crasni/rotary-inverted-pendulum/docs/results/hardware/pid/20261107_161650/note.md

First PID hardware pass. Preset pid_my_rig_lqr_match.json (delay predictor, gains from the LQR solution, Ki = 10).
