crasni/rotary-inverted-pendulum/docs/results/hardware/ppo/20261109_013006/note.md

ppo_ecF (+ random delay and arm lag): no runaway spin, but recovery too slow (caught at 10.7 s).
