crasni/rotary-inverted-pendulum/docs/results/hardware/sac/20261107_163412/note.md

Stopped by hand. Pendulum reading frozen at 179.9° while the arm swung ±4 rad/s: encoder stall or pendulum held. Not a policy result.
