crasni/rotary-inverted-pendulum/docs/results/hardware/sac/20261109_004522/note.md

Encoder fault (bits=2) latched before the start; no policy ticks. Not a policy result.
