crasni/rotary-inverted-pendulum/docs/run-history/runs_index.csv

run | family | when | meta_files | has_policy | policy_sha256 | n_files | mb_total | mb_pruned | checkpoint | stage | deterministic | episodes_requested | episodes_completed | stop_reason | started | episodes | successes | mean_balanced_frac | best_longest_balance_s | stop_reasons | command | algorithm | params | config | duration | source | seed | learning_rate | method | parent | steps | n_batches | learn | real_fraction
accel_chirp_real_003 | accel_chirp_real | 2026-11-06 21:21 (mtime) | metadata.json | 0 |  | 4 | 0.21 | 0.0
accel_chirp_sim_003 | accel_chirp_sim | 2026-11-06 21:18 (mtime) | metadata.json | 0 |  | 3 | 0.16 | 0.0
accel_reversal_1 | accel_reversal_1 | 2026-11-07 20:17 (mtime) | metadata.json | 0 |  | 2 | 0.02 | 0.0
accel_reversal_2 | accel_reversal_2 | 2026-11-07 20:17 (mtime) | metadata.json | 0 |  | 4 | 0.18 | 0.0
accel_reversal_sim | accel_reversal_sim | 2026-11-07 20:15 (mtime) | metadata.json | 0 |  | 3 | 0.12 | 0.0
accel_step_full_1 | accel_step_full_1 | 2026-11-07 20:12 (mtime) | metadata.json | 0 |  | 2 | 0.01 | 0.0
accel_step_real_008 | accel_step_real | 2026-11-06 21:18 (mtime) | metadata.json | 0 |  | 4 | 0.16 | 0.0
accel_step_sim_008 | accel_step_sim | 2026-11-06 21:17 (mtime) | metadata.json | 0 |  | 3 | 0.11 | 0.0
archive/curriculum/e03_v2_lqrbalance_det | archive | 2026-11-07 23:32 (mtime) | batch.json | 0 |  | 1 | 0.0 | 0.0 | runs/curriculum/versions/v2/policy.zip | lqr_balance | True | 4 | 0 | NonFiniteFeedback: Non-finite feedback | 2026-11-07T23:32:10
archive/curriculum/e03b_v2_lqrbalance_det | archive | 2026-11-07 23:34 (mtime) | batch.json | 0 |  | 1 | 0.0 | 0.0 | runs/curriculum/versions/v2/policy.zip | lqr_balance | True | 4 | 0 | NonFiniteFeedback: Non-finite feedback (firmware fault bits=2: encoder) | 2026-11-07T23:34:47
archive/curriculum/e03c_v2_lqrbalance_det | archive | 2026-11-07 23:57 (mtime) | batch.json | 0 |  | 1 | 0.0 | 0.0 | runs/curriculum/versions/v2/policy.zip | lqr_balance | True | 4 | 0 | NonFiniteFeedback: Non-finite feedback (firmware fault bits=2: encoder) | 2026-11-07T23:57:11
archive/custom_lqrdither_20261107_204719 | archive | 2026-11-07 20:47 | run.json summary.json | 0 |  | 3 | 0.0 | 0.0 | docs/results/sac_focused_policy.zip |  |  |  |  |  |  | 1 | 0 |  |  | RuntimeError: Firmware safety fault latched (bits=2); inspect before resetting | hardware | custom | configs/my_rig.json | configs/custom_lqr_dither_10.json | 15.0
archive/custom_lqrdither_20261107_205245 | archive | 2026-11-07 20:52 | run.json summary.json | 0 |  | 3 | 0.0 | 0.0 | docs/results/sac_focused_policy.zip |  |  |  |  |  |  | 1 | 0 |  |  | SerialException: [Errno 2] could not open port /dev/ttyUSB0: [Errno 2] No such file or directory: '/dev/ttyUSB0' | hardware | custom | configs/my_rig.json | configs/custom_lqr_dither_10.json | 15.0
archive/lqr_coupling_delay_20261108_000207 | archive | 2026-11-08 00:02 | run.json summary.json | 0 |  | 3 | 0.01 | 0.0 | docs/results/sac_focused_policy.zip |  |  |  |  |  |  | 1 | 0 | 0.34 | 1.08 | RuntimeError: Non-finite feedback (firmware fault bits=2, encoder) | hardware | lqr | configs/my_rig.json | configs/lqr_my_rig_coupling_delay.json | 15.0
archive/lqr_coupling_delay_20261108_000854 | archive | 2026-11-08 00:08 | run.json summary.json | 0 |  | 3 | 0.0 | 0.0 | docs/results/sac_focused_policy.zip |  |  |  |  |  |  | 1 | 0 |  |  | SerialException: [Errno 2] could not open port /dev/ttyUSB0: [Errno 2] No such file or directory: '/dev/ttyUSB0' | hardware | lqr | configs/my_rig.json | configs/lqr_my_rig_coupling_delay.json | 15.0
archive/lqr_coupling_delay_20261108_000913 | archive | 2026-11-08 00:09 | run.json summary.json | 0 |  | 3 | 0.01 | 0.0 | docs/results/sac_focused_policy.zip |  |  |  |  |  |  | 1 | 0 | 0.262 | 0.74 | RuntimeError: Non-finite feedback (firmware fault bits=2, encoder) | hardware | lqr | configs/my_rig.json | configs/lqr_my_rig_coupling_delay.json | 15.0
archive/lqr_coupling_delay_20261108_000928 | archive | 2026-11-08 00:09 | run.json summary.json | 0 |  | 3 | 0.01 | 0.0 | docs/results/sac_focused_policy.zip |  |  |  |  |  |  | 1 | 0 | 0.173 | 0.44 | RuntimeError: Non-finite feedback (firmware fault bits=2, encoder) | hardware | lqr | configs/my_rig.json | configs/lqr_my_rig_coupling_delay.json | 15.0
archive/lqr_coupling_delay_20261108_000953 | archive | 2026-11-08 00:09 | run.json summary.json | 0 |  | 3 | 0.01 | 0.0 | docs/results/sac_focused_policy.zip |  |  |  |  |  |  | 1 | 0 | 0.006 | 0.02 | RuntimeError: Non-finite feedback (firmware fault bits=2, encoder) | hardware | lqr | configs/my_rig.json | configs/lqr_my_rig_coupling_delay.json | 15.0
archive/lqr_coupling_delay_20261108_001013 | archive | 2026-11-08 00:10 | run.json summary.json | 0 |  | 3 | 0.01 | 0.0 | docs/results/sac_focused_policy.zip |  |  |  |  |  |  | 1 | 0 | 0.072 | 0.14 | RuntimeError: Non-finite feedback (firmware fault bits=2, encoder) | hardware | lqr | configs/my_rig.json | configs/lqr_my_rig_coupling_delay.json | 15.0
archive/lqr_coupling_delay_20261108_001032 | archive | 2026-11-08 00:10 | run.json summary.json | 0 |  | 3 | 0.01 | 0.0 | docs/results/sac_focused_policy.zip |  |  |  |  |  |  | 1 | 0 | 0.025 | 0.06 | RuntimeError: Non-finite feedback (firmware fault bits=2, encoder) | hardware | lqr | configs/my_rig.json | configs/lqr_my_rig_coupling_delay.json | 15.0
archive/lqr_coupling_delay_20261108_001527 | archive | 2026-11-08 00:15 | run.json summary.json | 0 |  | 3 | 0.01 | 0.0 | docs/results/sac_focused_policy.zip |  |  |  |  |  |  | 1 | 0 | 0.0 | 0.0 | RuntimeError: Non-finite feedback (firmware fault bits=2, encoder) | hardware | lqr | configs/my_rig.json | configs/lqr_my_rig_coupling_delay.json | 15.0
archive/lqr_coupling_delay_20261108_001543. | archive | 2026-11-08 00:15 | run.json summary.json | 0 |  | 3 | 0.01 | 0.0 | docs/results/sac_focused_policy.zip |  |  |  |  |  |  | 1 | 0 | 0.025 | 0.06 | RuntimeError: Non-finite feedback (firmware fault bits=2, encoder) | hardware | lqr | configs/my_rig.json | configs/lqr_my_rig_coupling_delay.json | 15.0
archive/lqr_coupling_delay_20261108_001600 | archive | 2026-11-08 00:16 | run.json summary.json | 0 |  | 3 | 0.0 | 0.0 | docs/results/sac_focused_policy.zip |  |  |  |  |  |  | 1 | 0 |  |  | RuntimeError: Powered run cancelled | hardware | lqr | configs/my_rig.json | configs/lqr_my_rig_coupling_delay.json | 15.0
archive/lqr_coupling_delay_20261108_001608 | archive | 2026-11-08 00:16 | run.json summary.json | 0 |  | 3 | 0.01 | 0.0 | docs/results/sac_focused_policy.zip |  |  |  |  |  |  | 1 | 0 | 0.0 | 0.0 | RuntimeError: Non-finite feedback (firmware fault bits=2, encoder) | hardware | lqr | configs/my_rig.json | configs/lqr_my_rig_coupling_delay.json | 15.0
archive/lqr_coupling_delay_20261108_025531 | archive | 2026-11-08 02:55 | run.json summary.json | 0 |  | 3 | 0.0 | 0.0 | docs/results/sac_focused_policy.zip |  |  |  |  |  |  | 1 | 0 |  |  | RuntimeError: Firmware safety fault latched (bits=2); inspect before resetting | hardware | lqr | configs/my_rig.json | configs/lqr_my_rig_coupling_delay.json | 15.0
archive/lqr_coupling_delay_20261108_025545 | archive | 2026-11-08 02:55 | run.json summary.json | 0 |  | 3 | 0.0 | 0.0 | docs/results/sac_focused_policy.zip |  |  |  |  |  |  | 1 | 0 |  |  | RuntimeError: Firmware safety fault latched (bits=2); inspect before resetting | hardware | lqr | configs/my_rig.json | configs/lqr_my_rig_coupling_delay.json | 15.0
archive/lqr_coupling_delay_20261108_025813 | archive | 2026-11-08 02:58 | run.json summary.json | 0 |  | 3 | 0.02 | 0.0 | docs/results/sac_focused_policy.zip |  |  |  |  |  |  | 1 | 0 | 0.019 | 0.08 | RuntimeError: Non-finite feedback (firmware fault bits=2, encoder) | hardware | lqr | configs/my_rig.json | configs/lqr_my_rig_coupling_delay.json | 15.0
archive/lqr_coupling_delay_20261108_025945 | archive | 2026-11-08 02:59 | run.json summary.json | 0 |  | 3 | 0.0 | 0.0 | docs/results/sac_focused_policy.zip |  |  |  |  |  |  | 1 | 0 |  |  | RuntimeError: Firmware READY handshake failed | hardware | lqr | configs/my_rig.json | configs/lqr_my_rig_coupling_delay.json | 15.0
archive/lqr_hw_17 | archive | 2026-11-07 02:04 (mtime) | run.json summary.json | 0 |  | 3 | 0.02 | 0.0 | docs/results/sac_focused_policy.zip |  |  |  |  |  |  | 1 | 0 | 0.143 | 0.32 | RuntimeError: Non-finite feedback | hardware | lqr | configs/my_rig.json | configs/lqr_my_rig_observed.json | 15.0
archive/lqr_swing_20261107_025003 | archive | 2026-11-07 02:50 | run.json summary.json | 0 |  | 3 | 0.09 | 0.0 | docs/results/sac_focused_policy.zip |  |  |  |  |  |  | 1 | 0 | 0.11 | 1.0 | KeyboardInterrupt: | hardware | lqr | configs/my_rig.json | configs/lqr_my_rig_swing.json | 30.0
archive/sac_W2_20261107_205411 | archive | 2026-11-07 20:54 | run.json summary.json | 0 |  | 3 | 0.0 | 0.0 | runs/sac_finetune/W_rig/W2_100k.zip |  |  |  |  |  |  | 1 | 0 |  |  | RuntimeError: Start requires a physically centered arm and still hanging pendulum | hardware | sac | configs/my_rig.json | configs/sac_my_rig.json | 15.0
archive/sac_v2m2_20261108_031006 | archive | 2026-11-08 03:10 | run.json | 0 |  | 1 | 0.0 | 0.0 | runs/curriculum/versions/v2m2/policy.zip |  |  |  |  |  |  |  |  |  |  |  | hardware | sac | configs/my_rig.json | configs/sac_my_rig.json | 15.0
archive/sac_v2m2_20261108_031340 | archive | 2026-11-08 03:13 | run.json summary.json | 0 |  | 3 | 0.0 | 0.0 | runs/curriculum/versions/v2m2_runner/policy.zip |  |  |  |  |  |  | 1 | 0 |  |  | RuntimeError: Firmware safety fault latched (bits=2); inspect before resetting | hardware | sac | configs/my_rig.json | configs/sac_my_rig.json | 15.0
archive/sac_v2m2_20261108_031741 | archive | 2026-11-08 03:17 | run.json | 0 |  | 1 | 0.0 | 0.0 | runs/curriculum/versions/v2m2/policy.zip |  |  |  |  |  |  |  |  |  |  |  | hardware | sac | configs/my_rig.json | configs/sac_my_rig.json | 15.0
archive/sac_v2m2_20261108_031758 | archive | 2026-11-08 03:17 | run.json summary.json | 0 |  | 3 | 0.0 | 0.0 | runs/curriculum/versions/v2m2_runner/policy.zip |  |  |  |  |  |  | 1 | 0 |  |  | KeyboardInterrupt: | hardware | sac | configs/my_rig.json | configs/sac_my_rig.json | 15.0
archive/sac_v2m2_20261108_031911 | archive | 2026-11-08 03:19 | run.json summary.json | 0 |  | 3 | 0.03 | 0.0 | runs/curriculum/versions/v2m2_runner/policy.zip |  |  |  |  |  |  | 1 | 0 | 0.0 | 0.0 | KeyboardInterrupt: | hardware | sac | configs/my_rig.json | configs/sac_my_rig.json | 15.0
archive/sac_v2m2_20261108_031931 | archive | 2026-11-08 03:19 | run.json summary.json | 0 |  | 3 | 0.0 | 0.0 | runs/curriculum/versions/v2m2_runner/policy.zip |  |  |  |  |  |  | 1 | 0 |  |  | RuntimeError: Powered run cancelled | hardware | sac | configs/my_rig.json | configs/sac_my_rig.json | 15.0
archive/sac_v2m2_20261108_032213 | archive | 2026-11-08 03:22 | run.json | 0 |  | 1 | 0.0 | 0.0 | runs/curriculum/versions/v2m2/policy.zip |  |  |  |  |  |  |  |  |  |  |  | hardware | sac | configs/my_rig.json | configs/sac_my_rig.json | 15.0
archive/sac_v6b_20261108_041929 | archive | 2026-11-08 04:19 | run.json | 0 |  | 1 | 0.0 | 0.0 | runs/curriculum/versions/v6b_runner/policy.zip |  |  |  |  |  |  |  |  |  |  |  | hardware | sac | configs/my_rig.json | configs/sac_my_rig.json | 15.0
archive/sac_v6b_20261108_041936 | archive | 2026-11-08 04:19 | run.json | 0 |  | 1 | 0.0 | 0.0 | runs/curriculum/versions/v6b_runner/policy.zip |  |  |  |  |  |  |  |  |  |  |  | hardware | sac | configs/my_rig.json | configs/sac_my_rig.json | 15.0
before_changes_20261106_211040/accel_chirp_real_002 | before_changes | 2026-11-06 21:10 | metadata.json | 0 |  | 4 | 0.21 | 0.0
before_changes_20261106_211040/accel_chirp_sim_002 | before_changes | 2026-11-06 21:10 | metadata.json | 0 |  | 3 | 0.17 | 0.0
before_changes_20261106_211040/accel_step_real | before_changes | 2026-11-06 21:10 | metadata.json | 0 |  | 2 | 0.01 | 0.0
before_changes_20261106_211040/accel_step_real_008 | before_changes | 2026-11-06 21:10 | metadata.json | 0 |  | 4 | 0.16 | 0.0
before_changes_20261106_211040/accel_step_sim | before_changes | 2026-11-06 21:10 | metadata.json | 0 |  | 3 | 0.11 | 0.0
before_changes_20261106_211040/accel_step_sim_008 | before_changes | 2026-11-06 21:10 | metadata.json | 0 |  | 3 | 0.11 | 0.0
before_changes_20261106_211040/sysid_holdout_01 | before_changes | 2026-11-06 21:10 | metadata.json | 0 |  | 5 | 0.14 | 0.0
before_changes_20261106_211040/sysid_train_01 | before_changes | 2026-11-06 21:10 | metadata.json | 0 |  | 8 | 0.37 | 0.0
curriculum/b00_v1_balance_det | curriculum/batches | 2026-11-07 22:33 (mtime) | batch.json summary.json | 0 |  | 5 | 0.1 | 0.0 | runs/sac_finetune/V1/policy.zip | balance | True | 4 | 3 | SessionStop: lift failed 3 times in a row | 2026-11-07T22:32:31 | 3 | 0 |  | 0.0 | lift_timeout
curriculum/b02_v1_lqrbalance_det | curriculum/batches | 2026-11-07 22:47 (mtime) | batch.json summary.json | 0 |  | 9 | 0.3 | 0.0 | runs/sac_finetune/V1/policy.zip | lqr_balance | True | 4 | 4 | completed | 2026-11-07T22:45:05 | 4 | 0 | 0.186 | 1.42 | duration;lift_timeout
curriculum/b03_v1_lqrbalance_train | curriculum/batches | 2026-11-07 22:52 (mtime) | batch.json summary.json | 0 |  | 9 | 0.33 | 0.0 | runs/sac_finetune/V1/policy.zip | lqr_balance | False | 10 | 5 | SessionStop: lift failed 3 times in a row | 2026-11-07T22:49:50 | 5 | 0 | 0.39 | 2.86 | duration;lift_timeout
curriculum/b04_v1_lqrbalance_train | curriculum/batches | 2026-11-07 22:58 (mtime) | batch.json summary.json | 0 |  | 21 | 0.85 | 0.0 | runs/sac_finetune/V1/policy.zip | lqr_balance | False | 10 | 10 | KeyboardInterrupt: | 2026-11-07T22:53:30 | 10 | 0 | 0.274 | 2.76 | duration;lift_timeout
curriculum/b05_v1_lqrbalance_train | curriculum/batches | 2026-11-07 23:16 (mtime) | batch.json summary.json | 0 |  | 28 | 0.62 | 0.0 | runs/sac_finetune/V1/policy.zip | lqr_balance | False | 20 | 16 | SessionStop: lift failed 3 times in a row | 2026-11-07T23:09:51 | 16 | 0 | 0.342 | 0.64 | fell;lift_timeout
curriculum/b06_v2m2_hanging_train | curriculum/batches | 2026-11-08 03:31 (mtime) | batch.json summary.json | 0 |  | 22 | 1.16 | 0.0 | runs/curriculum/versions/v2m2/policy.zip | hanging | False | 10 | 10 | completed | 2026-11-08T03:27:55 | 10 | 0 | 0.236 | 2.66 | duration
curriculum/b07_v3b_hanging_train | curriculum/batches | 2026-11-08 03:51 (mtime) | batch.json summary.json | 0 |  | 22 | 1.14 | 0.0 | runs/curriculum/versions/v3b/policy.zip | hanging | False | 10 | 10 | completed | 2026-11-08T03:48:44 | 10 | 0 | 0.377 | 10.28 | duration
curriculum/b08_v3b_hanging_train | curriculum/batches | 2026-11-08 04:06 (mtime) | batch.json summary.json | 0 |  | 22 | 1.15 | 0.0 | runs/curriculum/versions/v3b/policy.zip | hanging | False | 10 | 10 | completed | 2026-11-08T04:03:18 | 10 | 0 | 0.251 | 5.9 | duration
curriculum/b09_v9_hanging_train | curriculum/batches | 2026-11-08 21:07 (mtime) | batch.json summary.json | 0 |  | 22 | 1.17 | 0.0 | runs/curriculum/versions/v9/policy.zip | hanging | False | 10 | 10 | completed | 2026-11-08T21:04:17 | 10 | 0 | 0.12 | 3.1 | duration
curriculum/e01_v1_lqrbalance_det | curriculum/batches | 2026-11-07 23:02 (mtime) | batch.json summary.json | 0 |  | 10 | 0.31 | 0.0 | runs/curriculum/versions/v1/policy.zip | lqr_balance | True | 4 | 4 | completed | 2026-11-07T23:01:00 | 4 | 0 | 0.094 | 1.04 | duration
curriculum/e02_v1_hanging_det | curriculum/batches | 2026-11-07 23:04 (mtime) | batch.json summary.json | 0 |  | 10 | 0.62 | 0.0 | runs/curriculum/versions/v1/policy.zip | hanging | True | 4 | 4 | completed | 2026-11-07T23:02:52 | 4 | 0 | 0.009 | 0.3 | duration
curriculum/e04_v2_lqrbalance_det | curriculum/batches | 2026-11-08 03:02 (mtime) | batch.json summary.json | 0 |  | 10 | 0.08 | 0.0 | runs/curriculum/versions/v2/policy.zip | lqr_balance | True | 4 | 4 | completed | 2026-11-08T03:01:59 | 4 | 0 | 0.43 | 0.74 | fell
curriculum/e05_v2m2_lqrbalance_det | curriculum/batches | 2026-11-08 03:06 (mtime) | batch.json summary.json | 0 |  | 10 | 0.23 | 0.0 | runs/curriculum/versions/v2m2/policy.zip | lqr_balance | True | 4 | 4 | completed | 2026-11-08T03:04:54 | 4 | 0 | 1.0 | 6.0 | duration
curriculum/e06_v2m2_hanging_det | curriculum/batches | 2026-11-08 03:09 (mtime) | batch.json summary.json | 0 |  | 10 | 0.59 | 0.0 | runs/curriculum/versions/v2m2/policy.zip | hanging | True | 4 | 4 | completed | 2026-11-08T03:08:08 | 4 | 0 | 0.53 | 13.32 | duration
curriculum/e06_v2m2_hanging_det_2 | curriculum/batches | 2026-11-08 03:27 (mtime) | batch.json summary.json | 0 |  | 10 | 0.61 | 0.0 | runs/curriculum/versions/v2m2/policy.zip | hanging | True | 4 | 4 | completed | 2026-11-08T03:25:19 | 4 | 0 | 0.212 | 3.72 | duration
curriculum/e07_v3_hanging_det | curriculum/batches | 2026-11-08 03:35 (mtime) | batch.json summary.json | 0 |  | 10 | 0.46 | 0.0 | runs/curriculum/versions/v3/policy.zip | hanging | True | 4 | 4 | completed | 2026-11-08T03:33:42 | 4 | 0 | 0.174 | 5.18 | duration
curriculum/e08_v3b_hanging_det | curriculum/batches | 2026-11-08 03:39 (mtime) | batch.json summary.json | 0 |  | 10 | 0.44 | 0.0 | runs/curriculum/versions/v3b/policy.zip | hanging | True | 4 | 4 | completed | 2026-11-08T03:38:23 | 4 | 0 | 0.458 | 8.96 | duration
curriculum/e08_v3b_hanging_det_2 | curriculum/batches | 2026-11-08 03:44 (mtime) | batch.json summary.json | 0 |  | 10 | 0.47 | 0.0 | runs/curriculum/versions/v3b/policy.zip | hanging | True | 4 | 4 | completed | 2026-11-08T03:43:18 | 4 | 0 | 0.16 | 2.46 | duration
curriculum/e09_v5_hanging_det | curriculum/batches | 2026-11-08 04:08 (mtime) | batch.json summary.json | 0 |  | 10 | 0.47 | 0.0 | runs/curriculum/versions/v5/policy.zip | hanging | True | 4 | 4 | completed | 2026-11-08T04:06:57 | 4 | 0 | 0.0 | 0.0 | duration
curriculum/e10_v6b_hanging_det | curriculum/batches | 2026-11-08 04:18 (mtime) | batch.json summary.json | 0 |  | 10 | 0.45 | 0.0 | runs/curriculum/versions/v6b/policy.zip | hanging | True | 4 | 4 | completed | 2026-11-08T04:16:53 | 4 | 1 | 0.357 | 12.0 | duration
curriculum/e11_v7_hanging_det | curriculum/batches | 2026-11-08 04:27 (mtime) | batch.json summary.json | 0 |  | 10 | 0.45 | 0.0 | runs/curriculum/versions/v7/policy.zip | hanging | True | 4 | 4 | completed | 2026-11-08T04:25:44 | 4 | 0 | 0.254 | 9.22 | duration
curriculum/e12_v7_hanging_det_r1 | curriculum/batches | 2026-11-08 20:38 (mtime) | batch.json | 0 |  | 1 | 0.0 | 0.0 | runs/curriculum/versions/v7/policy.zip | hanging | True | 4 |  |  | 2026-11-08T20:38:21
curriculum/e12_v7_hanging_det_r1b | curriculum/batches | 2026-11-08 20:49 (mtime) | batch.json summary.json | 0 |  | 10 | 0.46 | 0.0 | runs/curriculum/versions/v7/policy.zip | hanging | True | 4 | 4 | completed | 2026-11-08T20:47:58 | 4 | 0 | 0.326 | 5.24 | duration
curriculum/e12_v8_hanging_det_r1 | curriculum/batches | 2026-11-08 20:46 (mtime) | batch.json summary.json | 0 |  | 10 | 0.47 | 0.0 | runs/curriculum/versions/v8/policy.zip | hanging | True | 4 | 4 | completed | 2026-11-08T20:45:05 | 4 | 0 | 0.221 | 1.54 | duration
curriculum/e13_v7_hanging_det_r1 | curriculum/batches | 2026-11-08 20:58 (mtime) | batch.json summary.json | 0 |  | 10 | 0.47 | 0.0 | runs/curriculum/versions/v7/policy.zip | hanging | True | 4 | 4 | completed | 2026-11-08T20:57:17 | 4 | 0 | 0.216 | 4.48 | duration
curriculum/e13_v7_hanging_det_r2 | curriculum/batches | 2026-11-08 21:01 (mtime) | batch.json summary.json | 0 |  | 10 | 0.46 | 0.0 | runs/curriculum/versions/v7/policy.zip | hanging | True | 4 | 4 | completed | 2026-11-08T21:00:02 | 4 | 0 | 0.251 | 4.78 | duration
curriculum/e13_v7_hanging_det_r3 | curriculum/batches | 2026-11-08 21:04 (mtime) | batch.json summary.json | 0 |  | 10 | 0.47 | 0.0 | runs/curriculum/versions/v7/policy.zip | hanging | True | 4 | 4 | completed | 2026-11-08T21:02:49 | 4 | 0 | 0.137 | 1.58 | duration
curriculum/e13_v9_hanging_det_r1 | curriculum/batches | 2026-11-08 20:57 (mtime) | batch.json summary.json | 0 |  | 10 | 0.47 | 0.0 | runs/curriculum/versions/v9/policy.zip | hanging | True | 4 | 4 | completed | 2026-11-08T20:55:55 | 4 | 0 | 0.215 | 2.48 | duration
curriculum/e13_v9_hanging_det_r2 | curriculum/batches | 2026-11-08 21:00 (mtime) | batch.json summary.json | 0 |  | 10 | 0.47 | 0.0 | runs/curriculum/versions/v9/policy.zip | hanging | True | 4 | 4 | completed | 2026-11-08T20:58:40 | 4 | 0 | 0.269 | 4.16 | duration
curriculum/e13_v9_hanging_det_r3 | curriculum/batches | 2026-11-08 21:02 (mtime) | batch.json summary.json | 0 |  | 10 | 0.47 | 0.0 | runs/curriculum/versions/v9/policy.zip | hanging | True | 4 | 4 | completed | 2026-11-08T21:01:27 | 4 | 0 | 0.194 | 3.52 | duration
curriculum/e14_s01e15_hanging_det | curriculum/batches | 2026-11-08 22:53 (mtime) | batch.json summary.json | 0 |  | 10 | 0.45 | 0.0 | runs/curriculum/versions/s01e15/policy.zip | hanging | True | 4 | 4 | completed | 2026-11-08T22:51:46 | 4 | 0 | 0.399 | 7.72 | duration
curriculum/e14_s01e17_hanging_det | curriculum/batches | 2026-11-08 22:54 (mtime) | batch.json summary.json | 0 |  | 10 | 0.47 | 0.0 | runs/curriculum/versions/s01e17/policy.zip | hanging | True | 4 | 4 | completed | 2026-11-08T22:53:07 | 4 | 0 | 0.19 | 4.02 | duration
curriculum/e15_s01e49_hanging_det_r1 | curriculum/batches | 2026-11-08 22:57 (mtime) | batch.json summary.json | 0 |  | 10 | 0.46 | 0.0 | runs/curriculum/versions/s01e49/policy.zip | hanging | True | 4 | 4 | completed | 2026-11-08T22:56:40 | 4 | 0 | 0.326 | 8.88 | duration
curriculum/e15_s01e49_hanging_det_r2 | curriculum/batches | 2026-11-08 23:00 (mtime) | batch.json summary.json | 0 |  | 10 | 0.46 | 0.0 | runs/curriculum/versions/s01e49/policy.zip | hanging | True | 4 | 4 | completed | 2026-11-08T22:59:31 | 4 | 0 | 0.337 | 7.8 | duration
curriculum/e15_s01e49_hanging_det_r3 | curriculum/batches | 2026-11-08 23:04 (mtime) | batch.json summary.json | 0 |  | 10 | 0.46 | 0.0 | runs/curriculum/versions/s01e49/policy.zip | hanging | True | 4 | 4 | completed | 2026-11-08T23:03:30 | 4 | 0 | 0.264 | 7.2 | duration
curriculum/e15_v3b_runner_hanging_det_r1 | curriculum/batches | 2026-11-08 22:59 (mtime) | batch.json summary.json | 0 |  | 10 | 0.46 | 0.0 | runs/curriculum/versions/v3b_runner/policy.zip | hanging | True | 4 | 4 | completed | 2026-11-08T22:58:12 | 4 | 0 | 0.219 | 5.76 | duration
curriculum/e15_v3b_runner_hanging_det_r2 | curriculum/batches | 2026-11-08 23:03 (mtime) | batch.json summary.json | 0 |  | 10 | 0.46 | 0.0 | runs/curriculum/versions/v3b_runner/policy.zip | hanging | True | 4 | 4 | completed | 2026-11-08T23:02:11 | 4 | 0 | 0.214 | 3.32 | duration
curriculum/e15_v3b_runner_hanging_det_r3 | curriculum/batches | 2026-11-08 23:08 (mtime) | batch.json summary.json | 0 |  | 10 | 0.47 | 0.0 | runs/curriculum/versions/v3b_runner/policy.zip | hanging | True | 4 | 4 | completed | 2026-11-08T23:06:08 | 4 | 0 | 0.233 | 4.2 | duration
curriculum/e15_v6b_runner_hanging_det_r1 | curriculum/batches | 2026-11-08 22:58 (mtime) | batch.json | 0 |  | 1 | 0.0 | 0.0 | runs/curriculum/versions/v6b_runner/policy.zip | hanging | True | 4 | 0 | RuntimeError: Powered session cancelled | 2026-11-08T22:58:00
curriculum/e15_v6b_runner_hanging_det_r2 | curriculum/batches | 2026-11-08 23:02 (mtime) | batch.json summary.json | 0 |  | 10 | 0.47 | 0.0 | runs/curriculum/versions/v6b_runner/policy.zip | hanging | True | 4 | 4 | completed | 2026-11-08T23:00:52 | 4 | 0 | 0.086 | 0.66 | duration
curriculum/e15_v6b_runner_hanging_det_r3 | curriculum/batches | 2026-11-08 23:06 (mtime) | batch.json summary.json | 0 |  | 10 | 0.47 | 0.0 | runs/curriculum/versions/v6b_runner/policy.zip | hanging | True | 4 | 4 | completed | 2026-11-08T23:04:49 | 4 | 0 | 0.073 | 0.84 | duration
curriculum/e16_sm2_hanging_det_r1 | curriculum/batches | 2026-11-08 23:36 (mtime) | batch.json summary.json | 0 |  | 10 | 0.45 | 0.0 | runs/curriculum/versions/sm2/policy.zip | hanging | True | 4 | 4 | completed | 2026-11-08T23:35:03 | 4 | 0 | 0.359 | 7.42 | duration
curriculum/e16_sm2_hanging_det_r2 | curriculum/batches | 2026-11-08 23:37 (mtime) | batch.json | 0 |  | 1 | 0.0 | 0.0 | runs/curriculum/versions/sm2/policy.zip | hanging | True | 4 | 0 | RuntimeError: Start requires a physically centered arm and still hanging pendulum | 2026-11-08T23:37:42
curriculum/e16_sm2_hanging_det_r3 | curriculum/batches | 2026-11-08 23:40 (mtime) | batch.json summary.json | 0 |  | 10 | 0.47 | 0.0 | runs/curriculum/versions/sm2/policy.zip | hanging | True | 4 | 4 | completed | 2026-11-08T23:39:06 | 4 | 0 | 0.107 | 1.02 | duration
curriculum/e16_sm5_hanging_det_r1 | curriculum/batches | 2026-11-08 23:35 (mtime) | batch.json summary.json | 0 |  | 10 | 0.47 | 0.0 | runs/curriculum/versions/sm5/policy.zip | hanging | True | 4 | 4 | completed | 2026-11-08T23:33:44 | 4 | 0 | 0.114 | 0.7 | duration
curriculum/e16_sm5_hanging_det_r2 | curriculum/batches | 2026-11-08 23:37 (mtime) | batch.json summary.json | 0 |  | 10 | 0.47 | 0.0 | runs/curriculum/versions/sm5/policy.zip | hanging | True | 4 | 4 | completed | 2026-11-08T23:36:24 | 4 | 0 | 0.172 | 1.44 | duration
curriculum/e16_sm5_hanging_det_r3 | curriculum/batches | 2026-11-08 23:39 (mtime) | batch.json summary.json | 0 |  | 10 | 0.47 | 0.0 | runs/curriculum/versions/sm5/policy.zip | hanging | True | 4 | 4 | completed | 2026-11-08T23:37:46 | 4 | 0 | 0.127 | 1.58 | duration
curriculum/e17_rnA_quick | curriculum/batches | 2026-11-09 00:07 (mtime) | batch.json summary.json | 0 |  | 10 | 0.46 | 0.0 | runs/curriculum/versions/rnA/policy.zip | hanging | True | 4 | 4 | completed | 2026-11-09T00:05:48 | 4 | 0 | 0.196 | 5.28 | duration
curriculum/e17_rnC_quick | curriculum/batches | 2026-11-09 00:07 (mtime) | batch.json summary.json | 0 |  | 4 | 0.12 | 0.0 | runs/curriculum/versions/rnC/policy.zip | hanging | True | 4 | 1 | KeyboardInterrupt: | 2026-11-09T00:07:19 | 1 | 0 | 0.181 | 0.5 | duration
curriculum/e18_rnA_fixed | curriculum/batches | 2026-11-09 00:44 (mtime) | batch.json summary.json | 0 |  | 6 | 0.22 | 0.0 | runs/curriculum/versions/rnA/policy.zip | hanging | True | 4 | 2 | KeyboardInterrupt: | 2026-11-09T00:43:20 | 2 | 0 | 0.755 | 13.02 | duration
curriculum/e19_ppo_rn | curriculum/batches | 2026-11-09 01:02 (mtime) | batch.json | 0 |  | 1 | 0.0 | 0.0 | runs/curriculum/versions/ppo_rn/policy.zip | hanging | True | 4 |  |  | 2026-11-09T01:02:05
curriculum/s01_v6b_online | curriculum/batches | 2026-11-08 22:38 (mtime) | batch.json summary.json | 1 | 3190fd8c280abcea830430675f7894daaa5f860ce4e70c2ac344081035546ade | 223 | 5956.06 | 5839.86 | runs/curriculum/versions/v6b_runner/policy.zip | online | False |  | 60 | completed | 2026-11-08T22:14:58 | 60 | 1 | 0.625 | 10.9 | duration;fell;lift_timeout
curriculum/versions/dqn_rn | curriculum/versions | 2026-11-09 00:55 (mtime) | training.json | 1 | 6cd41ee7937d5a7771f9882369054852406f4fd36831d4ef66ecf7b9ec5861a9 | 51 | 8.85 | 8.5 |  |  |  |  |  |  |  |  |  |  |  |  |  |  |  |  |  | docs/results/rig_rl_disturbance/dqn_long/policy.zip | 73 | 0.0001
curriculum/versions/dqn_rn05 | curriculum/versions | 2026-11-09 00:58 (mtime) | training.json | 1 | 37be389e831b834e92ddee59cb2fe7726fd4fdd527dd23a87e89d4bcb7c7939f | 35 | 6.02 | 5.67 |  |  |  |  |  |  |  |  |  |  |  |  |  |  |  |  |  | docs/results/rig_rl_disturbance/dqn_long/policy.zip | 73 | 0.0001
curriculum/versions/ppo_ecA | curriculum/versions | 2026-11-09 01:15 (mtime) | training.json | 1 | c6d452f1a94ff310c5151c8045c28bfa4a5b15d8ad3731a937e24ea593fc2bb7 | 18 | 8.69 | 8.18 |  |  |  |  |  |  |  |  |  |  |  |  |  |  |  |  |  | docs/results/rig_rl_disturbance/ppo_long/policy.zip | 73 | 0.0003
curriculum/versions/ppo_ecB | curriculum/versions | 2026-11-09 01:15 (mtime) | training.json | 1 | 1fea683b45a417d4bd7b17e101f4aa5d69944ddc7a639296c98deca23511ca40 | 18 | 8.69 | 8.18 |  |  |  |  |  |  |  |  |  |  |  |  |  |  |  |  |  | docs/results/rig_rl_disturbance/ppo_long/policy.zip | 73 | 0.0003
curriculum/versions/ppo_ecC | curriculum/versions | 2026-11-09 01:15 (mtime) | training.json | 1 | d449ac83500394bc1d2bfbacabc9dcc5a57f2197a27f8800881c47fbd6750311 | 18 | 8.69 | 8.18 |  |  |  |  |  |  |  |  |  |  |  |  |  |  |  |  |  | docs/results/rig_rl_disturbance/ppo_long/policy.zip | 73 | 0.0003
curriculum/versions/ppo_ecD | curriculum/versions | 2026-11-09 01:24 (mtime) | training.json | 1 | fb53f3d46263b240bfc5c6c9140cc20d419e53ac9b57600725676bd9b1f578c4 | 42 | 20.96 | 20.45 |  |  |  |  |  |  |  |  |  |  |  |  |  |  |  |  |  | docs/results/rig_rl_disturbance/ppo_long/policy.zip | 73 | 0.0003
curriculum/versions/ppo_ecE | curriculum/versions | 2026-11-09 01:26 (mtime) | training.json | 1 | 61f80916c01cb9046212e14f778c6dc786c6bff6499297da17bf19dfdd85c1a8 | 34 | 16.87 | 16.36 |  |  |  |  |  |  |  |  |  |  |  |  |  |  |  |  |  | runs/curriculum/versions/ppo_ecB/policy.zip | 73 | 0.0003
curriculum/versions/ppo_ecF | curriculum/versions | 2026-11-09 01:29 (mtime) | training.json | 1 | 158ab9b42aac386915855b4010a9354256f22653a6bdbbfb986f247fe8dfb3eb | 42 | 20.96 | 20.45 |  |  |  |  |  |  |  |  |  |  |  |  |  |  |  |  |  | runs/curriculum/versions/ppo_ecB/policy.zip | 73 | 0.0003
curriculum/versions/ppo_ecG | curriculum/versions | 2026-11-09 01:33 (mtime) | training.json | 1 | 087595c53b1756f294c4d78d8759a303c2910c68d82cb59113514a1ac79c3b2e | 42 | 20.96 | 20.45 |  |  |  |  |  |  |  |  |  |  |  |  |  |  |  |  |  | runs/curriculum/versions/ppo_ecE/policy.zip | 73 | 0.0003
curriculum/versions/ppo_ecH | curriculum/versions | 2026-11-09 01:35 (mtime) | training.json | 1 | 38f434fc91565ec8e56a8e5b0a417c21a3b2b3a647280bf026133ddf3fb8c6ce | 34 | 16.87 | 16.36 |  |  |  |  |  |  |  |  |  |  |  |  |  |  |  |  |  | runs/curriculum/versions/ppo_ecF/policy.zip | 73 | 0.0003
curriculum/versions/ppo_ecH2 | curriculum/versions | 2026-11-09 01:39 (mtime) | training.json | 1 | bc868f1ee2b2f83a6f359e957035b23b433248958129dbe156d8f3517b3944ba | 34 | 16.87 | 16.36 |  |  |  |  |  |  |  |  |  |  |  |  |  |  |  |  |  | runs/curriculum/versions/ppo_ecF/policy.zip | 73 | 0.0003
curriculum/versions/ppo_rn | curriculum/versions | 2026-11-09 00:54 (mtime) | training.json | 1 | 305ac2b64bd354eae7ac014676a62bf7f6138a7bd8c740ba85928064a7b2df36 | 26 | 12.78 | 12.27 |  |  |  |  |  |  |  |  |  |  |  |  |  |  |  |  |  | docs/results/rig_rl_disturbance/ppo_long/policy.zip | 73 | 0.0003
curriculum/versions/ppo_rn05 | curriculum/versions | 2026-11-09 01:08 (mtime) | training.json | 1 | 42cf1c0a47f82a79a83af57e91a60fa77a17a9fb8c1ace34da31c95be35c213a | 18 | 8.69 | 8.18 |  |  |  |  |  |  |  |  |  |  |  |  |  |  |  |  |  | docs/results/rig_rl_disturbance/ppo_long/policy.zip | 73 | 0.0003
curriculum/versions/rnA | curriculum/versions | 2026-11-08 23:53 (mtime) | version.json | 1 | 02b6eb568131dc1bd37a0f708c86103a3fe8b12d5719cfcb1b75b45f4290a4c5 | 3 | 0.94 | 0.0 |  |  |  |  |  |  |  |  |  |  |  |  |  |  |  |  |  |  | 0 | 0.0001 | SAC fine-tuned in V1's training simulator, reward only; optional near-upright penalty on the command change per tick, rig-like reading noise, observation-smoothness loss, discount; swing-up anchored to the parent; no rig data, no imitation | runs/curriculum/versions/v6b_runner/policy.zip | 200000
curriculum/versions/rnB | curriculum/versions | 2026-11-08 23:54 (mtime) | version.json | 1 | 1c9456772603018dfda9f3dbbc61ba5269239e336b1421ea9f94e5efe14597d3 | 3 | 0.94 | 0.0 |  |  |  |  |  |  |  |  |  |  |  |  |  |  |  |  |  |  | 0 | 0.0001 | SAC fine-tuned in V1's training simulator, reward only; optional near-upright penalty on the command change per tick, rig-like reading noise, observation-smoothness loss, discount; swing-up anchored to the parent; no rig data, no imitation | runs/curriculum/versions/v6b_runner/policy.zip | 200000
curriculum/versions/rnC | curriculum/versions | 2026-11-08 23:54 (mtime) | version.json | 1 | 0bf961b1090da4693fa859d2db234bbe36dcdb10ae11e8e692f0f03fd880e1a4 | 3 | 0.94 | 0.0 |  |  |  |  |  |  |  |  |  |  |  |  |  |  |  |  |  |  | 0 | 0.0001 | SAC fine-tuned in V1's training simulator, reward only; optional near-upright penalty on the command change per tick, rig-like reading noise, observation-smoothness loss, discount; swing-up anchored to the parent; no rig data, no imitation | runs/curriculum/versions/v6b_runner/policy.zip | 200000
curriculum/versions/s01e15 | curriculum/versions | 2026-11-08 22:49 (mtime) | version.json | 1 | 1738f3477f3fd596b5fca8ced3f5dad2efd19305fe6e79816161050a305307b7 | 3 | 2.12 | 0.0 |  |  |  |  |  |  |  |  |  |  |  |  |  |  |  |  |  |  |  |  | on-rig SAC session s01_v6b_online (scripts/rig_sac_online.py); no imitation, no other controllers' data | runs/curriculum/versions/v6b_runner/policy.zip
curriculum/versions/s01e17 | curriculum/versions | 2026-11-08 22:49 (mtime) | version.json | 1 | 340ec8100e4065573a1de83654940dd277d1e71dec20360d8545e7ebc4769888 | 3 | 2.12 | 0.0 |  |  |  |  |  |  |  |  |  |  |  |  |  |  |  |  |  |  |  |  | on-rig SAC session s01_v6b_online (scripts/rig_sac_online.py); no imitation, no other controllers' data | runs/curriculum/versions/v6b_runner/policy.zip
curriculum/versions/s01e49 | curriculum/versions | 2026-11-08 22:39 (mtime) | version.json | 1 | bdce96d817d2d7c721a7136aa81ed0fd87e79af5fcc0fef908b62f879a761ecc | 3 | 2.12 | 0.0 |  |  |  |  |  |  |  |  |  |  |  |  |  |  |  |  |  |  |  |  | on-rig SAC session s01_v6b_online (scripts/rig_sac_online.py): checkpoint after episode 49, 105,308 updates; the actor that passed eval episode 49 was published at 105,208 updates (about 12 actor steps earlier); no imitation, no other controllers' data | runs/curriculum/versions/v6b_runner/policy.zip
curriculum/versions/sm15 | curriculum/versions | 2026-11-08 23:25 (mtime) | version.json | 1 | 86180eeb9c37d726d347a706f3b7744f61739349a17e5fb2b89c61050aad82b0 | 3 | 0.94 | 0.0 |  |  |  |  |  |  |  |  |  |  |  |  |  |  |  |  |  |  | 0 | 0.0001 | SAC fine-tuned in V1's training simulator, reward only, with a near-upright penalty on the command change per tick; swing-up anchored to the parent; no rig data, no imitation | runs/curriculum/versions/v6b_runner/policy.zip | 150000
curriculum/versions/sm2 | curriculum/versions | 2026-11-08 23:25 (mtime) | version.json | 1 | a64e54db90a060467cdc105eedb1206eb41947224fa679c6cd82a23153dac205 | 3 | 0.94 | 0.0 |  |  |  |  |  |  |  |  |  |  |  |  |  |  |  |  |  |  | 0 | 0.0001 | SAC fine-tuned in V1's training simulator, reward only, with a near-upright penalty on the command change per tick; swing-up anchored to the parent; no rig data, no imitation | runs/curriculum/versions/v6b_runner/policy.zip | 150000
curriculum/versions/sm5 | curriculum/versions | 2026-11-08 23:25 (mtime) | version.json | 1 | ff705d3e209762482e8adc55ecf3b8f8a3d20d1a8ffd5969d4c01c8ca32c03ce | 3 | 0.94 | 0.0 |  |  |  |  |  |  |  |  |  |  |  |  |  |  |  |  |  |  | 0 | 0.0001 | SAC fine-tuned in V1's training simulator, reward only, with a near-upright penalty on the command change per tick; swing-up anchored to the parent; no rig data, no imitation | runs/curriculum/versions/v6b_runner/policy.zip | 150000
curriculum/versions/v1 | curriculum/versions | 2026-11-07 22:59 (mtime) | version.json | 1 | a744984676604e20b5cc3b30b68e98d11f13a8f343596191892967196c1857c8 | 3 | 3.4 | 0.0 |  |  |  |  |  |  |  |  |  |  |  |  |  |  |  |  |  |  | 1 | 3e-05 | offline SAC updates (ordinary SAC losses) on on-rig policy ticks only; no imitation, no other controllers' data | runs/sac_finetune/V1/policy.zip |  | 2
curriculum/versions/v2 | curriculum/versions | 2026-11-07 23:17 (mtime) | version.json | 1 | 0e25387a208e7cb15310051983e3339c503f30c57879e13284d0c149f53dce2a | 3 | 3.52 | 0.0 |  |  |  |  |  |  |  |  |  |  |  |  |  |  |  |  |  |  | 2 | 3e-05 | offline SAC updates (ordinary SAC losses) on on-rig policy ticks only; no imitation, no other controllers' data | runs/sac_finetune/V1/policy.zip |  | 3
curriculum/versions/v2_u1000 | curriculum/versions | 2026-11-07 23:28 (mtime) | version.json | 1 | 4dae3de45dd80c61b70a453cf785e088947f8c01637a1c716f40875b2c8a4541 | 3 | 3.52 | 0.0 |  |  |  |  |  |  |  |  |  |  |  |  |  |  |  |  |  |  | 2 | 3e-05 | offline SAC updates (ordinary SAC losses) on on-rig policy ticks only; no imitation, no other controllers' data | runs/sac_finetune/V1/policy.zip |  | 3
curriculum/versions/v2_u250 | curriculum/versions | 2026-11-07 23:29 (mtime) | version.json | 1 | 6ac8294b0e63aed481475c5293a9f25bb2015d1f659f3f085914fb50495600d3 | 3 | 3.52 | 0.0 |  |  |  |  |  |  |  |  |  |  |  |  |  |  |  |  |  |  | 2 | 3e-05 | offline SAC updates (ordinary SAC losses) on on-rig policy ticks only; no imitation, no other controllers' data | runs/sac_finetune/V1/policy.zip |  | 3
curriculum/versions/v2_u2500 | curriculum/versions | 2026-11-07 23:28 (mtime) | version.json | 1 | 9e3a5558774a8775ea0fc39f9e2abba48bd81ad846f72444e36a58d18e335ee8 | 3 | 3.52 | 0.0 |  |  |  |  |  |  |  |  |  |  |  |  |  |  |  |  |  |  | 2 | 3e-05 | offline SAC updates (ordinary SAC losses) on on-rig policy ticks only; no imitation, no other controllers' data | runs/sac_finetune/V1/policy.zip |  | 3
curriculum/versions/v2_u5000 | curriculum/versions | 2026-11-07 23:28 (mtime) | version.json | 1 | 737570097ce3ad18e2088f8812271aa4245cd6a4e69f880103dc390d4a56b8ee | 3 | 3.52 | 0.0 |  |  |  |  |  |  |  |  |  |  |  |  |  |  |  |  |  |  | 2 | 3e-05 | offline SAC updates (ordinary SAC losses) on on-rig policy ticks only; no imitation, no other controllers' data | runs/sac_finetune/V1/policy.zip |  | 3
curriculum/versions/v2m1 | curriculum/versions | 2026-11-07 23:19 (mtime) | version.json | 1 | b72ee63313c80b57c02f5b3ebdb59a005a5b9ad912bb299099907f4f5a310ea1 | 3 | 0.93 | 0.0 |  |  |  |  |  |  |  |  |  |  |  |  |  |  |  |  |  |  | 3 | 0.0001 | SAC on simulator experience (V1's training simulator) with each batch 50% on-rig policy ticks; no imitation, no other controllers' data | runs/sac_finetune/V1/policy.zip |  | 3
curriculum/versions/v2m2 | curriculum/versions | 2026-11-07 23:20 (mtime) | version.json | 1 | bc40824aed2462dc60c2e58d04b281b951f110d04c13fb720210ac4026b82737 | 3 | 0.93 | 0.0 |  |  |  |  |  |  |  |  |  |  |  |  |  |  |  |  |  |  | 3 | 0.0001 | SAC on simulator experience (V1's training simulator) with each batch 50% on-rig policy ticks; no imitation, no other controllers' data | runs/sac_finetune/V1/policy.zip |  | 3
curriculum/versions/v2m2_runner | curriculum/versions | 2026-11-08 03:10 (mtime) | version.json | 1 | 712a07046b4387d85aaf060d137a9ef250fb6fa998406664261cbe8a35238377 | 2 | 0.93 | 0.0 |  |  |  |  |  |  |  |  |  |  |  |  |  |  |  |  |  |  |  |  |  | v2m2
curriculum/versions/v3 | curriculum/versions | 2026-11-08 03:32 (mtime) | version.json | 1 | f04d0be1ab5abf87bf6901184bf77a2cefc373c547acde843d9c9d2cec5df29f | 3 | 0.93 | 0.0 |  |  |  |  |  |  |  |  |  |  |  |  |  |  |  |  |  |  | 3 | 0.0001 | SAC on simulator experience (V1's training simulator) with each batch 50% on-rig policy ticks; no imitation, no other controllers' data | runs/curriculum/versions/v2m2/policy.zip |  | 6
curriculum/versions/v3_runner | curriculum/versions | 2026-11-08 03:33 (mtime) | version.json | 1 | a9c20948385969bea318052dc5c70eb880edfb655e7bc6892e97687e06781e2b | 2 | 0.93 | 0.0 |  |  |  |  |  |  |  |  |  |  |  |  |  |  |  |  |  |  |  |  |  | v3
curriculum/versions/v3b | curriculum/versions | 2026-11-08 03:37 (mtime) | version.json | 1 | e60e73269cf09154a5334f2dcfae7d649078c8ad07dc9fdaca25a68eb75ce50c | 3 | 0.93 | 0.0 |  |  |  |  |  |  |  |  |  |  |  |  |  |  |  |  |  |  | 3 | 0.0001 | SAC on simulator experience (V1's training simulator) with each batch 50% on-rig policy ticks; no imitation, no other controllers' data | runs/curriculum/versions/v2m2/policy.zip |  | 7
curriculum/versions/v3b_runner | curriculum/versions | 2026-11-08 03:37 (mtime) | version.json | 1 | e27659d67b4cfb1f97a402f3ec1c25e52b400b5ccb86580d1b32d45db63241f4 | 2 | 0.93 | 0.0 |  |  |  |  |  |  |  |  |  |  |  |  |  |  |  |  |  |  |  |  |  | v3b
curriculum/versions/v3c | curriculum/versions | 2026-11-08 03:38 (mtime) | version.json | 1 | 991ed716f8f35ea616c68115195bb5110df26d5036c58b6dd4197944da019d29 | 3 | 0.93 | 0.0 |  |  |  |  |  |  |  |  |  |  |  |  |  |  |  |  |  |  | 3 | 3e-05 | SAC on simulator experience (V1's training simulator) with each batch 50% on-rig policy ticks; no imitation, no other controllers' data | runs/curriculum/versions/v2m2/policy.zip |  | 7
curriculum/versions/v3c_runner | curriculum/versions | 2026-11-08 03:54 (mtime) | version.json | 1 | 676b8e9c8f8629d5a442da93ef564efdca051c5b070aa36c1b4053ce148e07a2 | 2 | 0.93 | 0.0 |  |  |  |  |  |  |  |  |  |  |  |  |  |  |  |  |  |  |  |  |  | v3c
curriculum/versions/v4 | curriculum/versions | 2026-11-08 03:47 (mtime) | version.json | 1 | 2987d6a85436c5c00a97f131093acb49ab792f63e6215cf58d574513847ced9f | 3 | 0.94 | 0.0 |  |  |  |  |  |  |  |  |  |  |  |  |  |  |  |  |  |  | 3 | 0.0001 | SAC on simulator experience (V1's training simulator) with each batch 50% on-rig policy ticks; no imitation, no other controllers' data | runs/curriculum/versions/v3b/policy.zip |  | 11
curriculum/versions/v4b | curriculum/versions | 2026-11-08 03:52 (mtime) | version.json | 1 | 4377546a4d57bfa528f620ebd4377ed05a4aac49c66f6d88e0d3e4b01de7c531 | 3 | 0.93 | 0.0 |  |  |  |  |  |  |  |  |  |  |  |  |  |  |  |  |  |  | 3 | 3e-05 | SAC on simulator experience (V1's training simulator) with each batch 50% on-rig policy ticks; no imitation, no other controllers' data | runs/curriculum/versions/v3b/policy.zip |  | 12
curriculum/versions/v5 | curriculum/versions | 2026-11-08 04:03 (mtime) | version.json | 1 | 159778e4c547ec4a865cf122f2f3b30da2826f0daec592b77d846701250fa259 | 3 | 0.93 | 0.0 |  |  |  |  |  |  |  |  |  |  |  |  |  |  |  |  |  |  | 3 | 0.0001 | SAC on simulator experience (V1's training simulator) with each batch 50% on-rig policy ticks; no imitation, no other controllers' data | runs/curriculum/versions/v3b/policy.zip |  | 13
curriculum/versions/v5_runner | curriculum/versions | 2026-11-08 04:03 (mtime) | version.json | 1 | ed8cc1ffecc7ea2137d34f59deb6424f62b8852e1eaeba737a94124d2453bce0 | 2 | 0.93 | 0.0 |  |  |  |  |  |  |  |  |  |  |  |  |  |  |  |  |  |  |  |  |  | v5
curriculum/versions/v6 | curriculum/versions | 2026-11-08 04:14 (mtime) | version.json | 1 | bf9f3348f1578ca1b84e064597632248fd6b6fa573ce2b3b7ea67b671ef1f237 | 3 | 71.44 | 0.0 |  |  |  |  |  |  |  |  |  |  |  |  |  |  |  |  |  |  | 3 | 0.0001 | SAC on simulator experience (V1's training simulator) with each batch 50% on-rig policy ticks; no imitation, no other controllers' data | runs/curriculum/versions/v3b/policy.zip |  | 16
curriculum/versions/v6b | curriculum/versions | 2026-11-08 04:15 (mtime) | version.json | 1 | 0888e24dc345034d0267a15534f07d6d99aeb238e0577bbdbc729a763870361d | 3 | 71.9 | 0.0 |  |  |  |  |  |  |  |  |  |  |  |  |  |  |  |  |  |  | 3 | 0.0001 | SAC on simulator experience (V1's training simulator) with each batch 50% on-rig policy ticks; no imitation, no other controllers' data | runs/curriculum/versions/v3b/policy.zip |  | 16
curriculum/versions/v6b_runner | curriculum/versions | 2026-11-08 04:20 (mtime) | version.json | 1 | 7b652fd44c70cbb753b1acc1e680761bd0fb7511e8ba2476e6490becfdbc80a4 | 2 | 0.93 | 0.0 |  |  |  |  |  |  |  |  |  |  |  |  |  |  |  |  |  |  |  |  |  | v6b
curriculum/versions/v7 | curriculum/versions | 2026-11-08 04:24 (mtime) | version.json | 1 | b4ab0f4355cb4cfbcc63e365ad3f28069d0c72b4ccd39c21d528be129f8f74c0 | 3 | 0.94 | 0.0 |  |  |  |  |  |  |  |  |  |  |  |  |  |  |  |  |  |  | 3 | 0.0001 | SAC on simulator experience (V1's training simulator) with each batch 50% on-rig policy ticks; no imitation, no other controllers' data | runs/curriculum/versions/v3b/policy.zip |  | 18
curriculum/versions/v7b | curriculum/versions | 2026-11-08 04:26 (mtime) | version.json | 1 | b0f9e64b69e002bbcd95fa9bca48b4881fd12d0187b53eaf95b06b60c5d9fca3 | 3 | 0.94 | 0.0 |  |  |  |  |  |  |  |  |  |  |  |  |  |  |  |  |  |  | 3 | 0.0001 | SAC on simulator experience (V1's training simulator) with each batch 50% on-rig policy ticks; no imitation, no other controllers' data | runs/curriculum/versions/v3b/policy.zip |  | 18
curriculum/versions/v8 | curriculum/versions | 2026-11-08 17:06 (mtime) | version.json | 1 | a3d084d20ac45320457db0766769b032f2ffe64508f82b81d1eb299854781b55 | 3 | 0.94 | 0.0 |  |  |  |  |  |  |  |  |  |  |  |  |  |  |  |  |  |  | 3 | 0.0001 | SAC on simulator experience (V1's training simulator) with each batch 50% on-rig policy ticks; no imitation, no other controllers' data | runs/curriculum/versions/v3b/policy.zip |  | 20
curriculum/versions/v9 | curriculum/versions | 2026-11-08 20:53 (mtime) | version.json | 1 | 4d99d91857bacfc397b339be82920a88738bcd6513a4deb82a0462f481bdbf29 | 3 | 0.94 | 0.0 |  |  |  |  |  |  |  |  |  |  |  |  |  |  |  |  |  |  | 3 | 0.0001 | SAC on simulator experience (V1's training simulator) with each batch 50% on-rig policy ticks; no imitation, no other controllers' data | runs/curriculum/versions/v7/policy.zip |  | 22
curriculum_sim/b0_balance_det | curriculum_sim | 2026-11-07 22:26 (mtime) | batch.json summary.json | 0 |  | 10 | 0.19 | 0.0 | runs/sac_finetune/V1/policy.zip | balance | True | 4 | 4 | completed | 2026-11-07T22:26:28 | 4 | 0 | 0.363 | 1.06 | duration
curriculum_sim/fall_check | curriculum_sim | 2026-11-07 23:05 (mtime) | batch.json summary.json | 0 |  | 8 | 0.06 | 0.0 | runs/sac_finetune/V1/policy.zip | lqr_balance | False | 3 | 3 | completed | 2026-11-07T23:05:55 | 3 | 0 | 0.667 | 1.16 | fell
curriculum_sim/gate_V1_hang | curriculum_sim | 2026-11-07 22:59 (mtime) | batch.json summary.json | 0 |  | 10 | 0.47 | 0.0 | runs/sac_finetune/V1/policy.zip | hanging | True | 4 | 4 | completed | 2026-11-07T22:59:31 | 4 | 0 | 0.359 | 1.94 | duration
curriculum_sim/gate_V1_lqr | curriculum_sim | 2026-11-07 22:59 (mtime) | batch.json summary.json | 0 |  | 9 | 0.22 | 0.0 | runs/sac_finetune/V1/policy.zip | lqr_balance | True | 4 | 4 | completed | 2026-11-07T22:59:35 | 4 | 0 | 0.451 | 1.34 | duration;lift_timeout
curriculum_sim/gate_v1_hang | curriculum_sim | 2026-11-07 22:59 (mtime) | batch.json summary.json | 0 |  | 10 | 0.41 | 0.0 | runs/curriculum/versions/v1/policy.zip | hanging | True | 4 | 4 | completed | 2026-11-07T22:59:39 | 4 | 2 | 0.462 | 17.56 | duration
curriculum_sim/gate_v1_lqr | curriculum_sim | 2026-11-07 22:59 (mtime) | batch.json summary.json | 0 |  | 8 | 0.18 | 0.0 | runs/curriculum/versions/v1/policy.zip | lqr_balance | True | 4 | 4 | completed | 2026-11-07T22:59:43 | 4 | 0 | 1.0 | 8.0 | duration;lift_timeout
curriculum_sim/lift_capture | curriculum_sim | 2026-11-07 22:30 (mtime) | batch.json summary.json | 0 |  | 18 | 0.37 | 0.0 | runs/sac_finetune/V1/policy.zip | capture | True | 8 | 8 | completed | 2026-11-07T22:30:26 | 8 | 0 | 0.415 | 2.24 | duration
curriculum_sim/lift_mixed | curriculum_sim | 2026-11-07 22:30 (mtime) | batch.json summary.json | 0 |  | 18 | 0.35 | 0.0 | runs/sac_finetune/V1/policy.zip | mixed | True | 8 | 8 | completed | 2026-11-07T22:30:33 | 8 | 0 | 0.353 | 1.38 | duration
curriculum_sim/lift_recover | curriculum_sim | 2026-11-07 22:30 (mtime) | batch.json summary.json | 0 |  | 18 | 0.37 | 0.0 | runs/sac_finetune/V1/policy.zip | recover | True | 8 | 8 | completed | 2026-11-07T22:30:29 | 8 | 0 | 0.368 | 1.8 | duration
curriculum_sim/lqr_balance_det | curriculum_sim | 2026-11-07 22:41 (mtime) | batch.json summary.json | 0 |  | 13 | 0.26 | 0.0 | runs/sac_finetune/V1/policy.zip | lqr_balance | True | 6 | 6 | completed | 2026-11-07T22:41:13 | 6 | 0 | 0.477 | 1.68 | duration;lift_timeout
curriculum_sim/lqr_balance_det2 | curriculum_sim | 2026-11-07 22:43 (mtime) | batch.json summary.json | 0 |  | 8 | 0.17 | 0.0 | runs/sac_finetune/V1/policy.zip | lqr_balance | True | 3 | 3 | completed | 2026-11-07T22:43:56 | 3 | 0 | 0.423 | 0.96 | duration
curriculum_sim/lqr_capture_det | curriculum_sim | 2026-11-07 22:41 (mtime) | batch.json summary.json | 0 |  | 11 | 0.23 | 0.0 | runs/sac_finetune/V1/policy.zip | lqr_capture | True | 6 | 6 | completed | 2026-11-07T22:41:17 | 6 | 0 | 0.451 | 1.24 | duration;lift_timeout
curriculum_sim/lqr_mixed_det | curriculum_sim | 2026-11-07 22:41 (mtime) | batch.json summary.json | 0 |  | 13 | 0.25 | 0.0 | runs/sac_finetune/V1/policy.zip | lqr_mixed | True | 6 | 6 | completed | 2026-11-07T22:41:22 | 6 | 0 | 0.486 | 3.12 | duration;lift_timeout
curriculum_sim/pilot_a/eval20_v0_hang | curriculum_sim | 2026-11-07 22:29 (mtime) | batch.json summary.json | 0 |  | 10 | 0.47 | 0.0 | runs/sac_finetune/V1/policy.zip | hanging | True | 4 | 4 | completed | 2026-11-07T22:29:24 | 4 | 0 | 0.359 | 1.94 | duration
curriculum_sim/pilot_a/eval20_v2_hang | curriculum_sim | 2026-11-07 22:29 (mtime) | batch.json summary.json | 0 |  | 10 | 0.36 | 0.0 | runs/curriculum_sim/pilot_a/v2/policy.zip | hanging | True | 4 | 4 | completed | 2026-11-07T22:29:17 | 4 | 4 | 0.925 | 18.52 | duration
curriculum_sim/pilot_a/eval20_v4_hang | curriculum_sim | 2026-11-07 22:29 (mtime) | batch.json summary.json | 0 |  | 10 | 0.36 | 0.0 | runs/curriculum_sim/pilot_a/v4/policy.zip | hanging | True | 4 | 4 | completed | 2026-11-07T22:29:21 | 4 | 4 | 0.903 | 18.06 | duration
curriculum_sim/pilot_a/eval_v0 | curriculum_sim | 2026-11-07 22:26 (mtime) | batch.json summary.json | 0 |  | 18 | 0.38 | 0.0 | runs/sac_finetune/V1/policy.zip | balance | True | 8 | 8 | completed | 2026-11-07T22:26:48 | 8 | 0 | 0.394 | 1.08 | duration
curriculum_sim/pilot_a/eval_v0_hang | curriculum_sim | 2026-11-07 22:26 (mtime) | batch.json summary.json | 0 |  | 10 | 0.16 | 0.0 | runs/sac_finetune/V1/policy.zip | hanging | True | 4 | 4 | completed | 2026-11-07T22:26:51 | 4 | 0 | 0.267 | 0.88 | duration
curriculum_sim/pilot_a/eval_v1 | curriculum_sim | 2026-11-07 22:27 (mtime) | batch.json summary.json | 0 |  | 18 | 0.33 | 0.0 | runs/curriculum_sim/pilot_a/v1/policy.zip | balance | True | 8 | 8 | completed | 2026-11-07T22:27:24 | 8 | 0 | 0.922 | 4.94 | duration
curriculum_sim/pilot_a/eval_v1_hang | curriculum_sim | 2026-11-07 22:27 (mtime) | batch.json summary.json | 0 |  | 10 | 0.14 | 0.0 | runs/curriculum_sim/pilot_a/v1/policy.zip | hanging | True | 4 | 4 | completed | 2026-11-07T22:27:27 | 4 | 0 | 0.695 | 4.4 | duration
curriculum_sim/pilot_a/eval_v2 | curriculum_sim | 2026-11-07 22:27 (mtime) | batch.json summary.json | 0 |  | 18 | 0.3 | 0.0 | runs/curriculum_sim/pilot_a/v2/policy.zip | balance | True | 8 | 8 | completed | 2026-11-07T22:27:50 | 8 | 0 | 1.0 | 6.0 | duration
curriculum_sim/pilot_a/eval_v2_hang | curriculum_sim | 2026-11-07 22:27 (mtime) | batch.json summary.json | 0 |  | 10 | 0.14 | 0.0 | runs/curriculum_sim/pilot_a/v2/policy.zip | hanging | True | 4 | 4 | completed | 2026-11-07T22:27:54 | 4 | 0 | 0.752 | 4.52 | duration
curriculum_sim/pilot_a/eval_v3 | curriculum_sim | 2026-11-07 22:28 (mtime) | batch.json summary.json | 0 |  | 18 | 0.31 | 0.0 | runs/curriculum_sim/pilot_a/v3/policy.zip | balance | True | 8 | 8 | completed | 2026-11-07T22:28:16 | 8 | 0 | 0.99 | 6.0 | duration
curriculum_sim/pilot_a/eval_v3_hang | curriculum_sim | 2026-11-07 22:28 (mtime) | batch.json summary.json | 0 |  | 10 | 0.14 | 0.0 | runs/curriculum_sim/pilot_a/v3/policy.zip | hanging | True | 4 | 4 | completed | 2026-11-07T22:28:20 | 4 | 0 | 0.677 | 4.06 | duration
curriculum_sim/pilot_a/eval_v4 | curriculum_sim | 2026-11-07 22:28 (mtime) | batch.json summary.json | 0 |  | 18 | 0.3 | 0.0 | runs/curriculum_sim/pilot_a/v4/policy.zip | balance | True | 8 | 8 | completed | 2026-11-07T22:28:47 | 8 | 0 | 1.0 | 6.0 | duration
curriculum_sim/pilot_a/eval_v4_hang | curriculum_sim | 2026-11-07 22:28 (mtime) | batch.json summary.json | 0 |  | 10 | 0.14 | 0.0 | runs/curriculum_sim/pilot_a/v4/policy.zip | hanging | True | 4 | 4 | completed | 2026-11-07T22:28:50 | 4 | 0 | 0.675 | 4.06 | duration
curriculum_sim/pilot_a/train_1 | curriculum_sim | 2026-11-07 22:26 (mtime) | batch.json summary.json | 0 |  | 22 | 0.47 | 0.0 | runs/sac_finetune/V1/policy.zip | balance | False | 10 | 10 | completed | 2026-11-07T22:26:54 | 10 | 0 | 0.445 | 2.28 | duration
curriculum_sim/pilot_a/train_2 | curriculum_sim | 2026-11-07 22:27 (mtime) | batch.json summary.json | 0 |  | 22 | 0.41 | 0.0 | runs/curriculum_sim/pilot_a/v1/policy.zip | balance | False | 10 | 10 | completed | 2026-11-07T22:27:30 | 10 | 0 | 0.905 | 6.0 | duration
curriculum_sim/pilot_a/train_3 | curriculum_sim | 2026-11-07 22:27 (mtime) | batch.json summary.json | 0 |  | 22 | 0.39 | 0.0 | runs/curriculum_sim/pilot_a/v2/policy.zip | balance | False | 10 | 10 | completed | 2026-11-07T22:27:57 | 10 | 0 | 0.978 | 6.0 | duration
curriculum_sim/pilot_a/train_4 | curriculum_sim | 2026-11-07 22:28 (mtime) | batch.json summary.json | 0 |  | 22 | 0.39 | 0.0 | runs/curriculum_sim/pilot_a/v3/policy.zip | balance | False | 10 | 10 | completed | 2026-11-07T22:28:23 | 10 | 0 | 0.992 | 6.0 | duration
curriculum_sim/pilot_a/v1 | curriculum_sim | 2026-11-07 22:27 (mtime) | version.json | 1 | 45d37731b717027ddd88e57ac82e75a81d4375432b8b4bac59a1e365ff75a90d | 3 | 3.01 | 0.0 |  |  |  |  |  |  |  |  |  |  |  |  |  |  |  |  |  |  | 1 | 3e-05 | offline SAC updates (ordinary SAC losses) on on-rig policy ticks only; no imitation, no other controllers' data | runs/sac_finetune/V1/policy.zip |  | 1
curriculum_sim/pilot_a/v2 | curriculum_sim | 2026-11-07 22:27 (mtime) | version.json | 1 | b15ecc83735ceaf7c5f1e5671361930a6e50a65891041be32522683bc4cd6529 | 3 | 3.01 | 0.0 |  |  |  |  |  |  |  |  |  |  |  |  |  |  |  |  |  |  | 2 | 3e-05 | offline SAC updates (ordinary SAC losses) on on-rig policy ticks only; no imitation, no other controllers' data | runs/curriculum_sim/pilot_a/v1/policy.zip |  | 2
curriculum_sim/pilot_a/v3 | curriculum_sim | 2026-11-07 22:28 (mtime) | version.json | 1 | 45b1b209a423e8abd00ab0efdc8672ed93d403e9bbd9a954e868ac61eba702dd | 3 | 3.01 | 0.0 |  |  |  |  |  |  |  |  |  |  |  |  |  |  |  |  |  |  | 3 | 3e-05 | offline SAC updates (ordinary SAC losses) on on-rig policy ticks only; no imitation, no other controllers' data | runs/curriculum_sim/pilot_a/v2/policy.zip |  | 3
curriculum_sim/pilot_a/v4 | curriculum_sim | 2026-11-07 22:28 (mtime) | version.json | 1 | d62d6706ef8de3afcf0e0134edcea60458e39358471b766bae9c9e6332873097 | 3 | 3.01 | 0.0 |  |  |  |  |  |  |  |  |  |  |  |  |  |  |  |  |  |  | 4 | 3e-05 | offline SAC updates (ordinary SAC losses) on on-rig policy ticks only; no imitation, no other controllers' data | runs/curriculum_sim/pilot_a/v3/policy.zip |  | 4
curriculum_sim/pilot_b/eval_v0 | curriculum_sim | 2026-11-07 22:38 (mtime) | batch.json summary.json | 0 |  | 18 | 0.37 | 0.0 | runs/sac_finetune/V1/policy.zip | balance | True | 8 | 8 | completed | 2026-11-07T22:38:54 | 8 | 0 | 0.456 | 1.28 | duration
curriculum_sim/pilot_b/eval_v0_hang | curriculum_sim | 2026-11-07 22:39 (mtime) | batch.json summary.json | 0 |  | 10 | 0.16 | 0.0 | runs/sac_finetune/V1/policy.zip | hanging | True | 4 | 4 | completed | 2026-11-07T22:38:58 | 4 | 0 | 0.267 | 0.88 | duration
curriculum_sim/pilot_b/eval_v1 | curriculum_sim | 2026-11-07 22:39 (mtime) | batch.json summary.json | 0 |  | 18 | 0.3 | 0.0 | runs/curriculum_sim/pilot_b/v1/policy.zip | balance | True | 8 | 8 | completed | 2026-11-07T22:39:25 | 8 | 0 | 0.991 | 6.0 | duration
curriculum_sim/pilot_b/eval_v1_hang | curriculum_sim | 2026-11-07 22:39 (mtime) | batch.json summary.json | 0 |  | 10 | 0.15 | 0.0 | runs/curriculum_sim/pilot_b/v1/policy.zip | hanging | True | 4 | 4 | completed | 2026-11-07T22:39:29 | 4 | 0 | 0.589 | 4.5 | duration
curriculum_sim/pilot_b/eval_v2 | curriculum_sim | 2026-11-07 22:39 (mtime) | batch.json summary.json | 0 |  | 18 | 0.29 | 0.0 | runs/curriculum_sim/pilot_b/v2/policy.zip | balance | True | 8 | 8 | completed | 2026-11-07T22:39:38 | 8 | 0 | 0.991 | 6.0 | duration
curriculum_sim/pilot_b/eval_v2_hang | curriculum_sim | 2026-11-07 22:39 (mtime) | batch.json summary.json | 0 |  | 10 | 0.14 | 0.0 | runs/curriculum_sim/pilot_b/v2/policy.zip | hanging | True | 4 | 4 | completed | 2026-11-07T22:39:41 | 4 | 0 | 0.627 | 4.52 | duration
curriculum_sim/pilot_b/train_1 | curriculum_sim | 2026-11-07 22:39 (mtime) | batch.json summary.json | 0 |  | 22 | 0.46 | 0.0 | runs/sac_finetune/V1/policy.zip | balance | False | 10 | 10 | completed | 2026-11-07T22:39:01 | 10 | 0 | 0.4 | 2.06 | duration
curriculum_sim/pilot_b/train_2 | curriculum_sim | 2026-11-07 22:39 (mtime) | batch.json summary.json | 0 |  | 4 | 0.04 | 0.0 | runs/curriculum_sim/pilot_b/v1/policy.zip | balance | False | 10 | 1 | SessionStop: Arm did not settle on zero after the position move | 2026-11-07T22:39:32 | 1 | 0 | 0.927 | 5.42 | duration
curriculum_sim/pilot_b/v1 | curriculum_sim | 2026-11-07 22:39 (mtime) | version.json | 1 | ce85157bcc8b164799cb9a9ab096651d020528d56b9f6d47fecea59dad5685da | 3 | 3.01 | 0.0 |  |  |  |  |  |  |  |  |  |  |  |  |  |  |  |  |  |  | 1 | 3e-05 | offline SAC updates (ordinary SAC losses) on on-rig policy ticks only; no imitation, no other controllers' data | runs/sac_finetune/V1/policy.zip |  | 1
curriculum_sim/pilot_b/v2 | curriculum_sim | 2026-11-07 22:39 (mtime) | version.json | 1 | 556ca0cc665833d0076e7870598419a6b839bdcc5c3eb59fef9ddb87658ed1d0 | 3 | 3.01 | 0.0 |  |  |  |  |  |  |  |  |  |  |  |  |  |  |  |  |  |  | 2 | 3e-05 | offline SAC updates (ordinary SAC losses) on on-rig policy ticks only; no imitation, no other controllers' data | runs/curriculum_sim/pilot_b/v1/policy.zip |  | 2
custom_lqrdither_20261107_204044 | custom_lqrdither | 2026-11-07 20:40 | run.json summary.json | 0 |  | 3 | 0.06 | 0.0 | docs/results/sac_focused_policy.zip |  |  |  |  |  |  | 1 | 1 | 0.692 | 10.28 | duration | hardware | custom | configs/my_rig.json | configs/custom_lqr_dither_10.json | 15.0
custom_lqrdither_20261107_204120 | custom_lqrdither | 2026-11-07 20:41 | run.json summary.json | 0 |  | 3 | 0.06 | 0.0 | docs/results/sac_focused_policy.zip |  |  |  |  |  |  | 1 | 0 | 0.299 | 1.58 | duration | hardware | custom | configs/my_rig.json | configs/custom_lqr_dither_10.json | 15.0
custom_lqrdither_20261107_204153 | custom_lqrdither | 2026-11-07 20:41 | run.json summary.json | 0 |  | 3 | 0.06 | 0.0 | docs/results/sac_focused_policy.zip |  |  |  |  |  |  | 1 | 0 | 0.719 | 9.5 | duration | hardware | custom | configs/my_rig.json | configs/custom_lqr_dither_10.json | 15.0
custom_lqrdither_20261107_204221 | custom_lqrdither | 2026-11-07 20:42 | run.json summary.json | 0 |  | 3 | 0.06 | 0.0 | docs/results/sac_focused_policy.zip |  |  |  |  |  |  | 1 | 0 | 0.289 | 1.56 | duration | hardware | custom | configs/my_rig.json | configs/custom_lqr_dither_10.json | 15.0
custom_lqrdither_20261107_204251 | custom_lqrdither | 2026-11-07 20:42 | run.json summary.json | 0 |  | 3 | 0.06 | 0.0 | docs/results/sac_focused_policy.zip |  |  |  |  |  |  | 1 | 0 | 0.185 | 1.36 | duration | hardware | custom | configs/my_rig.json | configs/custom_lqr_dither_10.json | 15.0
custom_lqrdither_20261107_204321 | custom_lqrdither | 2026-11-07 20:43 | run.json summary.json | 0 |  | 3 | 0.06 | 0.0 | docs/results/sac_focused_policy.zip |  |  |  |  |  |  | 1 | 0 | 0.595 | 6.98 | duration | hardware | custom | configs/my_rig.json | configs/custom_lqr_dither_10.json | 15.0
custom_robustness_01 | custom_robustness | 2026-11-07 00:42 (mtime) | summary.json | 0 |  | 2 | 0.01 | 0.0 |  |  |  |  |  |  |  | 1 | 0
custom_robustness_02 | custom_robustness | 2026-11-07 00:43 (mtime) | summary.json | 0 |  | 2 | 0.01 | 0.0 |  |  |  |  |  |  |  | 1 | 0
custom_sacraw_20261107_203208 | custom_sacraw | 2026-11-07 20:32 | run.json summary.json | 0 |  | 3 | 0.06 | 0.0 | docs/results/sac_focused_policy.zip |  |  |  |  |  |  | 1 | 0 | 0.156 | 1.04 | duration | hardware | custom | configs/my_rig.json | configs/custom_sacbal_sac_raw.json | 15.0
custom_sacraw_20261107_203236 | custom_sacraw | 2026-11-07 20:32 | run.json summary.json | 0 |  | 3 | 0.06 | 0.0 | docs/results/sac_focused_policy.zip |  |  |  |  |  |  | 1 | 0 | 0.113 | 0.52 | duration | hardware | custom | configs/my_rig.json | configs/custom_sacbal_sac_raw.json | 15.0
custom_sacraw_20261107_203305 | custom_sacraw | 2026-11-07 20:33 | run.json summary.json | 0 |  | 3 | 0.06 | 0.0 | docs/results/sac_focused_policy.zip |  |  |  |  |  |  | 1 | 0 | 0.152 | 0.56 | duration | hardware | custom | configs/my_rig.json | configs/custom_sacbal_sac_raw.json | 15.0
custom_sim_01 | custom_sim | 2026-11-07 00:40 (mtime) | run.json summary.json | 0 |  | 3 | 0.03 | 0.0 | docs/results/sac_focused_policy.zip |  |  |  |  |  |  | 1 | 0 | 0.007 | 0.04 | duration | sim | custom | configs/my_rig.json | configs/custom_my_rig.json | 15.0
custom_sim_02 | custom_sim | 2026-11-07 00:43 (mtime) | run.json summary.json | 0 |  | 3 | 0.03 | 0.0 | docs/results/sac_focused_policy.zip |  |  |  |  |  |  | 1 | 1 | 0.86 | 12.9 | duration | sim | custom | configs/my_rig.json | configs/custom_my_rig.json | 15.0
custom_v1matched_20261107_203024 | custom_v1matched | 2026-11-07 20:30 | run.json summary.json | 0 |  | 3 | 0.06 | 0.0 | docs/results/sac_focused_policy.zip |  |  |  |  |  |  | 1 | 0 | 0.124 | 0.72 | duration | hardware | custom | configs/my_rig.json | configs/custom_sacbal_v1_matched.json | 15.0
custom_v1matched_20261107_203100 | custom_v1matched | 2026-11-07 20:31 | run.json summary.json | 0 |  | 3 | 0.06 | 0.0 | docs/results/sac_focused_policy.zip |  |  |  |  |  |  | 1 | 0 | 0.091 | 0.38 | duration | hardware | custom | configs/my_rig.json | configs/custom_sacbal_v1_matched.json | 15.0
custom_v1matched_20261107_203132 | custom_v1matched | 2026-11-07 20:31 | run.json summary.json | 0 |  | 3 | 0.06 | 0.0 | docs/results/sac_focused_policy.zip |  |  |  |  |  |  | 1 | 0 | 0.092 | 0.56 | duration | hardware | custom | configs/my_rig.json | configs/custom_sacbal_v1_matched.json | 15.0
custom_v1raw_20261107_202826 | custom_v1raw | 2026-11-07 20:28 | run.json summary.json | 0 |  | 3 | 0.06 | 0.0 | docs/results/sac_focused_policy.zip |  |  |  |  |  |  | 1 | 0 | 0.172 | 1.1 | duration | hardware | custom | configs/my_rig.json | configs/custom_sacbal_v1_raw.json | 15.0
custom_v1raw_20261107_202856 | custom_v1raw | 2026-11-07 20:28 | run.json summary.json | 0 |  | 3 | 0.06 | 0.0 | docs/results/sac_focused_policy.zip |  |  |  |  |  |  | 1 | 0 | 0.096 | 0.44 | duration | hardware | custom | configs/my_rig.json | configs/custom_sacbal_v1_raw.json | 15.0
custom_v1raw_20261107_202927 | custom_v1raw | 2026-11-07 20:29 | run.json summary.json | 0 |  | 3 | 0.06 | 0.0 | docs/results/sac_focused_policy.zip |  |  |  |  |  |  | 1 | 0 | 0.192 | 1.02 | duration | hardware | custom | configs/my_rig.json | configs/custom_sacbal_v1_raw.json | 15.0
dqn_20261108_212009 | dqn | 2026-11-08 21:20 | run.json summary.json | 0 |  | 3 | 0.05 | 0.0 | docs/results/rig_rl_disturbance/dqn_long/policy.zip |  |  |  |  |  |  | 1 | 0 | 0.0 | 0.0 | duration | hardware | dqn | configs/my_rig.json | configs/sac_my_rig.json | 15.0
dqn_rig_20261107_175326 | dqn_rig | 2026-11-07 17:53 | run.json summary.json | 0 |  | 3 | 0.05 | 0.0 | docs/results/rig_rl_disturbance/dqn_long/policy.zip |  |  |  |  |  |  | 1 | 0 | 0.004 | 0.06 | duration | hardware | dqn | configs/my_rig.json | configs/sac_my_rig.json | 15.0
dqn_rn05_20261109_010258 | dqn_rn05 | 2026-11-09 01:02 | run.json summary.json | 0 |  | 3 | 0.04 | 0.0 | runs/curriculum/versions/dqn_rn05/policy.zip |  |  |  |  |  |  | 1 | 1 | 0.871 | 13.06 | duration | hardware | dqn | configs/my_rig.json | configs/sac_my_rig.json | 15.0
dqn_rn05_20261109_010341 | dqn_rn05 | 2026-11-09 01:03 | run.json summary.json | 0 |  | 3 | 0.04 | 0.0 | runs/curriculum/versions/dqn_rn05/policy.zip |  |  |  |  |  |  | 1 | 1 | 0.904 | 13.56 | duration | hardware | dqn | configs/my_rig.json | configs/sac_my_rig.json | 15.0
dqn_rn05_20261109_141209 | dqn_rn05 | 2026-11-09 14:12 | run.json summary.json | 0 |  | 3 | 0.05 | 0.0 | docs/results/rig_rl_disturbance/dqn_rn05/policy.zip |  |  |  |  |  |  | 1 | 0 | 0.751 | 5.18 | duration | hardware | dqn | configs/my_rig.json | configs/sac_my_rig.json | 15.0
envelope_01 | envelope | 2026-11-06 21:22 (mtime) | summary.json | 0 |  | 2 | 0.02 | 0.0 |  |  |  |  |  |  |  | 1 | 0
envelope_02 | envelope | 2026-11-07 01:28 (mtime) | summary.json | 0 |  | 2 | 0.02 | 0.0 |  |  |  |  |  |  |  | 1 | 0
envelope_lqr_01 | envelope_lqr | 2026-11-06 21:28 (mtime) | summary.json | 0 |  | 5 | 0.07 | 0.0 |  |  |  |  |  |  |  | 1 | 0
gpu_rl_20261016/dqn_train | gpu_rl | 2026-10-16 |  | 1 | b764b165f98b6e9df58721f16787b2864ef9e483ea5445901c4cd2517b38f433 | 2 | 0.35 | 0.0
gpu_rl_20261016/ppo_hybrid_train | gpu_rl | 2026-10-16 |  | 1 | 9a0859920f9648409f54d2095634c5581d554ecb2c681e55ebe5ef3eb9ac1ffb | 1 | 0.51 | 0.0
gpu_rl_20261016/sac_train | gpu_rl | 2026-10-16 |  | 1 | d41d2e01cf0138b1870820116ce56385fe6ac75f74f29583b945289bd80b32f1 | 1 | 0.93 | 0.0
ilqr_20261109_001333 | ilqr | 2026-11-09 00:13 | run.json summary.json | 0 |  | 3 | 0.06 | 0.0 | docs/results/sac_focused_policy.zip |  |  |  |  |  |  | 1 | 0 | 0.069 | 0.18 | duration | hardware | ilqr | configs/my_rig.json | configs/ilqr_my_rig_lqr_match.json | 15.0
ilqr_20261109_001358 | ilqr | 2026-11-09 00:13 | run.json summary.json | 0 |  | 3 | 0.06 | 0.0 | docs/results/sac_focused_policy.zip |  |  |  |  |  |  | 1 | 0 | 0.076 | 0.52 | duration | hardware | ilqr | configs/my_rig.json | configs/ilqr_my_rig_lqr_match.json | 15.0
ilqr_lqr_match_20261107_160807 | ilqr_lqr_match | 2026-11-07 16:08 | run.json summary.json | 0 |  | 3 | 0.06 | 0.0 | docs/results/sac_focused_policy.zip |  |  |  |  |  |  | 1 | 0 | 0.192 | 1.34 | duration | hardware | ilqr | configs/my_rig.json | configs/ilqr_my_rig_lqr_match.json | 15.0
ilqr_lqr_match_20261107_160844 | ilqr_lqr_match | 2026-11-07 16:08 | run.json summary.json | 0 |  | 3 | 0.06 | 0.0 | docs/results/sac_focused_policy.zip |  |  |  |  |  |  | 1 | 0 | 0.503 | 6.54 | duration | hardware | ilqr | configs/my_rig.json | configs/ilqr_my_rig_lqr_match.json | 15.0
ilqr_lqr_match_20261107_160921 | ilqr_lqr_match | 2026-11-07 16:09 | run.json summary.json | 0 |  | 3 | 0.06 | 0.0 | docs/results/sac_focused_policy.zip |  |  |  |  |  |  | 1 | 0 | 0.215 | 0.94 | duration | hardware | ilqr | configs/my_rig.json | configs/ilqr_my_rig_lqr_match.json | 15.0
ilqr_lqr_match_20261107_160955 | ilqr_lqr_match | 2026-11-07 16:09 | run.json summary.json | 0 |  | 3 | 0.06 | 0.0 | docs/results/sac_focused_policy.zip |  |  |  |  |  |  | 1 | 0 | 0.54 | 6.46 | duration | hardware | ilqr | configs/my_rig.json | configs/ilqr_my_rig_lqr_match.json | 15.0
ilqr_lqr_match_20261107_161026 | ilqr_lqr_match | 2026-11-07 16:10 | run.json summary.json | 0 |  | 3 | 0.06 | 0.0 | docs/results/sac_focused_policy.zip |  |  |  |  |  |  | 1 | 1 | 0.884 | 13.26 | duration | hardware | ilqr | configs/my_rig.json | configs/ilqr_my_rig_lqr_match.json | 15.0
ilqr_transfer_20261107_151300 | ilqr_transfer | 2026-11-07 15:13 | run.json summary.json | 0 |  | 3 | 0.06 | 0.0 | docs/results/sac_focused_policy.zip |  |  |  |  |  |  | 1 | 0 | 0.343 | 4.3 | duration | hardware | ilqr | configs/my_rig.json | configs/ilqr_my_rig_transfer.json | 15.0
ilqr_transfer_20261107_151344 | ilqr_transfer | 2026-11-07 15:13 | run.json summary.json | 0 |  | 3 | 0.06 | 0.0 | docs/results/sac_focused_policy.zip |  |  |  |  |  |  | 1 | 0 | 0.164 | 1.18 | RuntimeError: Non-finite feedback (firmware fault bits=2, encoder) | hardware | ilqr | configs/my_rig.json | configs/ilqr_my_rig_transfer.json | 15.0
ilqr_transfer_20261107_151433 | ilqr_transfer | 2026-11-07 15:14 | run.json summary.json | 0 |  | 3 | 0.06 | 0.0 | docs/results/sac_focused_policy.zip |  |  |  |  |  |  | 1 | 0 | 0.179 | 1.32 | duration | hardware | ilqr | configs/my_rig.json | configs/ilqr_my_rig_transfer.json | 15.0
ilqr_transfer_20261107_151547 | ilqr_transfer | 2026-11-07 15:15 | run.json summary.json | 0 |  | 3 | 0.06 | 0.0 | docs/results/sac_focused_policy.zip |  |  |  |  |  |  | 1 | 0 | 0.197 | 1.28 | duration | hardware | ilqr | configs/my_rig.json | configs/ilqr_my_rig_transfer.json | 15.0
ilqr_transfer_20261107_152428 | ilqr_transfer | 2026-11-07 15:24 | run.json summary.json | 0 |  | 3 | 0.06 | 0.0 | docs/results/sac_focused_policy.zip |  |  |  |  |  |  | 1 | 0 | 0.141 | 0.82 | duration | hardware | ilqr | configs/my_rig.json | configs/ilqr_my_rig_transfer.json | 15.0
lqr_braking_01 | lqr_braking | 2026-11-07 01:02 (mtime) | summary.json | 0 |  | 4 | 0.01 | 0.0 |  |  |  |  |  |  |  | 1 | 0
lqr_calibrated_20261107_024351 | lqr_calibrated | 2026-11-07 02:43 | run.json summary.json | 0 |  | 3 | 0.06 | 0.0 | docs/results/sac_focused_policy.zip |  |  |  |  |  |  | 1 | 0 | 0.439 | 6.26 | duration | hardware | lqr | configs/my_rig.json | configs/lqr_my_rig_calibrated.json | 15.0
lqr_calibrated_20261107_024427 | lqr_calibrated | 2026-11-07 02:44 | run.json summary.json | 0 |  | 3 | 0.06 | 0.0 | docs/results/sac_focused_policy.zip |  |  |  |  |  |  | 1 | 0 | 0.584 | 2.62 | duration | hardware | lqr | configs/my_rig.json | configs/lqr_my_rig_calibrated.json | 15.0
lqr_calibrated_20261107_024501 | lqr_calibrated | 2026-11-07 02:45 | run.json summary.json | 0 |  | 3 | 0.06 | 0.0 | docs/results/sac_focused_policy.zip |  |  |  |  |  |  | 1 | 0 | 0.397 | 2.92 | duration | hardware | lqr | configs/my_rig.json | configs/lqr_my_rig_calibrated.json | 15.0
lqr_calibrated_20261107_024740 | lqr_calibrated | 2026-11-07 02:47 | run.json summary.json | 0 |  | 3 | 0.06 | 0.0 | docs/results/sac_focused_policy.zip |  |  |  |  |  |  | 1 | 0 | 0.231 | 1.52 | duration | hardware | lqr | configs/my_rig.json | configs/lqr_my_rig_calibrated.json | 15.0
lqr_calibrated_20261107_025053 | lqr_calibrated | 2026-11-07 02:50 | run.json summary.json | 0 |  | 3 | 0.06 | 0.0 | docs/results/sac_focused_policy.zip |  |  |  |  |  |  | 1 | 0 | 0.244 | 1.5 | duration | hardware | lqr | configs/my_rig.json | configs/lqr_my_rig_calibrated.json | 15.0
lqr_calibration_01 | lqr_calibration | 2026-11-06 23:52 (mtime) | summary.json | 0 |  | 1 | 0.01 | 0.0 |  |  |  |  |  |  |  | 1 | 0
lqr_coupling_delay_20261107_022139 | lqr_coupling_delay | 2026-11-07 02:21 | run.json summary.json | 0 |  | 3 | 0.06 | 0.0 | docs/results/sac_focused_policy.zip |  |  |  |  |  |  | 1 | 0 | 0.077 | 0.54 | duration | hardware | lqr | configs/my_rig.json | configs/lqr_my_rig_coupling_delay.json | 15.0
lqr_coupling_delay_20261107_022206 | lqr_coupling_delay | 2026-11-07 02:22 | run.json summary.json | 0 |  | 3 | 0.04 | 0.0 | docs/results/sac_focused_policy.zip |  |  |  |  |  |  | 1 | 0 | 0.155 | 1.1 | RuntimeError: Non-finite feedback (firmware fault bits=2, encoder) | hardware | lqr | configs/my_rig.json | configs/lqr_my_rig_coupling_delay.json | 15.0
lqr_coupling_delay_20261107_022230 | lqr_coupling_delay | 2026-11-07 02:22 | run.json summary.json | 0 |  | 3 | 0.06 | 0.0 | docs/results/sac_focused_policy.zip |  |  |  |  |  |  | 1 | 0 | 0.781 | 6.94 | duration | hardware | lqr | configs/my_rig.json | configs/lqr_my_rig_coupling_delay.json | 15.0
lqr_coupling_delay_20261107_022340 | lqr_coupling_delay | 2026-11-07 02:23 | run.json summary.json | 0 |  | 3 | 0.06 | 0.0 | docs/results/sac_focused_policy.zip |  |  |  |  |  |  | 1 | 0 | 0.187 | 1.12 | duration | hardware | lqr | configs/my_rig.json | configs/lqr_my_rig_coupling_delay.json | 15.0
lqr_coupling_delay_20261107_022408 | lqr_coupling_delay | 2026-11-07 02:24 | run.json summary.json | 0 |  | 3 | 0.06 | 0.0 | docs/results/sac_focused_policy.zip |  |  |  |  |  |  | 1 | 0 | 0.627 | 4.78 | duration | hardware | lqr | configs/my_rig.json | configs/lqr_my_rig_coupling_delay.json | 15.0
lqr_coupling_delay_20261107_022520 | lqr_coupling_delay | 2026-11-07 02:25 | run.json summary.json | 0 |  | 3 | 0.06 | 0.0 | docs/results/sac_focused_policy.zip |  |  |  |  |  |  | 1 | 0 | 0.239 | 0.82 | duration | hardware | lqr | configs/my_rig.json | configs/lqr_my_rig_coupling_delay.json | 15.0
lqr_coupling_delay_20261107_022637 | lqr_coupling_delay | 2026-11-07 02:26 | run.json summary.json | 0 |  | 3 | 0.06 | 0.0 | docs/results/sac_focused_policy.zip |  |  |  |  |  |  | 1 | 0 | 0.408 | 3.36 | duration | hardware | lqr | configs/my_rig.json | configs/lqr_my_rig_coupling_delay.json | 15.0
lqr_coupling_delay_20261107_023430 | lqr_coupling_delay | 2026-11-07 02:34 | run.json summary.json | 0 |  | 3 | 0.05 | 0.0 | docs/results/sac_focused_policy.zip |  |  |  |  |  |  | 1 | 0 | 0.0 | 0.0 | duration | hardware | lqr | configs/my_rig.json | configs/lqr_my_rig_coupling_delay.json | 15.0
lqr_coupling_delay_20261107_025142 | lqr_coupling_delay | 2026-11-07 02:51 | run.json summary.json | 0 |  | 3 | 0.06 | 0.0 | docs/results/sac_focused_policy.zip |  |  |  |  |  |  | 1 | 0 | 0.273 | 1.46 | duration | hardware | lqr | configs/my_rig.json | configs/lqr_my_rig_coupling_delay.json | 15.0
lqr_coupling_delay_20261107_025340 | lqr_coupling_delay | 2026-11-07 02:53 | run.json summary.json | 0 |  | 3 | 0.06 | 0.0 | docs/results/sac_focused_policy.zip |  |  |  |  |  |  | 1 | 0 | 0.38 | 4.6 | duration | hardware | lqr | configs/my_rig.json | configs/lqr_my_rig_coupling_delay.json | 15.0
lqr_coupling_delay_20261107_025449 | lqr_coupling_delay | 2026-11-07 02:54 | run.json summary.json | 0 |  | 3 | 0.0 | 0.0 | docs/results/sac_focused_policy.zip |  |  |  |  |  |  | 1 | 0 |  |  | NonFiniteFeedback: Non-finite feedback | hardware | lqr | configs/my_rig.json | configs/lqr_my_rig_coupling_delay.json | 15.0
lqr_coupling_delay_20261107_025738 | lqr_coupling_delay | 2026-11-07 02:57 | run.json summary.json | 0 |  | 3 | 0.06 | 0.0 | docs/results/sac_focused_policy.zip |  |  |  |  |  |  | 1 | 1 | 0.805 | 11.92 | duration | hardware | lqr | configs/my_rig.json | configs/lqr_my_rig_coupling_delay.json | 15.0
lqr_coupling_delay_20261107_025826 | lqr_coupling_delay | 2026-11-07 02:58 | run.json summary.json | 0 |  | 3 | 0.06 | 0.0 | docs/results/sac_focused_policy.zip |  |  |  |  |  |  | 1 | 0 | 0.641 | 4.58 | duration | hardware | lqr | configs/my_rig.json | configs/lqr_my_rig_coupling_delay.json | 15.0
lqr_coupling_delay_20261107_025856 | lqr_coupling_delay | 2026-11-07 02:58 | run.json summary.json | 0 |  | 3 | 0.06 | 0.0 | docs/results/sac_focused_policy.zip |  |  |  |  |  |  | 1 | 1 | 0.748 | 11.1 | duration | hardware | lqr | configs/my_rig.json | configs/lqr_my_rig_coupling_delay.json | 15.0
lqr_coupling_delay_20261107_030130 | lqr_coupling_delay | 2026-11-07 03:01 | run.json summary.json | 0 |  | 3 | 0.06 | 0.0 | docs/results/sac_focused_policy.zip |  |  |  |  |  |  | 1 | 0 | 0.667 | 9.98 | duration | hardware | lqr | configs/my_rig.json | configs/lqr_my_rig_coupling_delay.json | 15.0
lqr_coupling_delay_20261107_030202 | lqr_coupling_delay | 2026-11-07 03:02 | run.json summary.json | 0 |  | 3 | 0.06 | 0.0 | docs/results/sac_focused_policy.zip |  |  |  |  |  |  | 1 | 1 | 0.856 | 12.84 | duration | hardware | lqr | configs/my_rig.json | configs/lqr_my_rig_coupling_delay.json | 15.0
lqr_coupling_delay_20261107_145456 | lqr_coupling_delay | 2026-11-07 14:54 | run.json summary.json | 0 |  | 3 | 0.06 | 0.0 | docs/results/sac_focused_policy.zip |  |  |  |  |  |  | 1 | 0 | 0.469 | 4.02 | duration | hardware | lqr | configs/my_rig.json | configs/lqr_my_rig_coupling_delay.json | 15.0
lqr_coupling_delay_20261107_145555 | lqr_coupling_delay | 2026-11-07 14:55 | run.json summary.json | 0 |  | 3 | 0.06 | 0.0 | docs/results/sac_focused_policy.zip |  |  |  |  |  |  | 1 | 1 | 0.675 | 10.08 | duration | hardware | lqr | configs/my_rig.json | configs/lqr_my_rig_coupling_delay.json | 15.0
lqr_coupling_delay_20261108_025746 | lqr_coupling_delay | 2026-11-08 02:57 | run.json summary.json | 0 |  | 3 | 0.06 | 0.0 | docs/results/sac_focused_policy.zip |  |  |  |  |  |  | 1 | 0 | 0.148 | 1.16 | duration | hardware | lqr | configs/my_rig.json | configs/lqr_my_rig_coupling_delay.json | 15.0
lqr_coupling_delay_20261108_030010 | lqr_coupling_delay | 2026-11-08 03:00 | run.json summary.json | 0 |  | 3 | 0.06 | 0.0 | docs/results/sac_focused_policy.zip |  |  |  |  |  |  | 1 | 0 | 0.557 | 8.1 | duration | hardware | lqr | configs/my_rig.json | configs/lqr_my_rig_coupling_delay.json | 15.0
lqr_coupling_delay_20261108_203853 | lqr_coupling_delay | 2026-11-08 20:38 | run.json summary.json | 0 |  | 3 | 0.01 | 0.0 | docs/results/sac_focused_policy.zip |  |  |  |  |  |  | 1 | 0 | 0.0 | 0.0 | KeyboardInterrupt: | hardware | lqr | configs/my_rig.json | configs/lqr_my_rig_coupling_delay.json | 15.0
lqr_coupling_delay_20261109_000909 | lqr_coupling_delay | 2026-11-09 00:09 | run.json summary.json | 0 |  | 3 | 0.0 | 0.0 | docs/results/sac_focused_policy.zip |  |  |  |  |  |  | 1 | 0 |  |  | RuntimeError: Firmware safety fault latched (bits=2); inspect before resetting | hardware | lqr | configs/my_rig.json | configs/lqr_my_rig_coupling_delay.json | 15.0
lqr_coupling_delay_20261109_000945 | lqr_coupling_delay | 2026-11-09 00:09 | run.json summary.json | 0 |  | 3 | 0.06 | 0.0 | docs/results/sac_focused_policy.zip |  |  |  |  |  |  | 1 | 0 | 0.716 | 9.48 | duration | hardware | lqr | configs/my_rig.json | configs/lqr_my_rig_coupling_delay.json | 15.0
lqr_coupling_delay_20261109_001013 | lqr_coupling_delay | 2026-11-09 00:10 | run.json summary.json | 0 |  | 3 | 0.06 | 0.0 | docs/results/sac_focused_policy.zip |  |  |  |  |  |  | 1 | 0 | 0.168 | 0.64 | duration | hardware | lqr | configs/my_rig.json | configs/lqr_my_rig_coupling_delay.json | 15.0
lqr_coupling_delay_20261109_001037 | lqr_coupling_delay | 2026-11-09 00:10 | run.json summary.json | 0 |  | 3 | 0.06 | 0.0 | docs/results/sac_focused_policy.zip |  |  |  |  |  |  | 1 | 0 | 0.184 | 1.14 | duration | hardware | lqr | configs/my_rig.json | configs/lqr_my_rig_coupling_delay.json | 15.0
lqr_coupling_delay_20261109_001102 | lqr_coupling_delay | 2026-11-09 00:11 | run.json summary.json | 0 |  | 3 | 0.06 | 0.0 | docs/results/sac_focused_policy.zip |  |  |  |  |  |  | 1 | 0 | 0.072 | 0.26 | duration | hardware | lqr | configs/my_rig.json | configs/lqr_my_rig_coupling_delay.json | 15.0
lqr_coupling_delay_20261109_001134 | lqr_coupling_delay | 2026-11-09 00:11 | run.json summary.json | 0 |  | 3 | 0.02 | 0.0 | docs/results/sac_focused_policy.zip |  |  |  |  |  |  | 1 | 0 | 0.021 | 0.08 | KeyboardInterrupt: | hardware | lqr | configs/my_rig.json | configs/lqr_my_rig_coupling_delay.json | 15.0
lqr_coupling_delay_20261109_001151 | lqr_coupling_delay | 2026-11-09 00:11 | run.json summary.json | 0 |  | 3 | 0.04 | 0.0 | docs/results/sac_focused_policy.zip |  |  |  |  |  |  | 1 | 0 | 0.131 | 0.48 | KeyboardInterrupt: | hardware | lqr | configs/my_rig.json | configs/lqr_my_rig_coupling_delay.json | 15.0
lqr_coupling_delay_20261109_001212 | lqr_coupling_delay | 2026-11-09 00:12 | run.json summary.json | 0 |  | 3 | 0.06 | 0.0 | docs/results/sac_focused_policy.zip |  |  |  |  |  |  | 1 | 0 | 0.052 | 0.32 | duration | hardware | lqr | configs/my_rig.json | configs/lqr_my_rig_coupling_delay.json | 15.0
lqr_coupling_delay_20261109_001425 | lqr_coupling_delay | 2026-11-09 00:14 | run.json summary.json | 0 |  | 3 | 0.06 | 0.0 | docs/results/sac_focused_policy.zip |  |  |  |  |  |  | 1 | 0 | 0.277 | 2.56 | duration | hardware | lqr | configs/my_rig.json | configs/lqr_my_rig_coupling_delay.json | 15.0
lqr_coupling_delay_20261109_001451 | lqr_coupling_delay | 2026-11-09 00:14 | run.json summary.json | 0 |  | 3 | 0.0 | 0.0 | docs/results/sac_focused_policy.zip |  |  |  |  |  |  | 1 | 0 |  |  | RuntimeError: Start requires a physically centered arm and still hanging pendulum | hardware | lqr | configs/my_rig.json | configs/lqr_my_rig_coupling_delay.json | 15.0
lqr_coupling_delay_20261109_001459 | lqr_coupling_delay | 2026-11-09 00:14 | run.json summary.json | 0 |  | 3 | 0.06 | 0.0 | docs/results/sac_focused_policy.zip |  |  |  |  |  |  | 1 | 0 | 0.121 | 0.64 | duration | hardware | lqr | configs/my_rig.json | configs/lqr_my_rig_coupling_delay.json | 15.0
lqr_coupling_delay_20261109_001523 | lqr_coupling_delay | 2026-11-09 00:15 | run.json summary.json | 0 |  | 3 | 0.06 | 0.0 | docs/results/sac_focused_policy.zip |  |  |  |  |  |  | 1 | 0 | 0.052 | 0.22 | duration | hardware | lqr | configs/my_rig.json | configs/lqr_my_rig_coupling_delay.json | 15.0
lqr_coupling_delay_20261109_001607 | lqr_coupling_delay | 2026-11-09 00:16 | run.json summary.json | 0 |  | 3 | 0.06 | 0.0 | docs/results/sac_focused_policy.zip |  |  |  |  |  |  | 1 | 0 | 0.072 | 0.24 | duration | hardware | lqr | configs/my_rig.json | configs/lqr_my_rig_coupling_delay.json | 15.0
lqr_coupling_delay_20261109_001710 | lqr_coupling_delay | 2026-11-09 00:17 | run.json summary.json | 0 |  | 3 | 0.06 | 0.0 | docs/results/sac_focused_policy.zip |  |  |  |  |  |  | 1 | 0 | 0.381 | 4.5 | duration | hardware | lqr | configs/my_rig.json | configs/lqr_my_rig_coupling_delay.json | 15.0
lqr_coupling_delay_20261109_001738 | lqr_coupling_delay | 2026-11-09 00:17 | run.json summary.json | 0 |  | 3 | 0.06 | 0.0 | docs/results/sac_focused_policy.zip |  |  |  |  |  |  | 1 | 0 | 0.161 | 0.52 | duration | hardware | lqr | configs/my_rig.json | configs/lqr_my_rig_coupling_delay.json | 15.0
lqr_coupling_delay_20261109_001852 | lqr_coupling_delay | 2026-11-09 00:18 | run.json summary.json | 0 |  | 3 | 0.06 | 0.0 | docs/results/sac_focused_policy.zip |  |  |  |  |  |  | 1 | 0 | 0.171 | 1.68 | duration | hardware | lqr | configs/my_rig.json | configs/lqr_my_rig_coupling_delay.json | 15.0
lqr_coupling_delay_20261109_002009 | lqr_coupling_delay | 2026-11-09 00:20 | run.json summary.json | 0 |  | 3 | 0.06 | 0.0 | docs/results/sac_focused_policy.zip |  |  |  |  |  |  | 1 | 0 | 0.208 | 2.44 | duration | hardware | lqr | configs/my_rig.json | configs/lqr_my_rig_coupling_delay.json | 15.0
lqr_coupling_delay_20261109_002150 | lqr_coupling_delay | 2026-11-09 00:21 | run.json summary.json | 0 |  | 3 | 0.0 | 0.0 | docs/results/sac_focused_policy.zip |  |  |  |  |  |  | 1 | 0 |  |  | KeyboardInterrupt: | hardware | lqr | configs/my_rig.json | configs/lqr_my_rig_coupling_delay.json | 15.0
lqr_coupling_delay_20261109_002157 | lqr_coupling_delay | 2026-11-09 00:21 | run.json summary.json | 0 |  | 3 | 0.06 | 0.0 | docs/results/sac_focused_policy.zip |  |  |  |  |  |  | 1 | 0 | 0.173 | 1.44 | duration | hardware | lqr | configs/my_rig.json | configs/lqr_my_rig_coupling_delay.json | 15.0
lqr_coupling_delay_20261109_002228 | lqr_coupling_delay | 2026-11-09 00:22 | run.json summary.json | 0 |  | 3 | 0.02 | 0.0 | docs/results/sac_focused_policy.zip |  |  |  |  |  |  | 1 | 0 | 0.069 | 0.18 | KeyboardInterrupt: | hardware | lqr | configs/my_rig.json | configs/lqr_my_rig_coupling_delay.json | 15.0
lqr_coupling_delay_20261109_002243 | lqr_coupling_delay | 2026-11-09 00:22 | run.json summary.json | 0 |  | 3 | 0.03 | 0.0 | docs/results/sac_focused_policy.zip |  |  |  |  |  |  | 1 | 0 | 0.003 | 0.02 | KeyboardInterrupt: | hardware | lqr | configs/my_rig.json | configs/lqr_my_rig_coupling_delay.json | 15.0
lqr_coupling_delay_20261109_002442 | lqr_coupling_delay | 2026-11-09 00:24 | run.json summary.json | 0 |  | 3 | 0.02 | 0.0 | docs/results/sac_focused_policy.zip |  |  |  |  |  |  | 1 | 0 | 0.103 | 0.18 | KeyboardInterrupt: | hardware | lqr | configs/my_rig.json | configs/lqr_my_rig_coupling_delay.json | 15.0
lqr_coupling_delay_20261109_002455 | lqr_coupling_delay | 2026-11-09 00:24 | run.json summary.json | 0 |  | 3 | 0.06 | 0.0 | docs/results/sac_focused_policy.zip |  |  |  |  |  |  | 1 | 0 | 0.087 | 0.22 | duration | hardware | lqr | configs/my_rig.json | configs/lqr_my_rig_coupling_delay.json | 15.0
lqr_coupling_delay_20261109_003726 | lqr_coupling_delay | 2026-11-09 00:37 | run.json summary.json | 0 |  | 3 | 0.02 | 0.0 | docs/results/sac_focused_policy.zip |  |  |  |  |  |  | 1 | 0 | 0.075 | 0.24 | KeyboardInterrupt: | hardware | lqr | configs/my_rig.json | configs/lqr_my_rig_coupling_delay.json | 15.0
lqr_coupling_delay_20261109_003740 | lqr_coupling_delay | 2026-11-09 00:37 | run.json summary.json | 0 |  | 3 | 0.02 | 0.0 | docs/results/sac_focused_policy.zip |  |  |  |  |  |  | 1 | 0 | 0.051 | 0.1 | KeyboardInterrupt: | hardware | lqr | configs/my_rig.json | configs/lqr_my_rig_coupling_delay.json | 15.0
lqr_coupling_delay_20261109_003756 | lqr_coupling_delay | 2026-11-09 00:37 | run.json summary.json | 0 |  | 3 | 0.06 | 0.0 | docs/results/sac_focused_policy.zip |  |  |  |  |  |  | 1 | 0 | 0.109 | 0.62 | duration | hardware | lqr | configs/my_rig.json | configs/lqr_my_rig_coupling_delay.json | 15.0
lqr_coupling_delay_20261109_004232 | lqr_coupling_delay | 2026-11-09 00:42 | run.json summary.json | 0 |  | 3 | 0.06 | 0.0 | docs/results/sac_focused_policy.zip |  |  |  |  |  |  | 1 | 0 | 0.74 | 7.7 | duration | hardware | lqr | configs/my_rig.json | configs/lqr_my_rig_coupling_delay.json | 15.0
lqr_coupling_delay_20261109_011506 | lqr_coupling_delay | 2026-11-09 01:15 | run.json summary.json | 0 |  | 3 | 0.06 | 0.0 | docs/results/sac_focused_policy.zip |  |  |  |  |  |  | 1 | 1 | 0.771 | 10.46 | duration | hardware | lqr | configs/my_rig.json | configs/lqr_my_rig_coupling_delay.json | 15.0
lqr_coupling_delay_20261109_152405 | lqr_coupling_delay | 2026-11-09 15:24 | run.json summary.json | 0 |  | 3 | 0.12 | 0.0 | docs/results/sac_focused_policy.zip |  |  |  |  |  |  | 1 | 0 | 0.677 | 11.26 | duration | hardware | lqr | configs/my_rig.json | configs/lqr_my_rig_coupling_delay.json | 30.0
lqr_diagnosis_01 | lqr_diagnosis | 2026-11-07 01:44 (mtime) | summary.json | 0 |  | 10 | 0.03 | 0.0 |  |  |  |  |  |  |  | 1 | 0
lqr_feedback_01 | lqr_feedback | 2026-11-07 00:28 (mtime) | summary.json | 0 |  | 2 | 0.01 | 0.0 |  |  |  |  |  |  |  | 1 | 0
lqr_hw_01 | lqr_hw | 2026-11-06 21:29 (mtime) | run.json summary.json | 0 |  | 3 | 0.01 | 0.0 |  |  |  |  |  |  |  | 1 | 0 | 0.0 | 0.0 | duration | hardware | lqr | configs/my_rig.json | configs/lqr_my_rig.json | 3.0
lqr_hw_02 | lqr_hw | 2026-11-06 21:32 (mtime) | run.json summary.json | 0 |  | 3 | 0.01 | 0.0 |  |  |  |  |  |  |  | 1 | 0 | 0.0 | 0.0 | duration | hardware | lqr | configs/my_rig.json | configs/lqr_my_rig.json | 5.0
lqr_hw_03 | lqr_hw | 2026-11-06 21:34 (mtime) | run.json summary.json | 0 |  | 3 | 0.01 | 0.0 |  |  |  |  |  |  |  | 1 | 0 | 0.448 | 2.24 | duration | hardware | lqr | configs/my_rig.json | configs/lqr_my_rig_capture.json | 5.0
lqr_hw_04 | lqr_hw | 2026-11-06 21:50 (mtime) | run.json summary.json | 0 |  | 3 | 0.02 | 0.0 |  |  |  |  |  |  |  | 1 | 0 | 0.097 | 0.64 | duration | hardware | lqr | configs/my_rig.json | configs/lqr_my_rig_capture.json | 15.0
lqr_hw_05 | lqr_hw | 2026-11-06 21:55 (mtime) | run.json summary.json | 0 |  | 3 | 0.01 | 0.0 |  |  |  |  |  |  |  | 1 | 0 | 0.032 | 0.16 | duration | hardware | lqr | configs/my_rig.json | configs/lqr_my_rig_guarded.json | 5.0
lqr_hw_06 | lqr_hw | 2026-11-06 23:46 (mtime) | run.json summary.json | 0 |  | 3 | 0.01 | 0.0 |  |  |  |  |  |  |  | 1 | 0 | 0.004 | 0.02 | duration | hardware | lqr | configs/my_rig.json | configs/lqr_my_rig_guarded.json | 5.0
lqr_hw_07 | lqr_hw | 2026-11-06 23:57 (mtime) | run.json summary.json | 0 |  | 3 | 0.01 | 0.0 |  |  |  |  |  |  |  | 1 | 0 | 0.0 | 0.0 | duration | hardware | lqr | configs/my_rig.json | configs/lqr_my_rig_robust.json | 5.0
lqr_hw_08 | lqr_hw | 2026-11-06 23:58 (mtime) | run.json summary.json | 0 |  | 3 | 0.01 | 0.0 |  |  |  |  |  |  |  | 1 | 0 | 0.0 | 0.0 | duration | hardware | lqr | configs/my_rig.json | configs/lqr_my_rig_robust.json | 8.0
lqr_hw_09 | lqr_hw | 2026-11-07 00:15 (mtime) | run.json summary.json | 0 |  | 3 | 0.01 | 0.0 |  |  |  |  |  |  |  | 1 | 0 | 0.147 | 1.18 | duration | hardware | lqr | configs/my_rig.json | configs/lqr_my_rig_adaptive.json | 8.0
lqr_hw_10 | lqr_hw | 2026-11-07 00:33 (mtime) | run.json summary.json | 0 |  | 3 | 0.01 | 0.0 |  |  |  |  |  |  |  | 1 | 0 | 0.015 | 0.08 | duration | hardware | lqr | configs/my_rig.json | configs/lqr_my_rig_filtered.json | 8.0
lqr_hw_11 | lqr_hw | 2026-11-07 00:55 (mtime) | run.json summary.json | 0 |  | 3 | 0.01 | 0.0 | docs/results/sac_focused_policy.zip |  |  |  |  |  |  | 1 | 0 | 0.0 | 0.0 | duration | hardware | lqr | configs/my_rig.json | configs/lqr_my_rig_learned_swing.json | 3.0
lqr_hw_12 | lqr_hw | 2026-11-07 01:24 (mtime) | run.json summary.json | 0 |  | 3 | 0.01 | 0.0 | docs/results/sac_focused_policy.zip |  |  |  |  |  |  | 1 | 0 | 0.327 | 0.98 | duration | hardware | lqr | configs/my_rig.json | configs/lqr_my_rig_braked_swing.json | 3.0
lqr_hw_13 | lqr_hw | 2026-11-07 01:26 (mtime) | run.json summary.json | 0 |  | 3 | 0.05 | 0.0 | docs/results/sac_focused_policy.zip |  |  |  |  |  |  | 1 | 0 | 0.243 | 1.18 | duration | hardware | lqr | configs/my_rig.json | configs/lqr_my_rig_braked_swing.json | 15.0
lqr_hw_14 | lqr_hw | 2026-11-07 01:26 (mtime) | run.json summary.json | 0 |  | 3 | 0.05 | 0.0 | docs/results/sac_focused_policy.zip |  |  |  |  |  |  | 1 | 0 | 0.163 | 1.1 | duration | hardware | lqr | configs/my_rig.json | configs/lqr_my_rig_braked_swing.json | 15.0
lqr_hw_15 | lqr_hw | 2026-11-07 02:10 (mtime) | run.json summary.json | 0 |  | 3 | 0.06 | 0.0 | docs/results/sac_focused_policy.zip |  |  |  |  |  |  | 1 | 0 | 0.428 | 2.36 | duration | hardware | lqr | configs/my_rig.json | configs/lqr_my_rig_observed.json | 15.0
lqr_hw_18 | lqr_hw | 2026-11-07 02:10 (mtime) | run.json summary.json | 0 |  | 3 | 0.02 | 0.0 | docs/results/sac_focused_policy.zip |  |  |  |  |  |  | 1 | 0 | 0.073 | 0.24 | duration | hardware | lqr | configs/my_rig.json | configs/lqr_my_rig_observed.json | 6.0
lqr_learned_robustness_01 | lqr_learned_robustness | 2026-11-07 00:48 (mtime) | summary.json | 0 |  | 2 | 0.01 | 0.0 |  |  |  |  |  |  |  | 1 | 0
lqr_observer_01 | lqr_observer | 2026-11-07 01:54 (mtime) | summary.json | 0 |  | 4 | 0.01 | 0.0 |  |  |  |  |  |  |  | 1 | 0
lqr_observer_02 | lqr_observer | 2026-11-07 01:57 (mtime) | summary.json | 0 |  | 4 | 0.01 | 0.0 |  |  |  |  |  |  |  | 1 | 0
lqr_recenter_01 | lqr_recenter | 2026-11-07 01:35 (mtime) | summary.json | 0 |  | 4 | 0.01 | 0.0 |  |  |  |  |  |  |  | 1 | 0
lqr_robustness_01 | lqr_robustness | 2026-11-06 23:56 (mtime) | run.json summary.json | 0 |  | 27 | 0.09 | 0.0 |  |  |  |  |  |  |  | 1 | 0
lqr_robustness_02 | lqr_robustness | 2026-11-06 23:56 (mtime) | run.json summary.json | 0 |  | 27 | 0.09 | 0.0 |  |  |  |  |  |  |  | 1 | 0
lqr_robustness_03 | lqr_robustness | 2026-11-07 00:07 (mtime) | run.json summary.json | 0 |  | 51 | 0.18 | 0.0 |  |  |  |  |  |  |  | 1 | 0
lqr_robustness_04 | lqr_robustness | 2026-11-07 00:07 (mtime) | run.json summary.json | 0 |  | 51 | 0.18 | 0.0 |  |  |  |  |  |  |  | 1 | 0
lqr_robustness_05 | lqr_robustness | 2026-11-07 00:17 (mtime) | run.json summary.json | 0 |  | 51 | 0.18 | 0.0 |  |  |  |  |  |  |  | 1 | 0
lqr_robustness_06 | lqr_robustness | 2026-11-07 00:27 (mtime) | run.json summary.json | 0 |  | 51 | 0.18 | 0.0 |  |  |  |  |  |  |  | 1 | 0
lqr_sim_adaptive_01 | lqr_sim_adaptive | 2026-11-07 00:07 (mtime) | run.json summary.json | 0 |  | 3 | 0.03 | 0.0 |  |  |  |  |  |  |  | 1 | 1 | 0.793 | 11.9 | duration | sim | lqr | configs/my_rig.json | configs/lqr_my_rig_adaptive.json | 15.0
lqr_sim_adaptive_02 | lqr_sim_adaptive | 2026-11-07 00:17 (mtime) | run.json summary.json | 0 |  | 3 | 0.03 | 0.0 |  |  |  |  |  |  |  | 1 | 1 | 0.793 | 11.9 | duration | sim | lqr | configs/my_rig.json | configs/lqr_my_rig_adaptive_15ms.json | 15.0
lqr_sim_braked_01 | lqr_sim_braked | 2026-11-07 01:01 (mtime) | run.json summary.json | 0 |  | 3 | 0.03 | 0.0 | docs/results/sac_focused_policy.zip |  |  |  |  |  |  | 1 | 1 | 0.859 | 12.88 | duration | sim | lqr | configs/my_rig.json | configs/lqr_my_rig_braked_swing.json | 15.0
lqr_sim_capture_01 | lqr_sim_capture | 2026-11-06 21:33 (mtime) | run.json summary.json | 0 |  | 3 | 0.03 | 0.0 |  |  |  |  |  |  |  | 1 | 1 | 0.897 | 13.46 | duration | sim | lqr | configs/my_rig.json | configs/lqr_my_rig_capture.json | 15.0
lqr_sim_filtered_01 | lqr_sim_filtered | 2026-11-07 00:27 (mtime) | run.json summary.json | 0 |  | 3 | 0.03 | 0.0 |  |  |  |  |  |  |  | 1 | 1 | 0.793 | 11.9 | duration | sim | lqr | configs/my_rig.json | configs/lqr_my_rig_filtered.json | 15.0
lqr_sim_guarded_01 | lqr_sim_guarded | 2026-11-06 21:53 (mtime) | run.json summary.json | 0 |  | 3 | 0.03 | 0.0 |  |  |  |  |  |  |  | 1 | 1 | 0.897 | 13.46 | duration | sim | lqr | configs/my_rig.json | configs/lqr_my_rig_guarded.json | 15.0
lqr_sim_guarded_02 | lqr_sim_guarded | 2026-11-06 23:44 (mtime) | run.json summary.json | 0 |  | 3 | 0.03 | 0.0 |  |  |  |  |  |  |  | 1 | 0 | 0.045 | 0.32 | duration | sim | lqr | configs/my_rig.json | configs/lqr_my_rig_guarded.json | 15.0
lqr_sim_guarded_03 | lqr_sim_guarded | 2026-11-06 23:46 (mtime) | run.json summary.json | 0 |  | 3 | 0.03 | 0.0 |  |  |  |  |  |  |  | 1 | 1 | 0.897 | 13.46 | duration | sim | lqr | configs/my_rig.json | configs/lqr_my_rig_guarded.json | 15.0
lqr_sim_learned_01 | lqr_sim_learned | 2026-11-07 00:46 (mtime) | run.json summary.json | 0 |  | 3 | 0.03 | 0.0 | docs/results/sac_focused_policy.zip |  |  |  |  |  |  | 1 | 1 | 0.86 | 12.9 | duration | sim | lqr | configs/my_rig.json | configs/lqr_my_rig_learned_swing.json | 15.0
lqr_sim_my_rig_01 | lqr_sim_my_rig | 2026-11-06 21:23 (mtime) | run.json summary.json | 0 |  | 4 | 0.14 | 0.0 |  |  |  |  |  |  |  | 1 | 0 | 0.0 | 0.0 | arm_guard | sim | lqr | configs/my_rig.json |  | 15.0
lqr_sim_my_rig_03 | lqr_sim_my_rig | 2026-11-06 21:26 (mtime) | run.json summary.json | 0 |  | 4 | 1.01 | 0.0 |  |  |  |  |  |  |  | 1 | 1 | 0.897 | 13.46 | duration | sim | lqr | configs/my_rig.json | configs/lqr_my_rig.json | 15.0
lqr_sim_my_rig_04 | lqr_sim_my_rig | 2026-11-06 21:26 (mtime) | run.json summary.json | 0 |  | 4 | 1.02 | 0.0 |  |  |  |  |  |  |  | 1 | 1 | 0.897 | 13.46 | duration | sim | lqr | configs/my_rig.json | configs/lqr_my_rig.json | 15.0
lqr_sim_observed_01 | lqr_sim_observed | 2026-11-07 01:54 (mtime) | run.json summary.json | 0 |  | 3 | 0.03 | 0.0 | docs/results/sac_focused_policy.zip |  |  |  |  |  |  | 1 | 1 | 0.859 | 12.88 | duration | sim | lqr | configs/my_rig.json | configs/lqr_my_rig_observed.json | 15.0
lqr_sim_observed_02 | lqr_sim_observed | 2026-11-07 01:56 (mtime) | run.json summary.json | 0 |  | 3 | 0.03 | 0.0 | docs/results/sac_focused_policy.zip |  |  |  |  |  |  | 1 | 1 | 0.859 | 12.88 | duration | sim | lqr | configs/my_rig.json | configs/lqr_my_rig_observed.json | 15.0
lqr_sim_recenter_01 | lqr_sim_recenter | 2026-11-07 01:34 (mtime) | run.json summary.json | 0 |  | 3 | 0.03 | 0.0 | docs/results/sac_focused_policy.zip |  |  |  |  |  |  | 1 | 1 | 0.859 | 12.88 | duration | sim | lqr | configs/my_rig.json | configs/lqr_my_rig_recenter.json | 15.0
lqr_sim_robust_01 | lqr_sim_robust | 2026-11-06 23:56 (mtime) | run.json summary.json | 0 |  | 3 | 0.03 | 0.0 |  |  |  |  |  |  |  | 1 | 1 | 0.824 | 12.36 | duration | sim | lqr | configs/my_rig.json | configs/lqr_my_rig_robust.json | 15.0
lqr_swing_20261107_024813 | lqr_swing | 2026-11-07 02:48 | run.json summary.json | 0 |  | 3 | 0.06 | 0.0 | docs/results/sac_focused_policy.zip |  |  |  |  |  |  | 1 | 0 | 0.176 | 0.96 | duration | hardware | lqr | configs/my_rig.json | configs/lqr_my_rig_swing.json | 15.0
lqr_swing_20261107_024848 | lqr_swing | 2026-11-07 02:48 | run.json summary.json | 0 |  | 3 | 0.06 | 0.0 | docs/results/sac_focused_policy.zip |  |  |  |  |  |  | 1 | 0 | 0.312 | 2.18 | duration | hardware | lqr | configs/my_rig.json | configs/lqr_my_rig_swing.json | 15.0
lqr_swing_20261107_024917 | lqr_swing | 2026-11-07 02:49 | run.json summary.json | 0 |  | 3 | 0.12 | 0.0 | docs/results/sac_focused_policy.zip |  |  |  |  |  |  | 1 | 0 | 0.131 | 1.28 | duration | hardware | lqr | configs/my_rig.json | configs/lqr_my_rig_swing.json | 30.0
lqr_upright_learned_01 | lqr_upright_learned | 2026-11-07 00:46 (mtime) | run.json summary.json | 0 |  | 12 | 0.32 | 0.0 | docs/results/sac_focused_policy.zip |  |  |  |  |  |  | 10 | 9 | 0.898 | 15.0 | duration | sim | lqr | configs/my_rig.json | configs/lqr_my_rig_learned_swing.json | 15.0
mpc_20261109_001243 | mpc | 2026-11-09 00:12 | run.json summary.json | 0 |  | 3 | 0.06 | 0.0 | docs/results/sac_focused_policy.zip |  |  |  |  |  |  | 1 | 0 | 0.132 | 0.52 | duration | hardware | mpc | configs/my_rig.json | configs/mpc_my_rig_transfer.json | 15.0
mpc_20261109_001308 | mpc | 2026-11-09 00:13 | run.json summary.json | 0 |  | 3 | 0.06 | 0.0 | docs/results/sac_focused_policy.zip |  |  |  |  |  |  | 1 | 0 | 0.351 | 2.5 | duration | hardware | mpc | configs/my_rig.json | configs/mpc_my_rig_transfer.json | 15.0
mpc_coupling_delay_20261107_031705 | mpc_coupling_delay | 2026-11-07 03:17 | run.json summary.json | 0 |  | 3 | 0.05 | 0.0 | docs/results/sac_focused_policy.zip |  |  |  |  |  |  | 1 | 0 | 0.268 | 2.54 | duration | hardware | mpc | configs/my_rig.json | configs/mpc_my_rig_coupling_delay.json | 15.0
mpc_coupling_delay_20261107_031732 | mpc_coupling_delay | 2026-11-07 03:17 | run.json summary.json | 0 |  | 3 | 0.06 | 0.0 | docs/results/sac_focused_policy.zip |  |  |  |  |  |  | 1 | 0 | 0.337 | 1.96 | duration | hardware | mpc | configs/my_rig.json | configs/mpc_my_rig_coupling_delay.json | 15.0
mpc_hw_20261107_031251 | mpc_hw | 2026-11-07 03:12 | run.json summary.json | 0 |  | 3 | 0.01 | 0.0 | docs/results/sac_focused_policy.zip |  |  |  |  |  |  | 1 | 0 | 0.013 | 0.04 | duration | hardware | mpc | configs/my_rig.json | configs/mpc_my_rig.json | 3.0
mpc_hw_20261107_031325 | mpc_hw | 2026-11-07 03:13 | run.json summary.json | 0 |  | 3 | 0.05 | 0.0 | docs/results/sac_focused_policy.zip |  |  |  |  |  |  | 1 | 0 | 0.181 | 1.14 | duration | hardware | mpc | configs/my_rig.json | configs/mpc_my_rig.json | 15.0
mpc_hw_20261107_031411 | mpc_hw | 2026-11-07 03:14 | run.json summary.json | 0 |  | 3 | 0.05 | 0.0 | docs/results/sac_focused_policy.zip |  |  |  |  |  |  | 1 | 0 | 0.16 | 1.0 | duration | hardware | mpc | configs/my_rig.json | configs/mpc_my_rig.json | 15.0
mpc_low_r_20261107_153810 | mpc_low_r | 2026-11-07 15:38 | run.json summary.json | 0 |  | 3 | 0.06 | 0.0 | docs/results/sac_focused_policy.zip |  |  |  |  |  |  | 1 | 0 | 0.055 | 0.44 | duration | hardware | mpc | configs/my_rig.json | configs/mpc_my_rig_low_r.json | 15.0
mpc_low_r_20261107_153838 | mpc_low_r | 2026-11-07 15:38 | run.json summary.json | 0 |  | 3 | 0.06 | 0.0 | docs/results/sac_focused_policy.zip |  |  |  |  |  |  | 1 | 0 | 0.107 | 0.4 | duration | hardware | mpc | configs/my_rig.json | configs/mpc_my_rig_low_r.json | 15.0
mpc_low_r_20261107_153932 | mpc_low_r | 2026-11-07 15:39 | run.json summary.json | 0 |  | 3 | 0.06 | 0.0 | docs/results/sac_focused_policy.zip |  |  |  |  |  |  | 1 | 0 | 0.04 | 0.2 | duration | hardware | mpc | configs/my_rig.json | configs/mpc_my_rig_low_r.json | 15.0
mpc_low_r_20261107_154431 | mpc_low_r | 2026-11-07 15:44 | run.json summary.json | 0 |  | 3 | 0.06 | 0.0 | docs/results/sac_focused_policy.zip |  |  |  |  |  |  | 1 | 0 | 0.092 | 0.9 | duration | hardware | mpc | configs/my_rig.json | configs/mpc_my_rig_low_r.json | 15.0
mpc_low_r_20261107_154510 | mpc_low_r | 2026-11-07 15:45 | run.json summary.json | 0 |  | 3 | 0.06 | 0.0 | docs/results/sac_focused_policy.zip |  |  |  |  |  |  | 1 | 0 | 0.213 | 1.4 | duration | hardware | mpc | configs/my_rig.json | configs/mpc_my_rig_low_r.json | 15.0
mpc_low_r_20261107_154540 | mpc_low_r | 2026-11-07 15:45 | run.json summary.json | 0 |  | 3 | 0.06 | 0.0 | docs/results/sac_focused_policy.zip |  |  |  |  |  |  | 1 | 0 | 0.124 | 1.12 | duration | hardware | mpc | configs/my_rig.json | configs/mpc_my_rig_low_r.json | 15.0
mpc_strict_catch_20261107_151727 | mpc_strict_catch | 2026-11-07 15:17 | run.json summary.json | 0 |  | 3 | 0.06 | 0.0 | docs/results/sac_focused_policy.zip |  |  |  |  |  |  | 1 | 0 | 0.204 | 2.02 | duration | hardware | mpc | configs/my_rig.json | configs/mpc_my_rig_strict_catch.json | 15.0
mpc_strict_catch_20261107_151807 | mpc_strict_catch | 2026-11-07 15:18 | run.json summary.json | 0 |  | 3 | 0.0 | 0.0 | docs/results/sac_focused_policy.zip |  |  |  |  |  |  | 1 | 0 |  |  | RuntimeError: Start requires a physically centered arm and still hanging pendulum | hardware | mpc | configs/my_rig.json | configs/mpc_my_rig_strict_catch.json | 15.0
mpc_strict_catch_20261107_151820 | mpc_strict_catch | 2026-11-07 15:18 | run.json summary.json | 0 |  | 3 | 0.06 | 0.0 | docs/results/sac_focused_policy.zip |  |  |  |  |  |  | 1 | 0 | 0.536 | 2.32 | duration | hardware | mpc | configs/my_rig.json | configs/mpc_my_rig_strict_catch.json | 15.0
mpc_strict_catch_20261107_151856 | mpc_strict_catch | 2026-11-07 15:18 | run.json summary.json | 0 |  | 3 | 0.06 | 0.0 | docs/results/sac_focused_policy.zip |  |  |  |  |  |  | 1 | 0 | 0.12 | 1.08 | duration | hardware | mpc | configs/my_rig.json | configs/mpc_my_rig_strict_catch.json | 15.0
mpc_strict_catch_20261107_151926 | mpc_strict_catch | 2026-11-07 15:19 | run.json summary.json | 0 |  | 3 | 0.06 | 0.0 | docs/results/sac_focused_policy.zip |  |  |  |  |  |  | 1 | 0 | 0.48 | 5.9 | duration | hardware | mpc | configs/my_rig.json | configs/mpc_my_rig_strict_catch.json | 15.0
mpc_strict_catch_20261107_152007 | mpc_strict_catch | 2026-11-07 15:20 | run.json summary.json | 0 |  | 3 | 0.02 | 0.0 | docs/results/sac_focused_policy.zip |  |  |  |  |  |  | 1 | 0 | 0.0 | 0.0 | KeyboardInterrupt: | hardware | mpc | configs/my_rig.json | configs/mpc_my_rig_strict_catch.json | 15.0
mpc_strict_catch_20261107_152024 | mpc_strict_catch | 2026-11-07 15:20 | run.json summary.json | 0 |  | 3 | 0.06 | 0.0 | docs/results/sac_focused_policy.zip |  |  |  |  |  |  | 1 | 0 | 0.219 | 1.68 | duration | hardware | mpc | configs/my_rig.json | configs/mpc_my_rig_strict_catch.json | 15.0
mpc_strict_catch_20261107_152120 | mpc_strict_catch | 2026-11-07 15:21 | run.json summary.json | 0 |  | 3 | 0.06 | 0.0 | docs/results/sac_focused_policy.zip |  |  |  |  |  |  | 1 | 0 | 0.285 | 1.52 | duration | hardware | mpc | configs/my_rig.json | configs/mpc_my_rig_strict_catch.json | 15.0
mpc_strict_catch_20261107_152222 | mpc_strict_catch | 2026-11-07 15:22 | run.json summary.json | 0 |  | 3 | 0.06 | 0.0 | docs/results/sac_focused_policy.zip |  |  |  |  |  |  | 1 | 0 | 0.208 | 0.78 | duration | hardware | mpc | configs/my_rig.json | configs/mpc_my_rig_strict_catch.json | 15.0
mpc_strict_catch_20261107_152353 | mpc_strict_catch | 2026-11-07 15:23 | run.json summary.json | 0 |  | 3 | 0.0 | 0.0 | docs/results/sac_focused_policy.zip |  |  |  |  |  |  | 1 | 0 |  |  | RuntimeError: Firmware safety fault latched (bits=2); inspect before resetting | hardware | mpc | configs/my_rig.json | configs/mpc_my_rig_strict_catch.json | 15.0
mpc_transfer_20261107_150201 | mpc_transfer | 2026-11-07 15:02 | run.json summary.json | 0 |  | 3 | 0.06 | 0.0 | docs/results/sac_focused_policy.zip |  |  |  |  |  |  | 1 | 0 | 0.315 | 2.8 | duration | hardware | mpc | configs/my_rig.json | configs/mpc_my_rig_transfer.json | 15.0
mpc_transfer_20261107_150408 | mpc_transfer | 2026-11-07 15:04 | run.json summary.json | 0 |  | 3 | 0.06 | 0.0 | docs/results/sac_focused_policy.zip |  |  |  |  |  |  | 1 | 0 | 0.216 | 0.98 | duration | hardware | mpc | configs/my_rig.json | configs/mpc_my_rig_transfer.json | 15.0
mpc_transfer_20261107_150624 | mpc_transfer | 2026-11-07 15:06 | run.json summary.json | 0 |  | 3 | 0.0 | 0.0 | docs/results/sac_focused_policy.zip |  |  |  |  |  |  | 1 | 0 | 0.0 | 0.0 | RuntimeError: Non-finite feedback (firmware fault bits=2, encoder) | hardware | mpc | configs/my_rig.json | configs/mpc_my_rig_transfer.json | 15.0
mpc_transfer_20261107_150642 | mpc_transfer | 2026-11-07 15:06 | run.json summary.json | 0 |  | 3 | 0.0 | 0.0 | docs/results/sac_focused_policy.zip |  |  |  |  |  |  | 1 | 0 |  |  | RuntimeError: Non-finite feedback (firmware fault bits=2, encoder) | hardware | mpc | configs/my_rig.json | configs/mpc_my_rig_transfer.json | 15.0
mpc_transfer_20261107_150748 | mpc_transfer | 2026-11-07 15:07 | run.json summary.json | 0 |  | 3 | 0.06 | 0.0 | docs/results/sac_focused_policy.zip |  |  |  |  |  |  | 1 | 0 | 0.232 | 1.14 | duration | hardware | mpc | configs/my_rig.json | configs/mpc_my_rig_transfer.json | 15.0
mpc_transfer_20261107_150833 | mpc_transfer | 2026-11-07 15:08 | run.json summary.json | 0 |  | 3 | 0.06 | 0.0 | docs/results/sac_focused_policy.zip |  |  |  |  |  |  | 1 | 0 | 0.125 | 0.56 | duration | hardware | mpc | configs/my_rig.json | configs/mpc_my_rig_transfer.json | 15.0
mpc_transfer_20261107_151046 | mpc_transfer | 2026-11-07 15:10 | run.json summary.json | 0 |  | 3 | 0.06 | 0.0 | docs/results/sac_focused_policy.zip |  |  |  |  |  |  | 1 | 0 | 0.321 | 3.1 | duration | hardware | mpc | configs/my_rig.json | configs/mpc_my_rig_transfer.json | 15.0
mpc_transfer_20261107_155316 | mpc_transfer | 2026-11-07 15:53 | run.json summary.json | 0 |  | 3 | 0.0 | 0.0 | docs/results/sac_focused_policy.zip |  |  |  |  |  |  | 1 | 0 |  |  | RuntimeError: Start requires a physically centered arm and still hanging pendulum | hardware | mpc | configs/my_rig.json | configs/mpc_my_rig_transfer.json | 15.0
mpc_transfer_20261107_155325 | mpc_transfer | 2026-11-07 15:53 | run.json summary.json | 0 |  | 3 | 0.06 | 0.0 | docs/results/sac_focused_policy.zip |  |  |  |  |  |  | 1 | 0 | 0.247 | 1.42 | duration | hardware | mpc | configs/my_rig.json | configs/mpc_my_rig_transfer.json | 15.0
mpc_transfer_20261107_155419 | mpc_transfer | 2026-11-07 15:54 | run.json summary.json | 0 |  | 3 | 0.06 | 0.0 | docs/results/sac_focused_policy.zip |  |  |  |  |  |  | 1 | 0 | 0.384 | 2.6 | duration | hardware | mpc | configs/my_rig.json | configs/mpc_my_rig_transfer.json | 15.0
mpc_transfer_20261107_155533 | mpc_transfer | 2026-11-07 15:55 | run.json summary.json | 0 |  | 3 | 0.06 | 0.0 | docs/results/sac_focused_policy.zip |  |  |  |  |  |  | 1 | 0 | 0.148 | 1.38 | duration | hardware | mpc | configs/my_rig.json | configs/mpc_my_rig_transfer.json | 15.0
mpc_transfer_20261107_155613 | mpc_transfer | 2026-11-07 15:56 | run.json summary.json | 0 |  | 3 | 0.06 | 0.0 | docs/results/sac_focused_policy.zip |  |  |  |  |  |  | 1 | 1 | 0.716 | 10.66 | duration | hardware | mpc | configs/my_rig.json | configs/mpc_my_rig_transfer.json | 15.0
pid_lqr_match_20261107_160634 | pid_lqr_match | 2026-11-07 16:06 | run.json summary.json | 0 |  | 3 | 0.06 | 0.0 | docs/results/sac_focused_policy.zip |  |  |  |  |  |  | 1 | 0 | 0.083 | 0.5 | duration | hardware | pid | configs/my_rig.json | configs/pid_my_rig_lqr_match.json | 15.0
pid_lqr_match_20261107_160701 | pid_lqr_match | 2026-11-07 16:07 | run.json summary.json | 0 |  | 3 | 0.06 | 0.0 | docs/results/sac_focused_policy.zip |  |  |  |  |  |  | 1 | 0 | 0.281 | 2.76 | duration | hardware | pid | configs/my_rig.json | configs/pid_my_rig_lqr_match.json | 15.0
pid_lqr_match_20261107_160734 | pid_lqr_match | 2026-11-07 16:07 | run.json summary.json | 0 |  | 3 | 0.06 | 0.0 | docs/results/sac_focused_policy.zip |  |  |  |  |  |  | 1 | 0 | 0.165 | 0.5 | duration | hardware | pid | configs/my_rig.json | configs/pid_my_rig_lqr_match.json | 15.0
pid_lqr_match_20261107_161502 | pid_lqr_match | 2026-11-07 16:15 | run.json summary.json | 0 |  | 3 | 0.06 | 0.0 | docs/results/sac_focused_policy.zip |  |  |  |  |  |  | 1 | 0 | 0.433 | 6.2 | duration | hardware | pid | configs/my_rig.json | configs/pid_my_rig_lqr_match.json | 15.0
pid_lqr_match_20261107_161536 | pid_lqr_match | 2026-11-07 16:15 | run.json summary.json | 0 |  | 3 | 0.06 | 0.0 | docs/results/sac_focused_policy.zip |  |  |  |  |  |  | 1 | 0 | 0.623 | 8.26 | duration | hardware | pid | configs/my_rig.json | configs/pid_my_rig_lqr_match.json | 15.0
pid_lqr_match_20261107_161611 | pid_lqr_match | 2026-11-07 16:16 | run.json summary.json | 0 |  | 3 | 0.06 | 0.0 | docs/results/sac_focused_policy.zip |  |  |  |  |  |  | 1 | 0 | 0.092 | 0.56 | duration | hardware | pid | configs/my_rig.json | configs/pid_my_rig_lqr_match.json | 15.0
pid_lqr_match_20261107_161650 | pid_lqr_match | 2026-11-07 16:16 | run.json summary.json | 0 |  | 3 | 0.06 | 0.0 | docs/results/sac_focused_policy.zip |  |  |  |  |  |  | 1 | 1 | 0.717 | 10.42 | duration | hardware | pid | configs/my_rig.json | configs/pid_my_rig_lqr_match.json | 15.0
pid_transfer_20261107_152516 | pid_transfer | 2026-11-07 15:25 | run.json summary.json | 0 |  | 3 | 0.06 | 0.0 | docs/results/sac_focused_policy.zip |  |  |  |  |  |  | 1 | 0 | 0.135 | 1.24 | duration | hardware | pid | configs/my_rig.json | configs/pid_my_rig_transfer.json | 15.0
ppo_20261108_211833 | ppo | 2026-11-08 21:18 | run.json summary.json | 0 |  | 3 | 0.05 | 0.0 | docs/results/rig_rl_disturbance/ppo_long/policy.zip |  |  |  |  |  |  | 1 | 0 | 0.195 | 0.44 | duration | hardware | ppo | configs/my_rig.json | configs/sac_my_rig.json | 15.0
ppo_ecB_20261109_012254 | ppo_ecB | 2026-11-09 01:22 | run.json summary.json | 0 |  | 3 | 0.05 | 0.0 | runs/curriculum/versions/ppo_ecB/policy.zip |  |  |  |  |  |  | 1 | 0 | 0.523 | 7.84 | duration | hardware | ppo | configs/my_rig.json | configs/sac_my_rig.json | 15.0
ppo_ecB_20261109_012337 | ppo_ecB | 2026-11-09 01:23 | run.json summary.json | 0 |  | 3 | 0.05 | 0.0 | runs/curriculum/versions/ppo_ecB/policy.zip |  |  |  |  |  |  | 1 | 1 | 0.901 | 13.52 | duration | hardware | ppo | configs/my_rig.json | configs/sac_my_rig.json | 15.0
ppo_ecB_20261109_012428 | ppo_ecB | 2026-11-09 01:24 | run.json summary.json | 0 |  | 3 | 0.02 | 0.0 | runs/curriculum/versions/ppo_ecB/policy.zip |  |  |  |  |  |  | 1 | 0 | 0.0 | 0.0 | KeyboardInterrupt: | hardware | ppo | configs/my_rig.json | configs/sac_my_rig.json | 15.0
ppo_ecB_20261109_012444 | ppo_ecB | 2026-11-09 01:24 | run.json summary.json | 0 |  | 3 | 0.02 | 0.0 | runs/curriculum/versions/ppo_ecB/policy.zip |  |  |  |  |  |  | 1 | 0 | 0.008 | 0.04 | KeyboardInterrupt: | hardware | ppo | configs/my_rig.json | configs/sac_my_rig.json | 15.0
ppo_ecC_20261109_012103 | ppo_ecC | 2026-11-09 01:21 | run.json summary.json | 0 |  | 3 | 0.0 | 0.0 | runs/curriculum/versions/ppo_ecC/policy.zip |  |  |  |  |  |  | 1 | 0 |  |  | SerialException: [Errno 2] could not open port /dev/ttyUSB0: [Errno 2] No such file or directory: '/dev/ttyUSB0' | hardware | ppo | configs/my_rig.json | configs/sac_my_rig.json | 15.0
ppo_ecC_20261109_012112 | ppo_ecC | 2026-11-09 01:21 | run.json summary.json | 0 |  | 3 | 0.03 | 0.0 | runs/curriculum/versions/ppo_ecC/policy.zip |  |  |  |  |  |  | 1 | 0 | 0.0 | 0.0 | KeyboardInterrupt: | hardware | ppo | configs/my_rig.json | configs/sac_my_rig.json | 15.0
ppo_ecF_20261109_013006 | ppo_ecF | 2026-11-09 01:30 | run.json summary.json | 0 |  | 3 | 0.05 | 0.0 | runs/curriculum/versions/ppo_ecF/policy.zip |  |  |  |  |  |  | 1 | 0 | 0.436 | 4.3 | duration | hardware | ppo | configs/my_rig.json | configs/sac_my_rig.json | 15.0
ppo_ecF_20261109_013045 | ppo_ecF | 2026-11-09 01:30 | run.json summary.json | 0 |  | 3 | 0.05 | 0.0 | runs/curriculum/versions/ppo_ecF/policy.zip |  |  |  |  |  |  | 1 | 0 | 0.409 | 3.84 | duration | hardware | ppo | configs/my_rig.json | configs/sac_my_rig.json | 15.0
ppo_ecG_20261109_013444 | ppo_ecG | 2026-11-09 01:34 | run.json summary.json | 0 |  | 3 | 0.05 | 0.0 | runs/curriculum/versions/ppo_ecG/policy.zip |  |  |  |  |  |  | 1 | 0 | 0.335 | 2.82 | duration | hardware | ppo | configs/my_rig.json | configs/sac_my_rig.json | 15.0
ppo_ecG_20261109_013508 | ppo_ecG | 2026-11-09 01:35 | run.json summary.json | 0 |  | 3 | 0.05 | 0.0 | runs/curriculum/versions/ppo_ecG/policy.zip |  |  |  |  |  |  | 1 | 1 | 0.876 | 13.14 | duration | hardware | ppo | configs/my_rig.json | configs/sac_my_rig.json | 15.0
ppo_long_20261109_011005 | ppo_long | 2026-11-09 01:10 | run.json summary.json | 0 |  | 3 | 0.05 | 0.0 | docs/results/rig_rl_disturbance/ppo_long/policy.zip |  |  |  |  |  |  | 1 | 1 | 0.9 | 13.5 | duration | hardware | ppo | configs/my_rig.json | configs/sac_my_rig.json | 15.0
ppo_long_20261109_011116 | ppo_long | 2026-11-09 01:11 | run.json summary.json | 0 |  | 3 | 0.05 | 0.0 | docs/results/rig_rl_disturbance/ppo_long/policy.zip |  |  |  |  |  |  | 1 | 0 | 0.015 | 0.22 | duration | hardware | ppo | configs/my_rig.json | configs/sac_my_rig.json | 15.0
ppo_long_20261109_011145 | ppo_long | 2026-11-09 01:11 | run.json summary.json | 0 |  | 3 | 0.02 | 0.0 | docs/results/rig_rl_disturbance/ppo_long/policy.zip |  |  |  |  |  |  | 1 | 0 | 0.05 | 0.24 | KeyboardInterrupt: | hardware | ppo | configs/my_rig.json | configs/sac_my_rig.json | 15.0
ppo_rig_20261107_175250 | ppo_rig | 2026-11-07 17:52 | run.json summary.json | 0 |  | 3 | 0.05 | 0.0 | docs/results/rig_rl_disturbance/ppo_long/policy.zip |  |  |  |  |  |  | 1 | 0 | 0.156 | 1.04 | duration | hardware | ppo | configs/my_rig.json | configs/sac_my_rig.json | 15.0
ppo_rn05_20261109_010852 | ppo_rn05 | 2026-11-09 01:08 | run.json summary.json | 0 |  | 3 | 0.05 | 0.0 | runs/curriculum/versions/ppo_rn05/policy.zip |  |  |  |  |  |  | 1 | 0 | 0.0 | 0.0 | duration | hardware | ppo | configs/my_rig.json | configs/sac_my_rig.json | 15.0
ppo_rn05_20261109_152704 | ppo_rn05 | 2026-11-09 15:27 | run.json summary.json | 0 |  | 3 | 0.05 | 0.0 | runs/curriculum/versions/ppo_rn05/policy.zip |  |  |  |  |  |  | 1 | 0 | 0.777 | 8.24 | duration | hardware | ppo | configs/my_rig.json | configs/sac_my_rig.json | 15.0
ppo_rn05_20261109_152854 | ppo_rn05 | 2026-11-09 15:28 | run.json summary.json | 0 |  | 3 | 0.05 | 0.0 | runs/curriculum/versions/ppo_rn05/policy.zip |  |  |  |  |  |  | 1 | 0 | 0.527 | 2.4 | duration | hardware | ppo | configs/my_rig.json | configs/sac_my_rig.json | 15.0
ppo_rn05_20261109_153025 | ppo_rn05 | 2026-11-09 15:30 | run.json summary.json | 0 |  | 3 | 0.0 | 0.0 | runs/curriculum/versions/ppo_rn05/policy.zip |  |  |  |  |  |  | 1 | 0 |  |  | RuntimeError: Start requires a physically centered arm and still hanging pendulum | hardware | ppo | configs/my_rig.json | configs/sac_my_rig.json | 15.0
ppo_rn05_20261109_153032 | ppo_rn05 | 2026-11-09 15:30 | run.json summary.json | 0 |  | 3 | 0.05 | 0.0 | runs/curriculum/versions/ppo_rn05/policy.zip |  |  |  |  |  |  | 1 | 0 | 0.316 | 2.1 | duration | hardware | ppo | configs/my_rig.json | configs/sac_my_rig.json | 15.0
ppo_rn_20261109_010227 | ppo_rn | 2026-11-09 01:02 | run.json summary.json | 0 |  | 3 | 0.05 | 0.0 | runs/curriculum/versions/ppo_rn/policy.zip |  |  |  |  |  |  | 1 | 0 | 0.067 | 0.18 | duration | hardware | ppo | configs/my_rig.json | configs/sac_my_rig.json | 15.0
report_sim_eval/seed0/dqn | report_sim_eval | 2026-11-09 10:41 (mtime) | run.json summary.json | 0 |  | 3 | 0.03 | 0.0 | docs/results/rig_rl_disturbance/dqn_rn05/policy.zip |  |  |  |  |  |  | 1 | 1 | 0.845 | 12.68 | duration | sim | dqn | configs/my_rig.json | configs/sac_my_rig.json | 15.0
report_sim_eval/seed0/ilqr | report_sim_eval | 2026-11-09 10:41 (mtime) | run.json summary.json | 0 |  | 3 | 0.03 | 0.0 | docs/results/sac_focused_policy.zip |  |  |  |  |  |  | 1 | 1 | 0.859 | 12.88 | duration | sim | ilqr | configs/my_rig.json | configs/ilqr_my_rig_lqr_match.json | 15.0
report_sim_eval/seed0/lqr | report_sim_eval | 2026-11-09 10:41 (mtime) | run.json summary.json | 0 |  | 3 | 0.03 | 0.0 | docs/results/sac_focused_policy.zip |  |  |  |  |  |  | 1 | 1 | 0.859 | 12.88 | duration | sim | lqr | configs/my_rig.json | configs/lqr_my_rig_coupling_delay.json | 15.0
report_sim_eval/seed0/mpc | report_sim_eval | 2026-11-09 10:41 (mtime) | run.json summary.json | 0 |  | 3 | 0.03 | 0.0 | docs/results/sac_focused_policy.zip |  |  |  |  |  |  | 1 | 1 | 0.859 | 12.88 | duration | sim | mpc | configs/my_rig.json | configs/mpc_my_rig_transfer.json | 15.0
report_sim_eval/seed0/pid | report_sim_eval | 2026-11-09 10:41 (mtime) | run.json summary.json | 0 |  | 3 | 0.03 | 0.0 | docs/results/sac_focused_policy.zip |  |  |  |  |  |  | 1 | 1 | 0.859 | 12.88 | duration | sim | pid | configs/my_rig.json | configs/pid_my_rig_lqr_match.json | 15.0
report_sim_eval/seed0/ppo | report_sim_eval | 2026-11-09 10:41 (mtime) | run.json summary.json | 0 |  | 3 | 0.03 | 0.0 | docs/results/rig_rl_disturbance/ppo_ecG/policy.zip |  |  |  |  |  |  | 1 | 1 | 0.88 | 13.2 | duration | sim | ppo | configs/my_rig.json | configs/sac_my_rig.json | 15.0
report_sim_eval/seed0/sac | report_sim_eval | 2026-11-09 10:41 (mtime) | run.json summary.json | 0 |  | 3 | 0.03 | 0.0 | docs/results/rig_rl_disturbance/sac_rnA_reward_only/policy.zip |  |  |  |  |  |  | 1 | 1 | 0.856 | 12.84 | duration | sim | sac | configs/my_rig.json | configs/sac_my_rig.json | 15.0
report_sim_eval/upright/ilqr | report_sim_eval | 2026-11-09 10:43 (mtime) | run.json summary.json | 0 |  | 22 | 0.63 | 0.0 | docs/results/sac_focused_policy.zip |  |  |  |  |  |  | 20 | 15 | 0.744 | 15.0 | duration | sim | ilqr | configs/my_rig.json | configs/ilqr_my_rig_lqr_match.json | 15.0
report_sim_eval/upright/lqr | report_sim_eval | 2026-11-09 10:43 (mtime) | run.json summary.json | 0 |  | 22 | 0.63 | 0.0 | docs/results/sac_focused_policy.zip |  |  |  |  |  |  | 20 | 15 | 0.744 | 15.0 | duration | sim | lqr | configs/my_rig.json | configs/lqr_my_rig_coupling_delay.json | 15.0
report_sim_eval/upright/mpc | report_sim_eval | 2026-11-09 10:43 (mtime) | run.json summary.json | 0 |  | 22 | 0.63 | 0.0 | docs/results/sac_focused_policy.zip |  |  |  |  |  |  | 20 | 15 | 0.744 | 15.0 | duration | sim | mpc | configs/my_rig.json | configs/mpc_my_rig_transfer.json | 15.0
report_sim_eval/upright/pid | report_sim_eval | 2026-11-09 10:42 (mtime) | run.json summary.json | 0 |  | 22 | 0.63 | 0.0 | docs/results/sac_focused_policy.zip |  |  |  |  |  |  | 20 | 15 | 0.744 | 15.0 | duration | sim | pid | configs/my_rig.json | configs/pid_my_rig_lqr_match.json | 15.0
rig_sac_P1alt_20261107_215321 | rig_sac_P1alt | 2026-11-07 21:53 | session.json summary.json | 0 |  | 14 | 0.88 | 0.0 | runs/sac_finetune/P1/policy.zip |  |  |  | 12 | completed |  | 12 | 2 | 0.207 | 13.2 | duration |  |  |  |  |  |  |  | 0.0001 |  |  |  |  | False
rig_sac_evalP1_20261107_212700 | rig_sac_evalP1 | 2026-11-07 21:27 | session.json summary.json | 0 |  | 5 | 0.23 | 0.0 | runs/sac_finetune/P1/policy.zip |  |  |  | 3 | completed |  | 3 | 0 | 0.186 | 2.44 | duration |  |  |  |  |  |  |  | 0.0001 |  |  |  |  | False
rig_sac_eval_20261107_212337 | rig_sac_eval | 2026-11-07 21:23 | session.json summary.json | 0 |  | 5 | 0.18 | 0.0 | runs/sac_finetune/V1/policy.zip |  |  |  | 3 | completed |  | 3 | 0 | 0.114 | 0.9 | duration |  |  |  |  |  |  |  | 0.0001 |  |  |  |  | False
rig_sac_pilot_20261107_214524 | rig_sac_pilot | 2026-11-07 21:45 | session.json summary.json | 1 | 3d7b8ad66811d502392119a03dd6a5276b0e1333c7d5dd2086b5aed59fea7dc8 | 45 | 2271.71 | 2162.06 | runs/sac_finetune/P1/policy.zip |  |  |  | 20 | completed |  | 20 | 1 | 0.315 | 12.38 | duration |  |  |  |  |  |  |  | 3e-05 |  |  |  |  | True
sac_A_20261107_171816 | sac_A | 2026-11-07 17:18 | run.json summary.json | 0 |  | 3 | 0.05 | 0.0 | runs/sac_real_starts/A/policy.zip |  |  |  |  |  |  | 1 | 0 | 0.165 | 0.4 | duration | hardware | sac | configs/my_rig.json | configs/sac_my_rig.json | 15.0
sac_A_20261107_171906 | sac_A | 2026-11-07 17:19 | run.json summary.json | 0 |  | 3 | 0.05 | 0.0 | runs/sac_real_starts/A/policy.zip |  |  |  |  |  |  | 1 | 0 | 0.165 | 0.8 | duration | hardware | sac | configs/my_rig.json | configs/sac_my_rig.json | 15.0
sac_A_20261107_171940 | sac_A | 2026-11-07 17:19 | run.json summary.json | 0 |  | 3 | 0.05 | 0.0 | runs/sac_real_starts/A/policy.zip |  |  |  |  |  |  | 1 | 0 | 0.359 | 1.8 | duration | hardware | sac | configs/my_rig.json | configs/sac_my_rig.json | 15.0
sac_D_20261107_172455 | sac_D | 2026-11-07 17:24 | run.json summary.json | 0 |  | 3 | 0.05 | 0.0 | runs/sac_real_starts/D/policy.zip |  |  |  |  |  |  | 1 | 0 | 0.053 | 0.52 | duration | hardware | sac | configs/my_rig.json | configs/sac_my_rig.json | 15.0
sac_D_20261107_172520 | sac_D | 2026-11-07 17:25 | run.json summary.json | 0 |  | 3 | 0.05 | 0.0 | runs/sac_real_starts/D/policy.zip |  |  |  |  |  |  | 1 | 0 | 0.087 | 0.24 | duration | hardware | sac | configs/my_rig.json | configs/sac_my_rig.json | 15.0
sac_D_20261107_172552 | sac_D | 2026-11-07 17:25 | run.json summary.json | 0 |  | 3 | 0.05 | 0.0 | runs/sac_real_starts/D/policy.zip |  |  |  |  |  |  | 1 | 0 | 0.064 | 0.5 | duration | hardware | sac | configs/my_rig.json | configs/sac_my_rig.json | 15.0
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
