crasni/rotary-inverted-pendulum/hardware/meshes/motor plate.stl

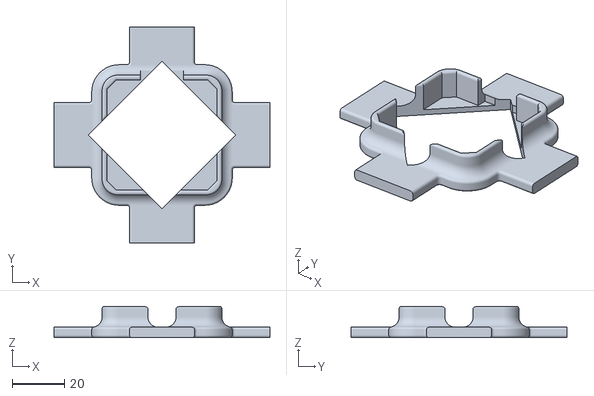
[picture p13: CAD file, 2026-11-09]
hardware/meshes/motor plate.stl
83.0 x 83.0 x 12.0
