crasni/rotary-inverted-pendulum/hardware/meshes/base.stl

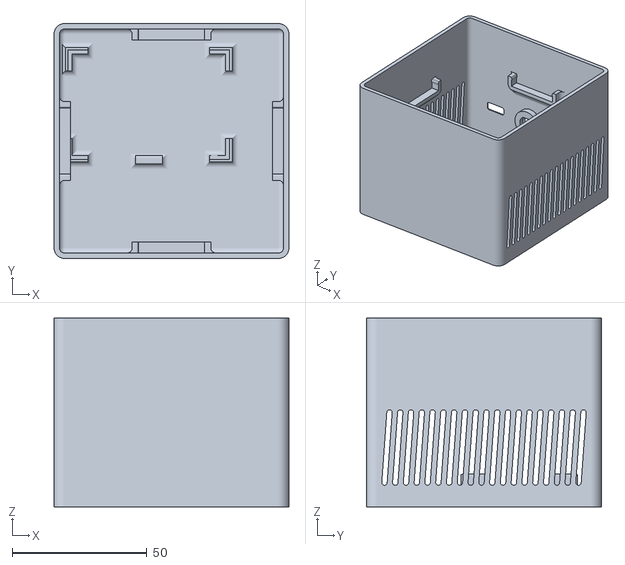
[picture p14: CAD file, 2026-11-09]
hardware/meshes/base.stl
87.2 x 87.2 x 70.0
