crasni/rotary-inverted-pendulum/hardware/meshes/arm.stl

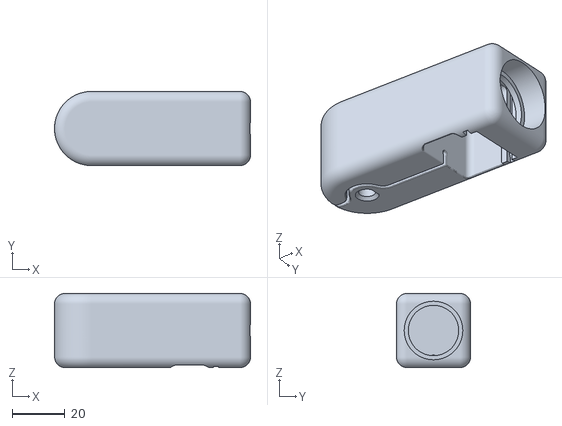
[picture p15: CAD file, 2026-11-09]
hardware/meshes/arm.stl
74.0 x 28.0 x 28.0
