crasni/rotary-inverted-pendulum/hardware/meshes/lid.stl

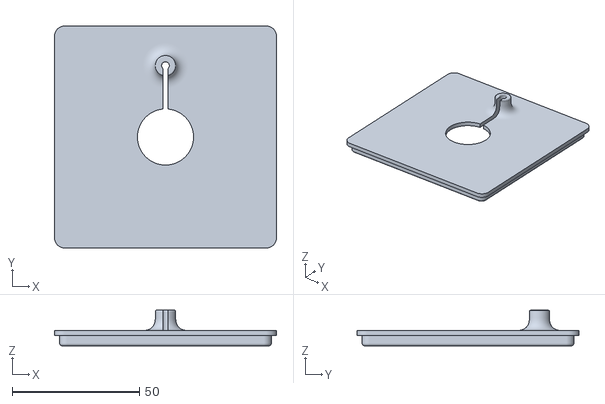
[picture p16: CAD file, 2026-11-09]
hardware/meshes/lid.stl
87.2 x 87.2 x 14.0
