crasni/rotary-inverted-pendulum/hardware/meshes/pendulum.stl

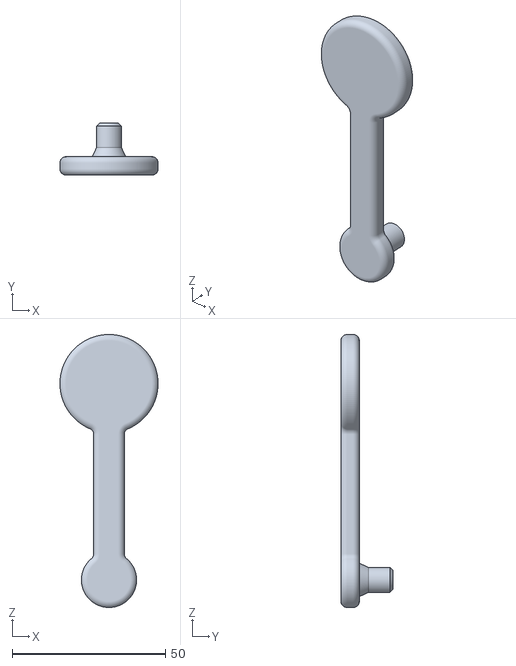
[picture p17: CAD file, 2026-11-09]
hardware/meshes/pendulum.stl
32.0 x 17.0 x 89.0
