crasni/rotary-inverted-pendulum/docs/results/sysid/driven/accel_step_sim_008/comparison.png

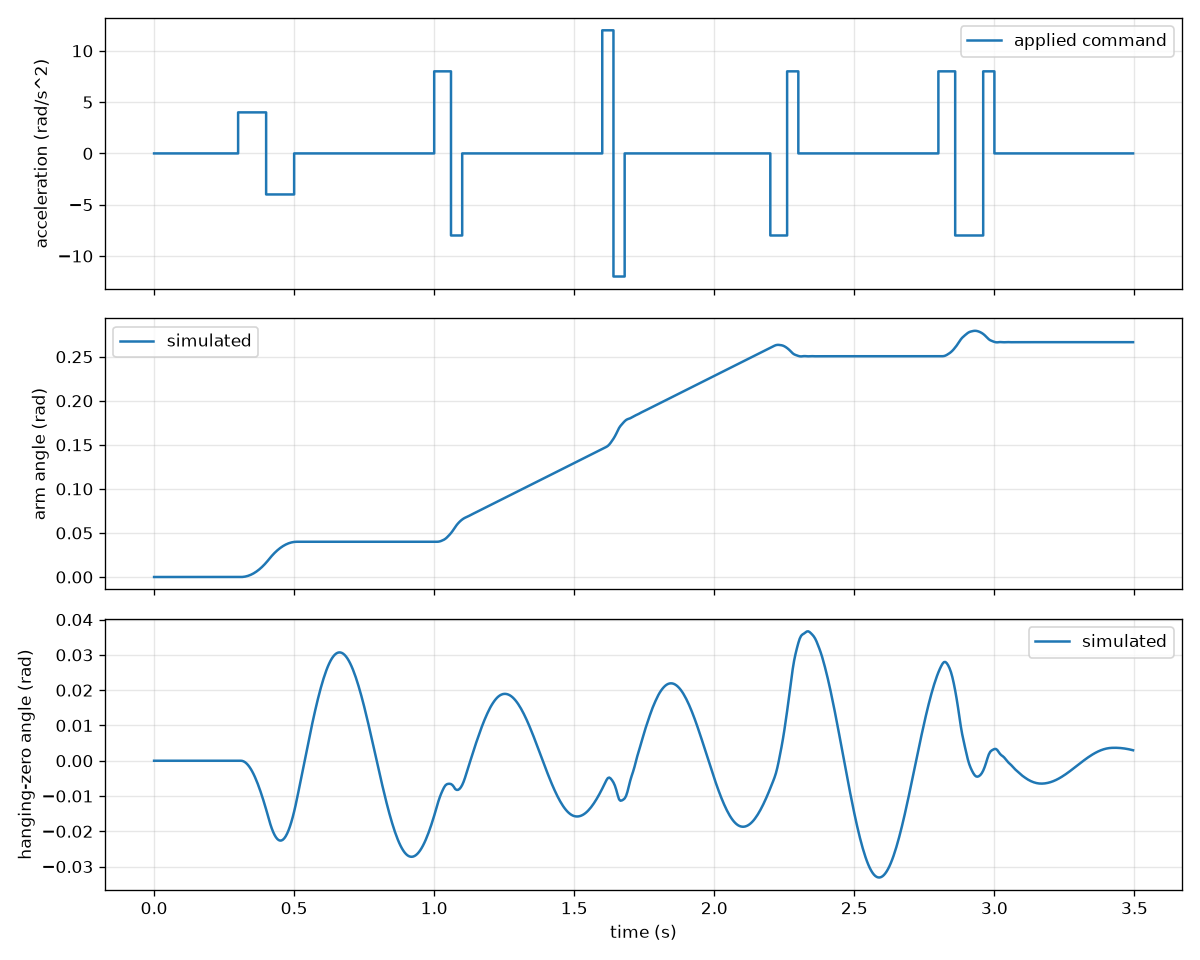
docs/results/sysid/driven/accel_step_sim_008/comparison.png
