crasni/rotary-inverted-pendulum/docs/results/sysid/earlier_session_20261106_2110/accel_step_sim/comparison.png

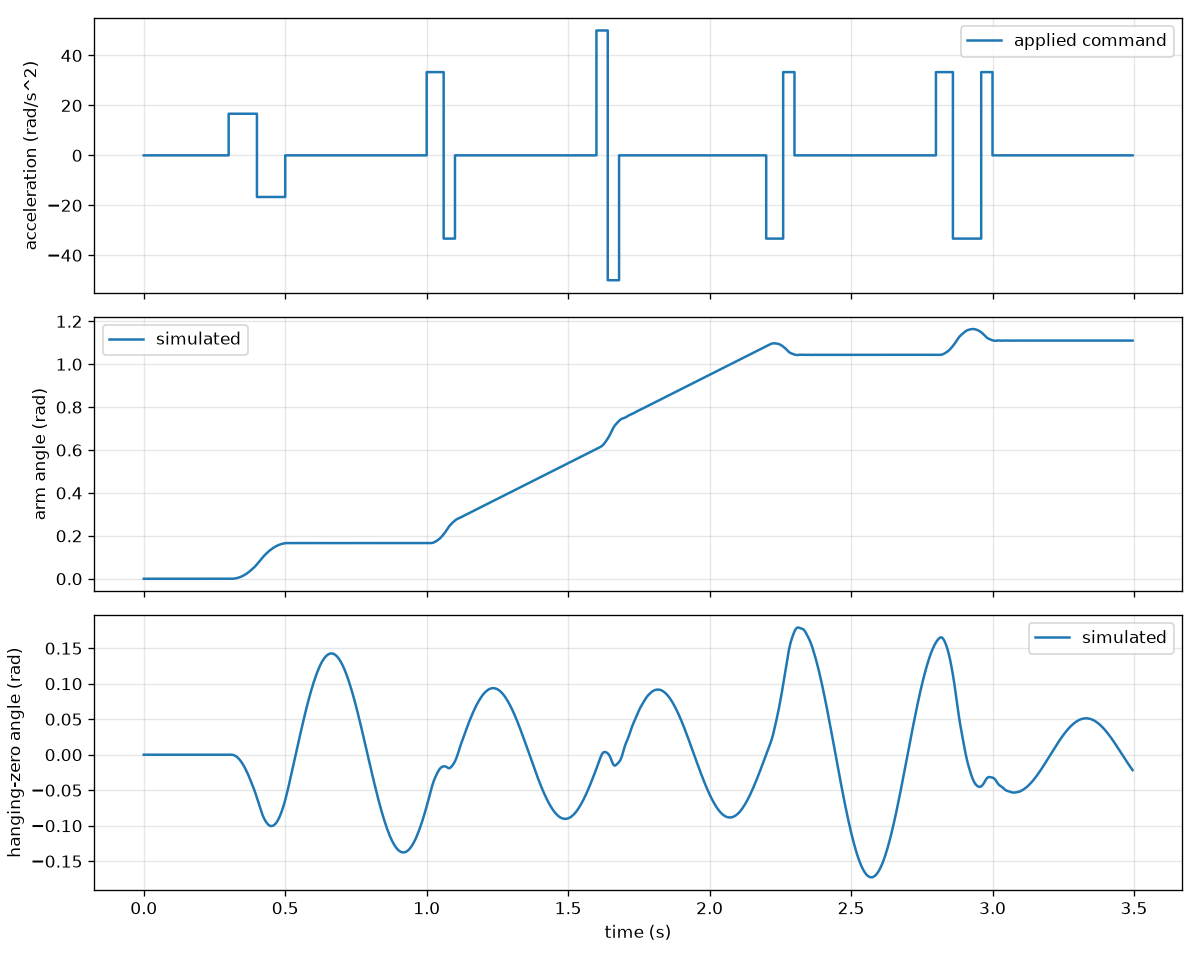
docs/results/sysid/earlier_session_20261106_2110/accel_step_sim/comparison.png
