crasni/rotary-inverted-pendulum/docs/results/hardware/commissioning/README.md

# Commissioning runs (shorter than 15 s)

Short attended hardware runs made before and between the 15 s attempts, following the
assignment's "begin with 3 seconds" rule. They cannot pass the full-task metric (which
needs a 15 s episode), so they are not counted in the per-algorithm run indexes.
Copied unchanged from the local `runs/` folder (`run.json`, `summary.json`, `episode_000.npz`).

| Run | Time | Duration | Stop | Longest hold | Max arm |
| --- | --- | ---: | --- | ---: | ---: |
| `lqr_hw_01` | 2026-11-06 21:29 | 3 s | duration | 0.00 s | 70.3° |
| `lqr_hw_02` | 2026-11-06 21:31 | 5 s | duration | 0.00 s | 67.1° |
| `lqr_hw_03` | 2026-11-06 21:34 | 5 s | duration | 2.24 s | 74.4° |
| `lqr_hw_05` | 2026-11-06 21:55 | 5 s | duration | 0.16 s | 88.3° |
| `lqr_hw_06` | 2026-11-06 23:46 | 5 s | duration | 0.02 s | 73.9° |
| `lqr_hw_07` | 2026-11-06 23:57 | 5 s | duration | 0.00 s | 29.4° |
| `lqr_hw_08` | 2026-11-06 23:58 | 8 s | duration | 0.00 s | 49.2° |
| `lqr_hw_09` | 2026-11-07 00:14 | 8 s | duration | 1.18 s | 70.8° |
| `lqr_hw_10` | 2026-11-07 00:33 | 8 s | duration | 0.08 s | 30.3° |
| `lqr_hw_11` | 2026-11-07 00:54 | 3 s | duration | 0.00 s | 48.7° |
| `lqr_hw_12` | 2026-11-07 01:24 | 3 s | duration | 0.98 s | 50.4° |
| `lqr_hw_18` | 2026-11-07 02:10 | 6 s | duration | 0.24 s | 80.3° |
| `mpc_hw_20261107_031251` | 2026-11-07 03:12 | 3 s | duration | 0.04 s | 78.9° |
