crasni/rotary-inverted-pendulum/docs/run-history/metadata/lqr_robustness_01/results.csv

algorithm | rig | mass | inertia | com | viscous | coulomb | delay_s | success | stop_reason | longest_balance_s | max_arm_deg | act_ms_mean | act_ms_max
lqr | 0 | 0.9159 | 1.011 | 0.9722 | 0.776 | 0.565 | 0.0069 | False | arm_guard | 0.0 | 100.2 | 0.01 | 0.05
lqr | 1 | 0.8574 | 0.9414 | 1.0411 | 0.5594 | 0.4183 | 0.0065 | True | duration | 11.1 | 64.9 | 0.02 | 0.11
lqr | 2 | 1.0428 | 0.9952 | 1.0411 | 0.6732 | 2.2045 | 0.0196 | False | duration | 7.38 | 64.1 | 0.01 | 0.09
lqr | 3 | 0.9222 | 1.0852 | 0.9718 | 2.1579 | 3.6868 | 0.0073 | False | duration | 0.34 | 88.6 | 0.01 | 0.1
lqr | 4 | 0.926 | 1.0381 | 1.0423 | 1.0254 | 0.9837 | 0.0069 | False | duration | 0.2 | 71.2 | 0.01 | 0.03
lqr | 5 | 1.1034 | 1.1288 | 1.081 | 0.5892 | 1.5144 | 0.028 | True | duration | 11.98 | 71.5 | 0.01 | 0.11
lqr | 6 | 1.0537 | 1.0112 | 1.0304 | 0.3714 | 0.4891 | 0.0123 | False | duration | 0.0 | 62.7 | 0.01 | 0.03
lqr | 7 | 1.1404 | 1.0471 | 1.0096 | 0.5733 | 0.2295 | 0.022 | True | duration | 10.48 | 64.8 | 0.01 | 0.11
lqr | 8 | 0.9237 | 0.9919 | 0.923 | 0.8981 | 0.5091 | 0.0098 | False | arm_guard | 0.0 | 101.0 | 0.01 | 0.03
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
