crasni/rotary-inverted-pendulum/docs/run-history/metadata/lqr_robustness_06/results.csv

algorithm | rig | mass | inertia | com | viscous | coulomb | delay_s | success | stop_reason | longest_balance_s | max_arm_deg | act_ms_mean | act_ms_max
lqr | 0 | 1.0653 | 1.1395 | 1.0042 | 0.6186 | 1.5825 | 0.0124 | False | duration | 0.0 | 47.7 | 0.02 | 0.15
lqr | 1 | 0.945 | 0.8744 | 1.0093 | 1.8926 | 0.58 | 0.0202 | True | duration | 11.64 | 47.9 | 0.01 | 0.1
lqr | 2 | 0.8798 | 1.0601 | 1.0117 | 0.9132 | 1.0422 | 0.0073 | True | duration | 12.66 | 47.5 | 0.01 | 0.09
lqr | 3 | 0.9266 | 1.1242 | 1.0903 | 0.4703 | 2.531 | 0.0055 | False | duration | 0.0 | 44.1 | 0.01 | 0.04
lqr | 4 | 1.0642 | 1.1096 | 0.9814 | 1.2629 | 1.6038 | 0.0135 | False | duration | 0.0 | 47.5 | 0.01 | 0.04
lqr | 5 | 1.0114 | 1.1217 | 1.0551 | 0.5639 | 0.2791 | 0.0153 | False | duration | 0.0 | 48.8 | 0.01 | 0.04
lqr | 6 | 0.9589 | 0.9178 | 0.9022 | 1.1074 | 0.2217 | 0.0092 | True | duration | 10.94 | 48.1 | 0.01 | 0.09
lqr | 7 | 0.985 | 1.0891 | 0.9155 | 2.8782 | 1.6263 | 0.0073 | True | duration | 11.02 | 47.5 | 0.01 | 0.08
lqr | 8 | 0.9267 | 0.9317 | 1.0946 | 0.5553 | 3.0271 | 0.0097 | True | duration | 12.9 | 43.3 | 0.01 | 0.11
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
