crasni/rotary-inverted-pendulum/docs/run-history/metadata/sysid_validation_01/free_run_1/freeswing_compare.csv

time_s | real_hanging_rad | sim_hanging_rad
0.000000000000000000e+00 | 1.943557620048522949e+00 | 1.943557620048522949e+00
9.838588999627972953e-03 | 1.935887694358825684e+00 | 1.862163595057323873e+00
2.099967999856744427e-02 | 1.923615813255310059e+00 | 1.734544983943602015e+00
3.002756800015049521e-02 | 1.900606036186218262e+00 | 1.633679384953352409e+00
4.102733699983218685e-02 | 1.863790392875671387e+00 | 1.518006015380173768e+00
4.985866599963628687e-02 | 1.814702868461608887e+00 | 1.454653268858125292e+00
5.990811099945858587e-02 | 1.750275492668151855e+00 | 1.316996742946421106e+00
7.002158599971153308e-02 | 1.670508265495300293e+00 | 1.084119444856046499e+00
7.983072099887067452e-02 | 1.578469157218933105e+00 | 9.998536601545046087e-01
8.987195000008796342e-02 | 1.469556570053100586e+00 | 8.223505862292886937e-01
1.003841739984636661e-01 | 1.346838355064392090e+00 | 5.369108361772917393e-01
1.100293799991050037e-01 | 1.208780288696289062e+00 | 3.371095755020845908e-01
1.200295029993867502e-01 | 1.059984326362609863e+00 | 1.328055819168132978e-01
1.299124849992949748e-01 | 8.912464380264282227e-01 | 2.989723182933673104e-02
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
