crasni/rotary-inverted-pendulum/docs/run-history/metadata/sysid_validation_01/free_run_2/freeswing_compare.csv

time_s | real_hanging_rad | sim_hanging_rad
0.000000000000000000e+00 | 1.771755695343017578e+00 | 1.771755695343017578e+00
1.004311299948312808e-02 | 1.759483814239501953e+00 | 1.701320675243242597e+00
2.063201999953889754e-02 | 1.739542007446289062e+00 | 1.643039226106371986e+00
3.022452799996244721e-02 | 1.708862304687500000e+00 | 1.569946982600029850e+00
4.025931599971954711e-02 | 1.665910720825195312e+00 | 1.481968204408390832e+00
5.030219799846236128e-02 | 1.607619285583496094e+00 | 1.379271102239553848e+00
6.032401199990999885e-02 | 1.538589954376220703e+00 | 1.262045620695543047e+00
7.034279899926332291e-02 | 1.454220771789550781e+00 | 1.130821817230095228e+00
8.005233599942584988e-02 | 1.357579708099365234e+00 | 9.863172747504200810e-01
9.010194199981924612e-02 | 1.244065284729003906e+00 | 8.296499751506105635e-01
1.001498249988799216e-01 | 1.115211129188537598e+00 | 6.622854592799709561e-01
1.102028859986603493e-01 | 9.710170626640319824e-01 | 4.860977978311670222e-01
1.200779539994982770e-01 | 8.145509958267211914e-01 | 3.033151381075460118e-01
1.297913990001688944e-01 | 6.764928102493286133e-01 | 2.102396163696551024e-01
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
