crasni/rotary-inverted-pendulum/docs/run-history/metadata/sysid_validation_01/free_run_3/freeswing_compare.csv

time_s | real_hanging_rad | sim_hanging_rad
0.000000000000000000e+00 | 1.771757841110229492e+00 | 1.771757841110229492e+00
1.004208099948300514e-02 | 1.761019945144653320e+00 | 1.692323824203784133e+00
2.007106800010660663e-02 | 1.738010168075561523e+00 | 1.627971207470582993e+00
3.013145399927452672e-02 | 1.701194524765014648e+00 | 1.548781078119531252e+00
4.000105099839856848e-02 | 1.649039030075073242e+00 | 1.454719010549799130e+00
5.004282199843146373e-02 | 1.583077669143676758e+00 | 1.346002650822433866e+00
6.007173799844167661e-02 | 1.503310441970825195e+00 | 1.222870305168402671e+00
7.013077199917461257e-02 | 1.408203363418579102e+00 | 1.085948856201703894e+00
8.001148999937868211e-02 | 1.297756791114807129e+00 | 9.360587093034213879e-01
9.005582600002526306e-02 | 1.170436620712280273e+00 | 7.744540537559017057e-01
1.001306779999140417e-01 | 1.030844569206237793e+00 | 6.027372740238992055e-01
1.109880499989230884e-01 | 8.774464130401611328e-01 | 4.229306512027876663e-01
1.201401409998652525e-01 | 7.071746587753295898e-01 | 2.373848555353466339e-01
1.300200779987790156e-01 | 5.246310234069824219e-01 | 4.875181635356412579e-02
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
