crasni/rotary-inverted-pendulum/docs/run-history/metadata/before_changes_20261106_211040/sysid_validation_01/free_run_1/freeswing_compare.csv

time_s | real_hanging_rad | sim_hanging_rad
0.000000000000000000e+00 | 1.672042727237567306e+00 | 1.672042727237567306e+00
1.005050299954746151e-02 | 1.665906786685809493e+00 | 1.624862087753363493e+00
2.009999300025810953e-02 | 1.653634905582293868e+00 | 1.578001104844049873e+00
3.013361400007852353e-02 | 1.630625128513202071e+00 | 1.515955769796544450e+00
4.018706199985899730e-02 | 1.596877455478534102e+00 | 1.438792884505432523e+00
5.022682399976474699e-02 | 1.550857901340350509e+00 | 1.346741073719257331e+00
6.012406999980157707e-02 | 1.492566466098651290e+00 | 1.240015904643765765e+00
7.016088599993963726e-02 | 1.417401194339618087e+00 | 1.119177320350154492e+00
8.022034599980543135e-02 | 1.328430056339129806e+00 | 9.849229573073036148e-01
9.044048600026144413e-02 | 1.222585320239886642e+00 | 8.383376009437044640e-01
1.003162309998515411e-01 | 1.099867105251178145e+00 | 6.808110183080849920e-01
1.101960629994209739e-01 | 9.633429048117250204e-01 | 5.141252831722178396e-01
1.202445219996661763e-01 | 8.114786741789430380e-01 | 3.403953693716826878e-01
1.302931609998267959e-01 | 6.504106519278138876e-01 | 1.620559584671536490e-01
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
