crasni/rotary-inverted-pendulum/docs/run-history/metadata/before_changes_20261106_211040/sysid_validation_01/free_run_2/freeswing_compare.csv

time_s | real_hanging_rad | sim_hanging_rad
0.000000000000000000e+00 | 1.972706436878070235e+00 | 1.972706436878070235e+00
1.004222799929266330e-02 | 1.966570496326312423e+00 | 1.840916032919690748e+00
2.027345199985575164e-02 | 1.954298615222796798e+00 | 1.749613415248321813e+00
3.081194500009587500e-02 | 1.935890793567523360e+00 | 1.643644944504668581e+00
4.017070699956093449e-02 | 1.903677105670794845e+00 | 1.522678134807266215e+00
5.020234499988873722e-02 | 1.862259506946429610e+00 | 1.386826068761347619e+00
6.007866099935199600e-02 | 1.807036041980609298e+00 | 1.236312214247313301e+00
7.011737199991330272e-02 | 1.736472725635394454e+00 | 1.071835039251916477e+00
7.997313899977598339e-02 | 1.652103543048724532e+00 | 9.846447411637502256e-01
9.002063699972495669e-02 | 1.553928613429889083e+00 | 7.055862675999011735e-01
1.000638069999695290e-01 | 1.441948175197467208e+00 | 5.073993819181970011e-01
1.099287719998756074e-01 | 1.313094019657000899e+00 | 4.055684446391620290e-01
1.200248719997034641e-01 | 1.168900012737140059e+00 | 9.334260748426205512e-02
1.308860119997916627e-01 | 1.006298184162005782e+00 | -1.165269170096283197e-01
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
