crasni/rotary-inverted-pendulum/docs/run-history/metadata/before_changes_20261106_211040/sysid_validation_01/free_run_3/freeswing_compare.csv

time_s | real_hanging_rad | sim_hanging_rad
0.000000000000000000e+00 | 1.670516371494159102e+00 | 1.670516371494159102e+00
1.006536099976074183e-02 | 1.664380430942401290e+00 | 1.617750225845990153e+00
2.007668100031878566e-02 | 1.655176520114764571e+00 | 1.567066248162987785e+00
2.946844500002043787e-02 | 1.641370653873309493e+00 | 1.536008267144086670e+00
3.952155400020274101e-02 | 1.619894861942157149e+00 | 1.462588965660931439e+00
4.949789800048165489e-02 | 1.587681174045428634e+00 | 1.374160628273421780e+00
5.934274399987771176e-02 | 1.544729590183123946e+00 | 1.271008389096602853e+00
6.921167600012267940e-02 | 1.489506125217303634e+00 | 1.153562253796777348e+00
7.928350099973613396e-02 | 1.418942808872088790e+00 | 1.022471593382300759e+00
8.933068799979082542e-02 | 1.331505656009539962e+00 | 8.787402273429580912e-01
9.920735500054433942e-02 | 1.228728770976886153e+00 | 7.236462930629715684e-01
1.095192310003767489e-01 | 1.109078526264056563e+00 | 5.588956338872074214e-01
1.203665049997653114e-01 | 9.740883705671876669e-01 | 2.981752380709512540e-01
1.295405880000544130e-01 | 8.237581250723451376e-01 | 2.088446866355196940e-01
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
