crasni/rotary-inverted-pendulum/docs/results/learning_curves.csv

algorithm | phase | total_steps_at_episode_end | episode_length | unscaled_episode_return | elapsed_seconds_in_phase
ppo | initial | 58 | 58 | 221.08414 | 0.847455
ppo | initial | 121 | 63 | 600.31124 | 0.864585
ppo | initial | 169 | 48 | 143.18179999999998 | 0.879668
ppo | initial | 325 | 156 | 798.6101600000001 | 0.923853
ppo | initial | 388 | 63 | 258.56167999999997 | 0.941567
ppo | initial | 439 | 51 | 187.34135999999998 | 0.955054
ppo | initial | 479 | 40 | 106.23224 | 0.96541
ppo | initial | 516 | 37 | 92.48664 | 0.975035
ppo | initial | 578 | 62 | 620.1014 | 1.000324
ppo | initial | 616 | 38 | 346.34183999999993 | 1.010867
ppo | initial | 656 | 40 | 352.84092 | 1.021581
ppo | initial | 787 | 131 | 668.1537599999999 | 1.064721
ppo | initial | 842 | 55 | 203.65178 | 1.081259
ppo | initial | 873 | 31 | 238.04452 | 1.089822
ppo | initial | 928 | 55 | 187.36488 | 1.104238
ppo | initial | 1075 | 147 | 751.2223 | 1.179489
ppo | initial | 1116 | 41 | 381.31496 | 1.193815
ppo | initial | 1188 | 72 | 999.57794 | 1.22313
ppo | initial | 1273 | 85 | 902.7352 | 1.246716
ppo | initial | 1298 | 25 | 246.63945999999999 | 1.253346
ppo | initial | 1364 | 66 | 242.48228 | 1.271063
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
