crasni/rotary-inverted-pendulum/docs/results/sysid/earlier_session_20261106_2110/sysid_train_01/freeswing_compare.csv

time_s | real_hanging_rad | sim_hanging_rad
0.000000000000000000e+00 | 1.750275607337243855e+00 | 1.750275607337243855e+00
1.003881299948261585e-02 | 1.742605681647546589e+00 | 1.678280927843761816e+00
2.008750400000280933e-02 | 1.728799815406091511e+00 | 1.617892884740327775e+00
3.015657400010240963e-02 | 1.704256053199060261e+00 | 1.542409945601661114e+00
4.017664200000581332e-02 | 1.670508380164392292e+00 | 1.451824064698421735e+00
5.006824799966125283e-02 | 1.624488826026208699e+00 | 1.346362399364594120e+00
6.015673499950935366e-02 | 1.564663405646570027e+00 | 1.226268506268147762e+00
7.015592300012940541e-02 | 1.489498133887536824e+00 | 1.092170102940712484e+00
8.022020399948814884e-02 | 1.398993010749109089e+00 | 9.448810751149936404e-01
9.010226299960777396e-02 | 1.293148155440576375e+00 | 7.856478911353728112e-01
1.001842969999415800e-01 | 1.170429940451867878e+00 | 6.160634489332975638e-01
1.101863610001601046e-01 | 1.030837888945825398e+00 | 4.381426869388114764e-01
1.200561770001513651e-01 | 8.759058668510988355e-01 | 2.542366285125846614e-01
1.301709119998122333e-01 | 7.087020828621461987e-01 | 6.700452812558259363e-02
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
