crasni/rotary-inverted-pendulum/docs/results/sysid/sysid_train_01/freeswing_compare.csv

time_s | real_hanging_rad | sim_hanging_rad
0.000000000000000000e+00 | 1.665907025337219238e+00 | 1.665907025337219238e+00
9.819847000471781939e-03 | 1.670508980751037598e+00 | 1.643067687278892963e+00
1.986732200020924211e-02 | 1.676644921302795410e+00 | 1.608704069591140762e+00
2.991027800089796074e-02 | 1.682780861854553223e+00 | 1.560075483548057917e+00
3.978545900099561550e-02 | 1.688916802406311035e+00 | 1.496600305291814648e+00
4.983170000014069956e-02 | 1.695052742958068848e+00 | 1.418289008695955644e+00
6.043164300172065850e-02 | 1.698120713233947754e+00 | 1.273428062500509883e+00
7.016730200120946392e-02 | 1.699654698371887207e+00 | 1.159133674837686367e+00
8.175602100163814612e-02 | 1.699654698371887207e+00 | 1.031341375856763554e+00
9.053133600173168816e-02 | 1.696586728096008301e+00 | 8.909833063277511345e-01
1.001161120002507232e-01 | 1.693518757820129395e+00 | 7.392886293327125546e-01
1.101647780014900491e-01 | 1.687382817268371582e+00 | 5.778480369098364378e-01
1.201952610008447664e-01 | 1.682780861854553223e+00 | 4.085947902579850632e-01
1.304173640000954038e-01 | 1.676644921302795410e+00 | 2.337837650385830579e-01
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
