crasni/rotary-inverted-pendulum/docs/results/gpu_learning_curves.png

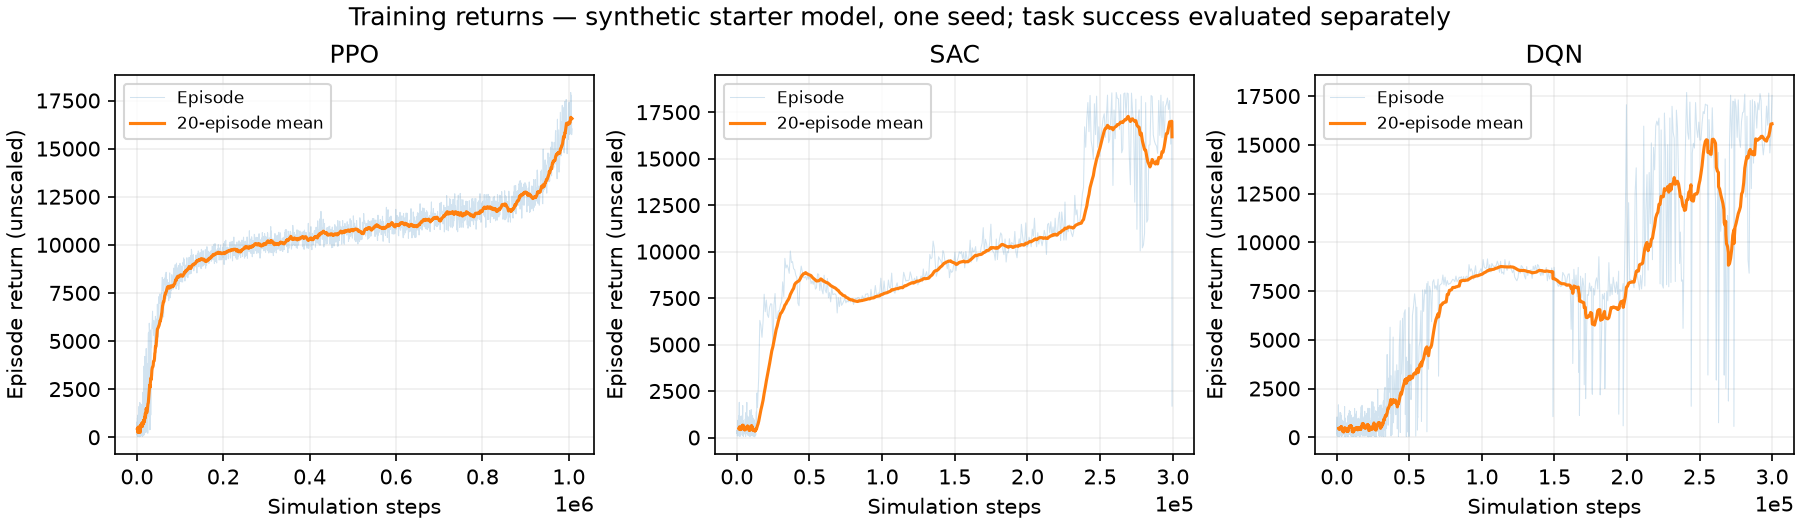
docs/results/gpu_learning_curves.png
