crasni/rotary-inverted-pendulum/docs/results/sysid/driven/accel_chirp_sim_003/comparison.png

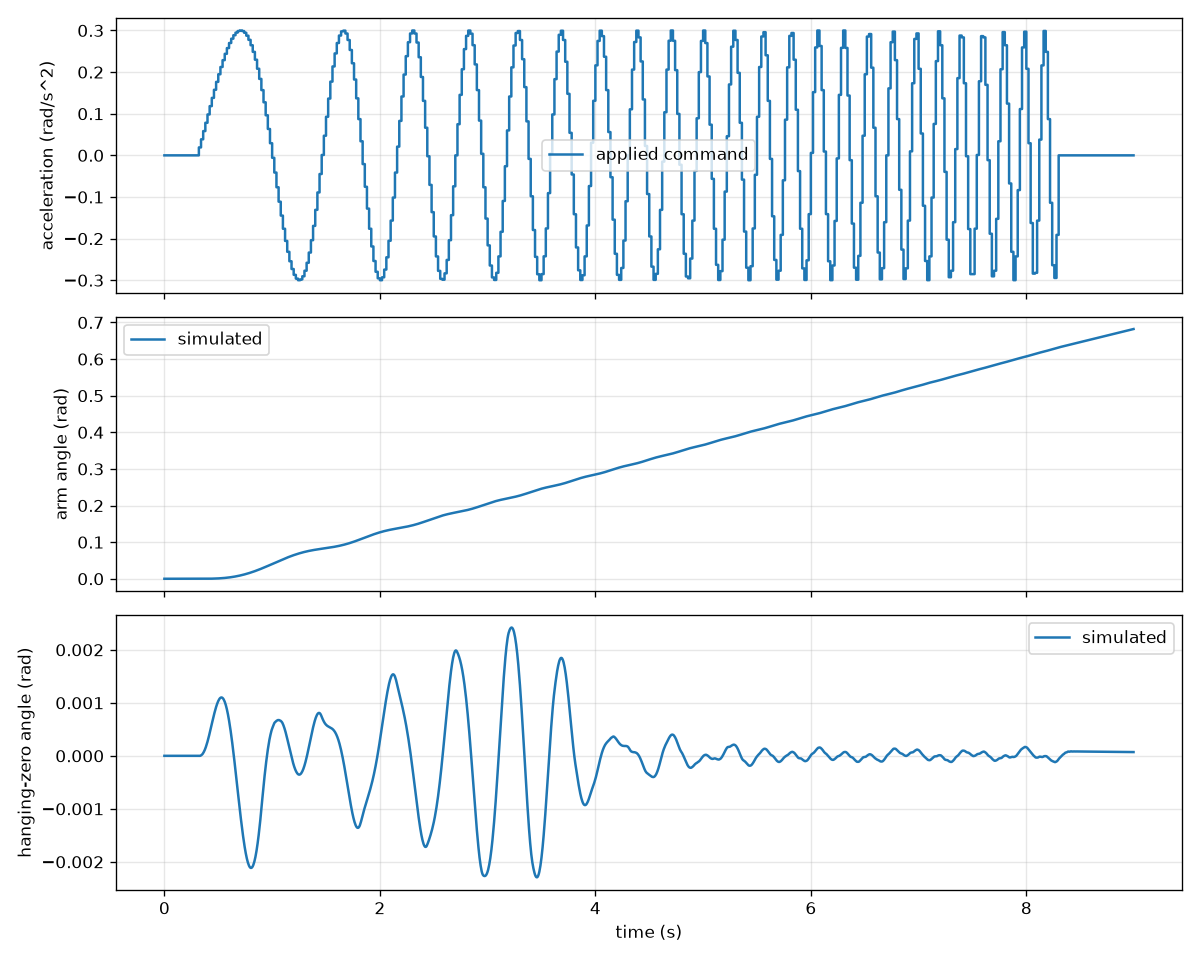
docs/results/sysid/driven/accel_chirp_sim_003/comparison.png
