crasni/rotary-inverted-pendulum/docs/results/sysid/earlier_session_20261106_2110/accel_chirp_real_002/comparison.png

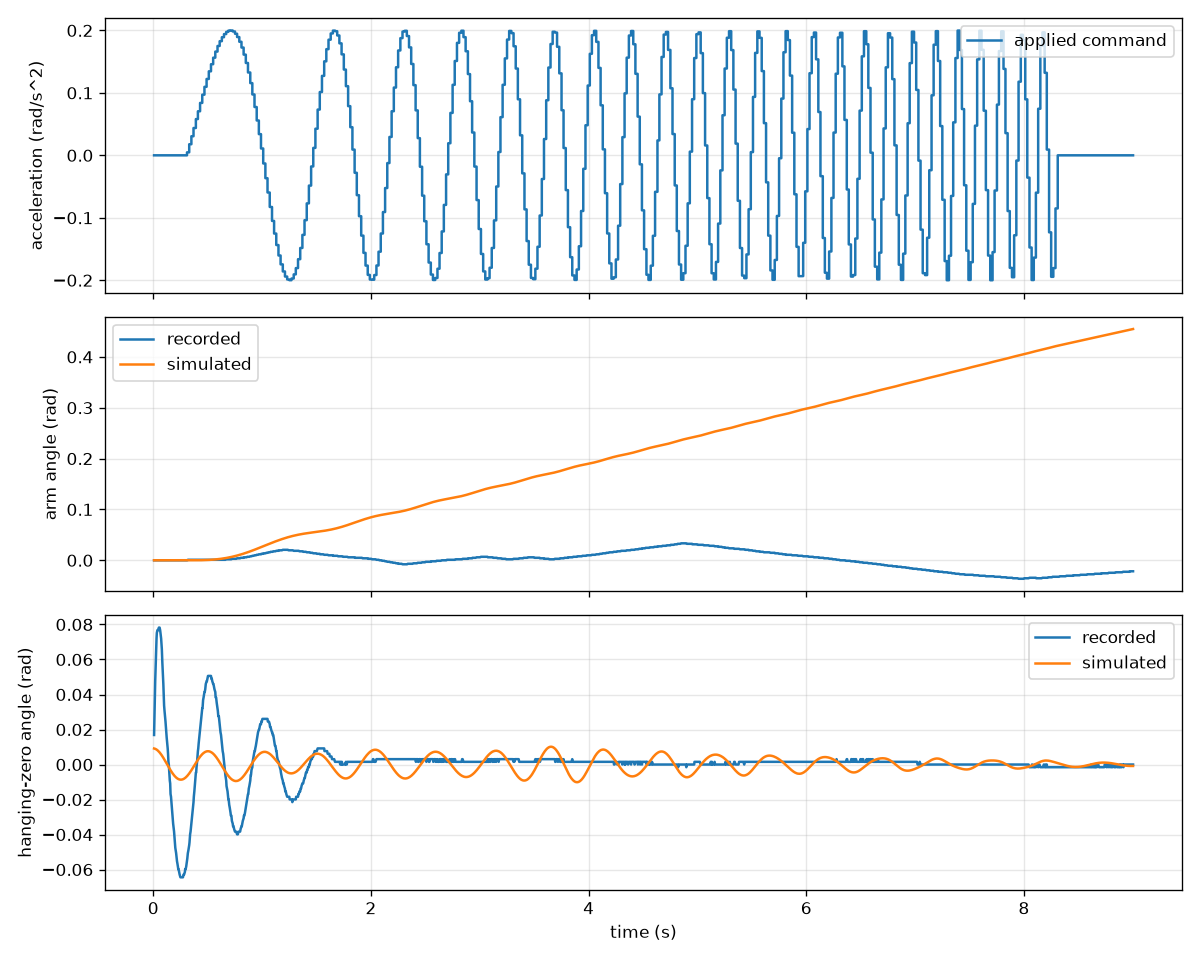
docs/results/sysid/earlier_session_20261106_2110/accel_chirp_real_002/comparison.png
