crasni/rotary-inverted-pendulum/docs/results/sysid/earlier_session_20261106_2110/sysid_train_01/freeswing_compare.png

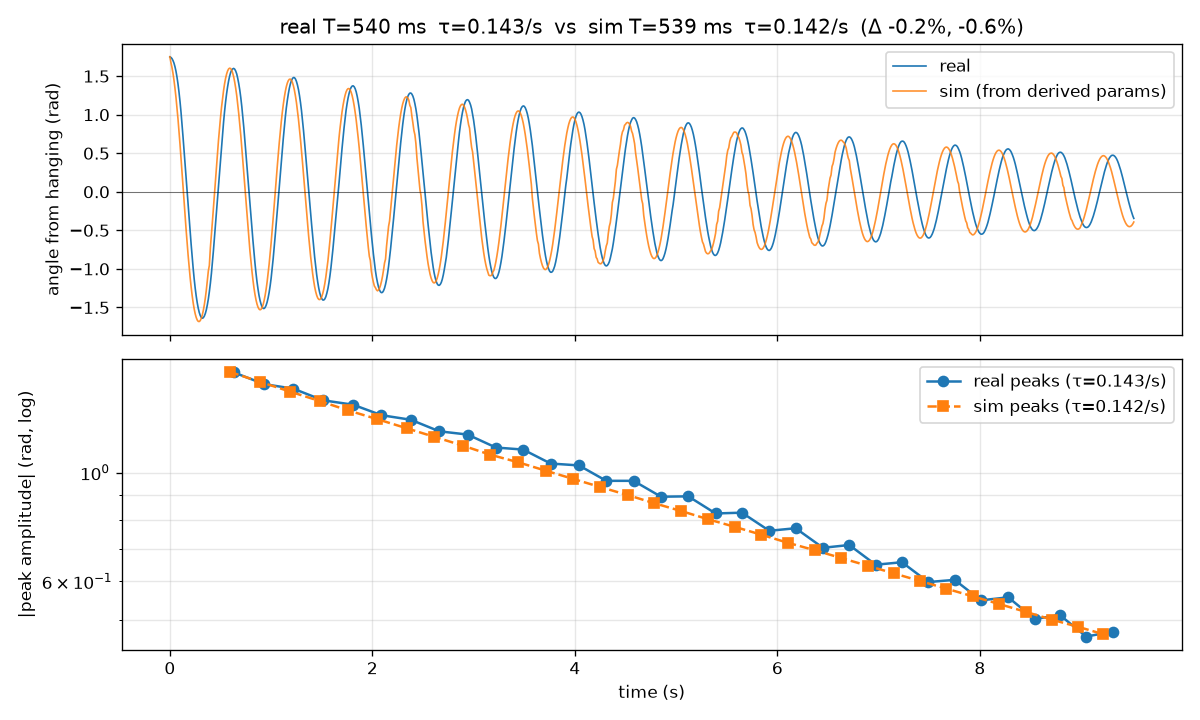
docs/results/sysid/earlier_session_20261106_2110/sysid_train_01/freeswing_compare.png
