crasni/rotary-inverted-pendulum/docs/results/sysid/earlier_session_20261106_2110/sysid_validation_01/free_run_2/freeswing_compare.png

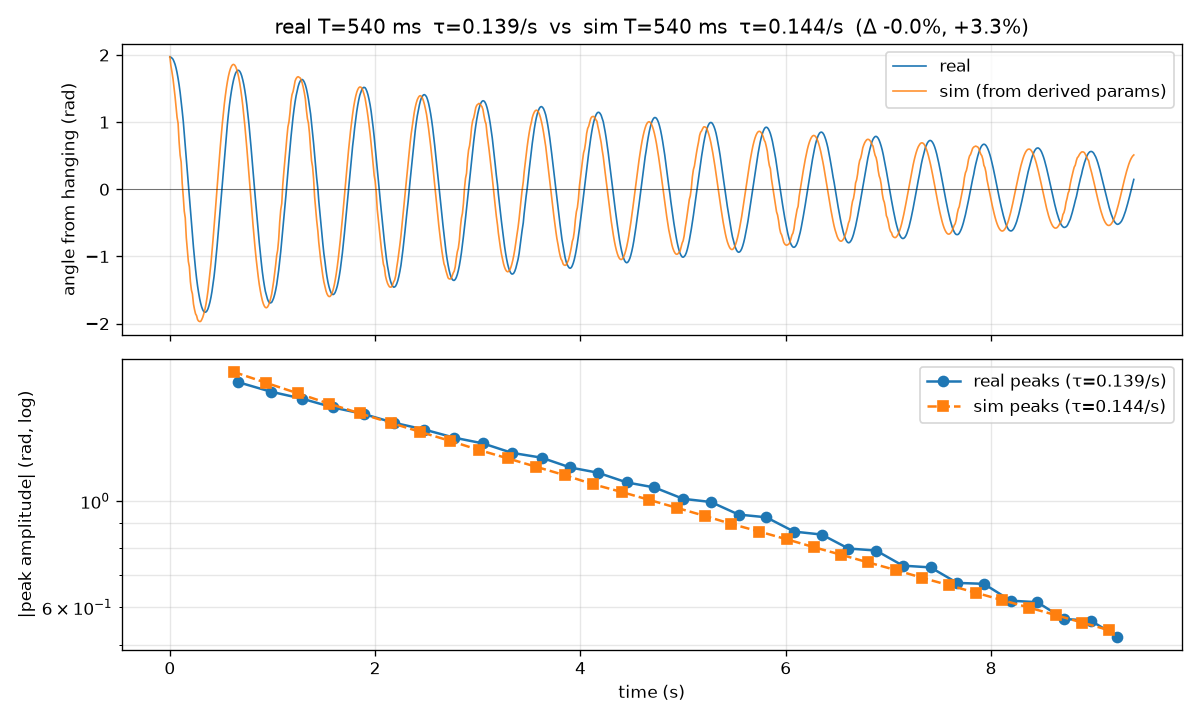
docs/results/sysid/earlier_session_20261106_2110/sysid_validation_01/free_run_2/freeswing_compare.png
