crasni/rotary-inverted-pendulum/docs/results/sysid/sysid_train_01/freeswing_compare.png

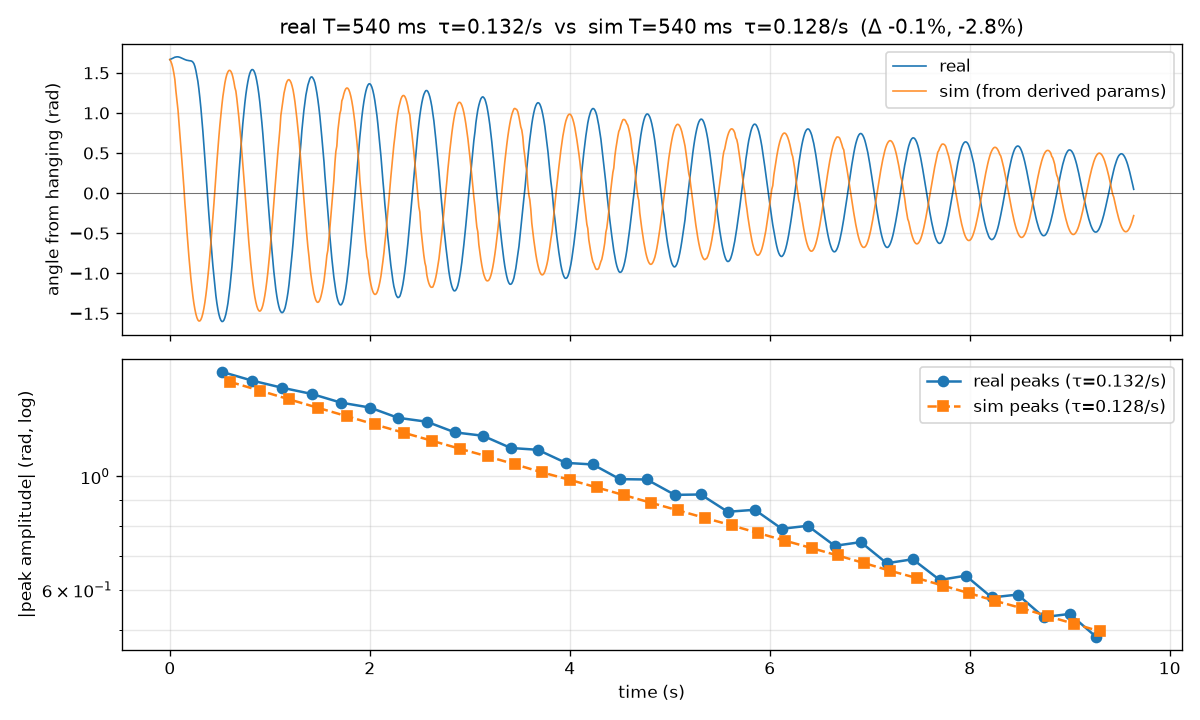
docs/results/sysid/sysid_train_01/freeswing_compare.png
