crasni/rotary-inverted-pendulum/docs/run-history/runs_index.md

# runs/ inventory

Generated 2026-11-10 01:15 by `scripts/inventory_runs.py` before pruning.
3863 files, 9.03 GB total; 8.45 GB marked prunable (`checkpoints/` dirs and `*.pkl`). 543 run directories. 1423 small text files copied verbatim to `metadata/`.

Full columns (method, seeds, learning rates, policy hashes…) are in `runs_index.csv`; every file that existed, with sha256 of deleted ones, is in `file_manifest.csv`.

## accel_chirp_real (1)

| run | when |
|---|---|
| accel_chirp_real_003 | 2026-11-06 21:21 (mtime) |

## accel_chirp_sim (1)

| run | when |
|---|---|
| accel_chirp_sim_003 | 2026-11-06 21:18 (mtime) |

## accel_reversal_1 (1)

| run | when |
|---|---|
| accel_reversal_1 | 2026-11-07 20:17 (mtime) |

## accel_reversal_2 (1)

| run | when |
|---|---|
| accel_reversal_2 | 2026-11-07 20:17 (mtime) |

## accel_reversal_sim (1)

| run | when |
|---|---|
| accel_reversal_sim | 2026-11-07 20:15 (mtime) |

## accel_step_full_1 (1)

| run | when |
|---|---|
| accel_step_full_1 | 2026-11-07 20:12 (mtime) |

## accel_step_real (1)

| run | when |
|---|---|
| accel_step_real_008 | 2026-11-06 21:18 (mtime) |

## accel_step_sim (1)

| run | when |
|---|---|
| accel_step_sim_008 | 2026-11-06 21:17 (mtime) |

## archive (32)

| run | when | algorithm | config | checkpoint | stage | episodes | mean_balanced_frac | best_longest_balance_s |
|---|---|---|---|---|---|---|---|---|
| archive/lqr_hw_17 | 2026-11-07 02:04 (mtime) | lqr | configs/lqr_my_rig_observed.json | results/sac_focused_policy.zip |  | 1 | 0.143 | 0.32 |
| archive/lqr_swing_20261107_025003 | 2026-11-07 02:50 | lqr | configs/lqr_my_rig_swing.json | results/sac_focused_policy.zip |  | 1 | 0.11 | 1.0 |
| archive/custom_lqrdither_20261107_204719 | 2026-11-07 20:47 | custom | configs/custom_lqr_dither_10.json | results/sac_focused_policy.zip |  | 1 |  |  |
| archive/custom_lqrdither_20261107_205245 | 2026-11-07 20:52 | custom | configs/custom_lqr_dither_10.json | results/sac_focused_policy.zip |  | 1 |  |  |
| archive/sac_W2_20261107_205411 | 2026-11-07 20:54 | sac | configs/sac_my_rig.json | sac_finetune/W_rig/W2_100k.zip |  | 1 |  |  |
| archive/curriculum/e03_v2_lqrbalance_det | 2026-11-07 23:32 (mtime) |  |  | curriculum/versions/v2/policy.zip | lqr_balance |  |  |  |
| archive/curriculum/e03b_v2_lqrbalance_det | 2026-11-07 23:34 (mtime) |  |  | curriculum/versions/v2/policy.zip | lqr_balance |  |  |  |
| archive/curriculum/e03c_v2_lqrbalance_det | 2026-11-07 23:57 (mtime) |  |  | curriculum/versions/v2/policy.zip | lqr_balance |  |  |  |
| archive/lqr_coupling_delay_20261108_000207 | 2026-11-08 00:02 | lqr | configs/lqr_my_rig_coupling_delay.json | results/sac_focused_policy.zip |  | 1 | 0.34 | 1.08 |
| archive/lqr_coupling_delay_20261108_000854 | 2026-11-08 00:08 | lqr | configs/lqr_my_rig_coupling_delay.json | results/sac_focused_policy.zip |  | 1 |  |  |
| archive/lqr_coupling_delay_20261108_000913 | 2026-11-08 00:09 | lqr | configs/lqr_my_rig_coupling_delay.json | results/sac_focused_policy.zip |  | 1 | 0.262 | 0.74 |
| archive/lqr_coupling_delay_20261108_000928 | 2026-11-08 00:09 | lqr | configs/lqr_my_rig_coupling_delay.json | results/sac_focused_policy.zip |  | 1 | 0.173 | 0.44 |
| archive/lqr_coupling_delay_20261108_000953 | 2026-11-08 00:09 | lqr | configs/lqr_my_rig_coupling_delay.json | results/sac_focused_policy.zip |  | 1 | 0.006 | 0.02 |
| archive/lqr_coupling_delay_20261108_001013 | 2026-11-08 00:10 | lqr | configs/lqr_my_rig_coupling_delay.json | results/sac_focused_policy.zip |  | 1 | 0.072 | 0.14 |
| archive/lqr_coupling_delay_20261108_001032 | 2026-11-08 00:10 | lqr | configs/lqr_my_rig_coupling_delay.json | results/sac_focused_policy.zip |  | 1 | 0.025 | 0.06 |
| archive/lqr_coupling_delay_20261108_001527 | 2026-11-08 00:15 | lqr | configs/lqr_my_rig_coupling_delay.json | results/sac_focused_policy.zip |  | 1 | 0.0 | 0.0 |
| archive/lqr_coupling_delay_20261108_001543. | 2026-11-08 00:15 | lqr | configs/lqr_my_rig_coupling_delay.json | results/sac_focused_policy.zip |  | 1 | 0.025 | 0.06 |
| archive/lqr_coupling_delay_20261108_001600 | 2026-11-08 00:16 | lqr | configs/lqr_my_rig_coupling_delay.json | results/sac_focused_policy.zip |  | 1 |  |  |
| archive/lqr_coupling_delay_20261108_001608 | 2026-11-08 00:16 | lqr | configs/lqr_my_rig_coupling_delay.json | results/sac_focused_policy.zip |  | 1 | 0.0 | 0.0 |
| archive/lqr_coupling_delay_20261108_025531 | 2026-11-08 02:55 | lqr | configs/lqr_my_rig_coupling_delay.json | results/sac_focused_policy.zip |  | 1 |  |  |
| archive/lqr_coupling_delay_20261108_025545 | 2026-11-08 02:55 | lqr | configs/lqr_my_rig_coupling_delay.json | results/sac_focused_policy.zip |  | 1 |  |  |
| archive/lqr_coupling_delay_20261108_025813 | 2026-11-08 02:58 | lqr | configs/lqr_my_rig_coupling_delay.json | results/sac_focused_policy.zip |  | 1 | 0.019 | 0.08 |
| archive/lqr_coupling_delay_20261108_025945 | 2026-11-08 02:59 | lqr | configs/lqr_my_rig_coupling_delay.json | results/sac_focused_policy.zip |  | 1 |  |  |
| archive/sac_v2m2_20261108_031006 | 2026-11-08 03:10 | sac | configs/sac_my_rig.json | curriculum/versions/v2m2/policy.zip |  |  |  |  |
| archive/sac_v2m2_20261108_031340 | 2026-11-08 03:13 | sac | configs/sac_my_rig.json | curriculum/versions/v2m2_runner/policy.zip |  | 1 |  |  |
| archive/sac_v2m2_20261108_031741 | 2026-11-08 03:17 | sac | configs/sac_my_rig.json | curriculum/versions/v2m2/policy.zip |  |  |  |  |
| archive/sac_v2m2_20261108_031758 | 2026-11-08 03:17 | sac | configs/sac_my_rig.json | curriculum/versions/v2m2_runner/policy.zip |  | 1 |  |  |
| archive/sac_v2m2_20261108_031911 | 2026-11-08 03:19 | sac | configs/sac_my_rig.json | curriculum/versions/v2m2_runner/policy.zip |  | 1 | 0.0 | 0.0 |
| archive/sac_v2m2_20261108_031931 | 2026-11-08 03:19 | sac | configs/sac_my_rig.json | curriculum/versions/v2m2_runner/policy.zip |  | 1 |  |  |
| archive/sac_v2m2_20261108_032213 | 2026-11-08 03:22 | sac | configs/sac_my_rig.json | curriculum/versions/v2m2/policy.zip |  |  |  |  |
| archive/sac_v6b_20261108_041929 | 2026-11-08 04:19 | sac | configs/sac_my_rig.json | curriculum/versions/v6b_runner/policy.zip |  |  |  |  |
| archive/sac_v6b_20261108_041936 | 2026-11-08 04:19 | sac | configs/sac_my_rig.json | curriculum/versions/v6b_runner/policy.zip |  |  |  |  |

## before_changes (8)

| run | when |
|---|---|
| before_changes_20261106_211040/accel_chirp_real_002 | 2026-11-06 21:10 |
| before_changes_20261106_211040/accel_chirp_sim_002 | 2026-11-06 21:10 |
| before_changes_20261106_211040/accel_step_real | 2026-11-06 21:10 |
| before_changes_20261106_211040/accel_step_real_008 | 2026-11-06 21:10 |
| before_changes_20261106_211040/accel_step_sim | 2026-11-06 21:10 |
| before_changes_20261106_211040/accel_step_sim_008 | 2026-11-06 21:10 |
| before_changes_20261106_211040/sysid_holdout_01 | 2026-11-06 21:10 |
| before_changes_20261106_211040/sysid_train_01 | 2026-11-06 21:10 |

## curriculum/batches (52)

| run | when | checkpoint | stage | episodes | successes | mean_balanced_frac | best_longest_balance_s | has_policy | mb_pruned |
|---|---|---|---|---|---|---|---|---|---|
| curriculum/b00_v1_balance_det | 2026-11-07 22:33 (mtime) | sac_finetune/V1/policy.zip | balance | 3 | 0 |  | 0.0 | 0 | 0.0 |
| curriculum/b02_v1_lqrbalance_det | 2026-11-07 22:47 (mtime) | sac_finetune/V1/policy.zip | lqr_balance | 4 | 0 | 0.186 | 1.42 | 0 | 0.0 |
| curriculum/b03_v1_lqrbalance_train | 2026-11-07 22:52 (mtime) | sac_finetune/V1/policy.zip | lqr_balance | 5 | 0 | 0.39 | 2.86 | 0 | 0.0 |
| curriculum/b04_v1_lqrbalance_train | 2026-11-07 22:58 (mtime) | sac_finetune/V1/policy.zip | lqr_balance | 10 | 0 | 0.274 | 2.76 | 0 | 0.0 |
| curriculum/e01_v1_lqrbalance_det | 2026-11-07 23:02 (mtime) | curriculum/versions/v1/policy.zip | lqr_balance | 4 | 0 | 0.094 | 1.04 | 0 | 0.0 |
| curriculum/e02_v1_hanging_det | 2026-11-07 23:04 (mtime) | curriculum/versions/v1/policy.zip | hanging | 4 | 0 | 0.009 | 0.3 | 0 | 0.0 |
| curriculum/b05_v1_lqrbalance_train | 2026-11-07 23:16 (mtime) | sac_finetune/V1/policy.zip | lqr_balance | 16 | 0 | 0.342 | 0.64 | 0 | 0.0 |
| curriculum/e04_v2_lqrbalance_det | 2026-11-08 03:02 (mtime) | curriculum/versions/v2/policy.zip | lqr_balance | 4 | 0 | 0.43 | 0.74 | 0 | 0.0 |
| curriculum/e05_v2m2_lqrbalance_det | 2026-11-08 03:06 (mtime) | curriculum/versions/v2m2/policy.zip | lqr_balance | 4 | 0 | 1.0 | 6.0 | 0 | 0.0 |
| curriculum/e06_v2m2_hanging_det | 2026-11-08 03:09 (mtime) | curriculum/versions/v2m2/policy.zip | hanging | 4 | 0 | 0.53 | 13.32 | 0 | 0.0 |
| curriculum/e06_v2m2_hanging_det_2 | 2026-11-08 03:27 (mtime) | curriculum/versions/v2m2/policy.zip | hanging | 4 | 0 | 0.212 | 3.72 | 0 | 0.0 |
| curriculum/b06_v2m2_hanging_train | 2026-11-08 03:31 (mtime) | curriculum/versions/v2m2/policy.zip | hanging | 10 | 0 | 0.236 | 2.66 | 0 | 0.0 |
| curriculum/e07_v3_hanging_det | 2026-11-08 03:35 (mtime) | curriculum/versions/v3/policy.zip | hanging | 4 | 0 | 0.174 | 5.18 | 0 | 0.0 |
| curriculum/e08_v3b_hanging_det | 2026-11-08 03:39 (mtime) | curriculum/versions/v3b/policy.zip | hanging | 4 | 0 | 0.458 | 8.96 | 0 | 0.0 |
| curriculum/e08_v3b_hanging_det_2 | 2026-11-08 03:44 (mtime) | curriculum/versions/v3b/policy.zip | hanging | 4 | 0 | 0.16 | 2.46 | 0 | 0.0 |
| curriculum/b07_v3b_hanging_train | 2026-11-08 03:51 (mtime) | curriculum/versions/v3b/policy.zip | hanging | 10 | 0 | 0.377 | 10.28 | 0 | 0.0 |
| curriculum/b08_v3b_hanging_train | 2026-11-08 04:06 (mtime) | curriculum/versions/v3b/policy.zip | hanging | 10 | 0 | 0.251 | 5.9 | 0 | 0.0 |
| curriculum/e09_v5_hanging_det | 2026-11-08 04:08 (mtime) | curriculum/versions/v5/policy.zip | hanging | 4 | 0 | 0.0 | 0.0 | 0 | 0.0 |
| curriculum/e10_v6b_hanging_det | 2026-11-08 04:18 (mtime) | curriculum/versions/v6b/policy.zip | hanging | 4 | 1 | 0.357 | 12.0 | 0 | 0.0 |
| curriculum/e11_v7_hanging_det | 2026-11-08 04:27 (mtime) | curriculum/versions/v7/policy.zip | hanging | 4 | 0 | 0.254 | 9.22 | 0 | 0.0 |
| curriculum/e12_v7_hanging_det_r1 | 2026-11-08 20:38 (mtime) | curriculum/versions/v7/policy.zip | hanging |  |  |  |  | 0 | 0.0 |
| curriculum/e12_v8_hanging_det_r1 | 2026-11-08 20:46 (mtime) | curriculum/versions/v8/policy.zip | hanging | 4 | 0 | 0.221 | 1.54 | 0 | 0.0 |
| curriculum/e12_v7_hanging_det_r1b | 2026-11-08 20:49 (mtime) | curriculum/versions/v7/policy.zip | hanging | 4 | 0 | 0.326 | 5.24 | 0 | 0.0 |
| curriculum/e13_v9_hanging_det_r1 | 2026-11-08 20:57 (mtime) | curriculum/versions/v9/policy.zip | hanging | 4 | 0 | 0.215 | 2.48 | 0 | 0.0 |
| curriculum/e13_v7_hanging_det_r1 | 2026-11-08 20:58 (mtime) | curriculum/versions/v7/policy.zip | hanging | 4 | 0 | 0.216 | 4.48 | 0 | 0.0 |
| curriculum/e13_v9_hanging_det_r2 | 2026-11-08 21:00 (mtime) | curriculum/versions/v9/policy.zip | hanging | 4 | 0 | 0.269 | 4.16 | 0 | 0.0 |
| curriculum/e13_v7_hanging_det_r2 | 2026-11-08 21:01 (mtime) | curriculum/versions/v7/policy.zip | hanging | 4 | 0 | 0.251 | 4.78 | 0 | 0.0 |
| curriculum/e13_v9_hanging_det_r3 | 2026-11-08 21:02 (mtime) | curriculum/versions/v9/policy.zip | hanging | 4 | 0 | 0.194 | 3.52 | 0 | 0.0 |
| curriculum/e13_v7_hanging_det_r3 | 2026-11-08 21:04 (mtime) | curriculum/versions/v7/policy.zip | hanging | 4 | 0 | 0.137 | 1.58 | 0 | 0.0 |
| curriculum/b09_v9_hanging_train | 2026-11-08 21:07 (mtime) | curriculum/versions/v9/policy.zip | hanging | 10 | 0 | 0.12 | 3.1 | 0 | 0.0 |
| curriculum/s01_v6b_online | 2026-11-08 22:38 (mtime) | curriculum/versions/v6b_runner/policy.zip | online | 60 | 1 | 0.625 | 10.9 | 1 | 5839.86 |
| curriculum/e14_s01e15_hanging_det | 2026-11-08 22:53 (mtime) | curriculum/versions/s01e15/policy.zip | hanging | 4 | 0 | 0.399 | 7.72 | 0 | 0.0 |
| curriculum/e14_s01e17_hanging_det | 2026-11-08 22:54 (mtime) | curriculum/versions/s01e17/policy.zip | hanging | 4 | 0 | 0.19 | 4.02 | 0 | 0.0 |
| curriculum/e15_s01e49_hanging_det_r1 | 2026-11-08 22:57 (mtime) | curriculum/versions/s01e49/policy.zip | hanging | 4 | 0 | 0.326 | 8.88 | 0 | 0.0 |
| curriculum/e15_v6b_runner_hanging_det_r1 | 2026-11-08 22:58 (mtime) | curriculum/versions/v6b_runner/policy.zip | hanging |  |  |  |  | 0 | 0.0 |
| curriculum/e15_v3b_runner_hanging_det_r1 | 2026-11-08 22:59 (mtime) | curriculum/versions/v3b_runner/policy.zip | hanging | 4 | 0 | 0.219 | 5.76 | 0 | 0.0 |
| curriculum/e15_s01e49_hanging_det_r2 | 2026-11-08 23:00 (mtime) | curriculum/versions/s01e49/policy.zip | hanging | 4 | 0 | 0.337 | 7.8 | 0 | 0.0 |
| curriculum/e15_v6b_runner_hanging_det_r2 | 2026-11-08 23:02 (mtime) | curriculum/versions/v6b_runner/policy.zip | hanging | 4 | 0 | 0.086 | 0.66 | 0 | 0.0 |
| curriculum/e15_v3b_runner_hanging_det_r2 | 2026-11-08 23:03 (mtime) | curriculum/versions/v3b_runner/policy.zip | hanging | 4 | 0 | 0.214 | 3.32 | 0 | 0.0 |
| curriculum/e15_s01e49_hanging_det_r3 | 2026-11-08 23:04 (mtime) | curriculum/versions/s01e49/policy.zip | hanging | 4 | 0 | 0.264 | 7.2 | 0 | 0.0 |
| curriculum/e15_v6b_runner_hanging_det_r3 | 2026-11-08 23:06 (mtime) | curriculum/versions/v6b_runner/policy.zip | hanging | 4 | 0 | 0.073 | 0.84 | 0 | 0.0 |
| curriculum/e15_v3b_runner_hanging_det_r3 | 2026-11-08 23:08 (mtime) | curriculum/versions/v3b_runner/policy.zip | hanging | 4 | 0 | 0.233 | 4.2 | 0 | 0.0 |
| curriculum/e16_sm5_hanging_det_r1 | 2026-11-08 23:35 (mtime) | curriculum/versions/sm5/policy.zip | hanging | 4 | 0 | 0.114 | 0.7 | 0 | 0.0 |
| curriculum/e16_sm2_hanging_det_r1 | 2026-11-08 23:36 (mtime) | curriculum/versions/sm2/policy.zip | hanging | 4 | 0 | 0.359 | 7.42 | 0 | 0.0 |
| curriculum/e16_sm2_hanging_det_r2 | 2026-11-08 23:37 (mtime) | curriculum/versions/sm2/policy.zip | hanging |  |  |  |  | 0 | 0.0 |
| curriculum/e16_sm5_hanging_det_r2 | 2026-11-08 23:37 (mtime) | curriculum/versions/sm5/policy.zip | hanging | 4 | 0 | 0.172 | 1.44 | 0 | 0.0 |
| curriculum/e16_sm5_hanging_det_r3 | 2026-11-08 23:39 (mtime) | curriculum/versions/sm5/policy.zip | hanging | 4 | 0 | 0.127 | 1.58 | 0 | 0.0 |
| curriculum/e16_sm2_hanging_det_r3 | 2026-11-08 23:40 (mtime) | curriculum/versions/sm2/policy.zip | hanging | 4 | 0 | 0.107 | 1.02 | 0 | 0.0 |
| curriculum/e17_rnA_quick | 2026-11-09 00:07 (mtime) | curriculum/versions/rnA/policy.zip | hanging | 4 | 0 | 0.196 | 5.28 | 0 | 0.0 |
| curriculum/e17_rnC_quick | 2026-11-09 00:07 (mtime) | curriculum/versions/rnC/policy.zip | hanging | 1 | 0 | 0.181 | 0.5 | 0 | 0.0 |
| curriculum/e18_rnA_fixed | 2026-11-09 00:44 (mtime) | curriculum/versions/rnA/policy.zip | hanging | 2 | 0 | 0.755 | 13.02 | 0 | 0.0 |
| curriculum/e19_ppo_rn | 2026-11-09 01:02 (mtime) | curriculum/versions/ppo_rn/policy.zip | hanging |  |  |  |  | 0 | 0.0 |

## curriculum/versions (48)

| run | when | parent | source | method | steps | has_policy | mb_pruned |
|---|---|---|---|---|---|---|---|
| curriculum/versions/v1 | 2026-11-07 22:59 (mtime) | sac_finetune/V1/policy.zip |  | offline SAC updates (ordinary SAC losses) on on-rig policy ticks only; no imitation, no other controllers' dat… |  | 1 | 0.0 |
| curriculum/versions/v2 | 2026-11-07 23:17 (mtime) | sac_finetune/V1/policy.zip |  | offline SAC updates (ordinary SAC losses) on on-rig policy ticks only; no imitation, no other controllers' dat… |  | 1 | 0.0 |
| curriculum/versions/v2m1 | 2026-11-07 23:19 (mtime) | sac_finetune/V1/policy.zip |  | SAC on simulator experience (V1's training simulator) with each batch 50% on-rig policy ticks; no imitation, n… |  | 1 | 0.0 |
| curriculum/versions/v2m2 | 2026-11-07 23:20 (mtime) | sac_finetune/V1/policy.zip |  | SAC on simulator experience (V1's training simulator) with each batch 50% on-rig policy ticks; no imitation, n… |  | 1 | 0.0 |
| curriculum/versions/v2_u1000 | 2026-11-07 23:28 (mtime) | sac_finetune/V1/policy.zip |  | offline SAC updates (ordinary SAC losses) on on-rig policy ticks only; no imitation, no other controllers' dat… |  | 1 | 0.0 |
| curriculum/versions/v2_u2500 | 2026-11-07 23:28 (mtime) | sac_finetune/V1/policy.zip |  | offline SAC updates (ordinary SAC losses) on on-rig policy ticks only; no imitation, no other controllers' dat… |  | 1 | 0.0 |
| curriculum/versions/v2_u5000 | 2026-11-07 23:28 (mtime) | sac_finetune/V1/policy.zip |  | offline SAC updates (ordinary SAC losses) on on-rig policy ticks only; no imitation, no other controllers' dat… |  | 1 | 0.0 |
| curriculum/versions/v2_u250 | 2026-11-07 23:29 (mtime) | sac_finetune/V1/policy.zip |  | offline SAC updates (ordinary SAC losses) on on-rig policy ticks only; no imitation, no other controllers' dat… |  | 1 | 0.0 |
| curriculum/versions/v2m2_runner | 2026-11-08 03:10 (mtime) | v2m2 |  |  |  | 1 | 0.0 |
| curriculum/versions/v3 | 2026-11-08 03:32 (mtime) | curriculum/versions/v2m2/policy.zip |  | SAC on simulator experience (V1's training simulator) with each batch 50% on-rig policy ticks; no imitation, n… |  | 1 | 0.0 |
| curriculum/versions/v3_runner | 2026-11-08 03:33 (mtime) | v3 |  |  |  | 1 | 0.0 |
| curriculum/versions/v3b | 2026-11-08 03:37 (mtime) | curriculum/versions/v2m2/policy.zip |  | SAC on simulator experience (V1's training simulator) with each batch 50% on-rig policy ticks; no imitation, n… |  | 1 | 0.0 |
| curriculum/versions/v3b_runner | 2026-11-08 03:37 (mtime) | v3b |  |  |  | 1 | 0.0 |
| curriculum/versions/v3c | 2026-11-08 03:38 (mtime) | curriculum/versions/v2m2/policy.zip |  | SAC on simulator experience (V1's training simulator) with each batch 50% on-rig policy ticks; no imitation, n… |  | 1 | 0.0 |
| curriculum/versions/v4 | 2026-11-08 03:47 (mtime) | curriculum/versions/v3b/policy.zip |  | SAC on simulator experience (V1's training simulator) with each batch 50% on-rig policy ticks; no imitation, n… |  | 1 | 0.0 |
| curriculum/versions/v4b | 2026-11-08 03:52 (mtime) | curriculum/versions/v3b/policy.zip |  | SAC on simulator experience (V1's training simulator) with each batch 50% on-rig policy ticks; no imitation, n… |  | 1 | 0.0 |
| curriculum/versions/v3c_runner | 2026-11-08 03:54 (mtime) | v3c |  |  |  | 1 | 0.0 |
| curriculum/versions/v5 | 2026-11-08 04:03 (mtime) | curriculum/versions/v3b/policy.zip |  | SAC on simulator experience (V1's training simulator) with each batch 50% on-rig policy ticks; no imitation, n… |  | 1 | 0.0 |
| curriculum/versions/v5_runner | 2026-11-08 04:03 (mtime) | v5 |  |  |  | 1 | 0.0 |
| curriculum/versions/v6 | 2026-11-08 04:14 (mtime) | curriculum/versions/v3b/policy.zip |  | SAC on simulator experience (V1's training simulator) with each batch 50% on-rig policy ticks; no imitation, n… |  | 1 | 0.0 |
| curriculum/versions/v6b | 2026-11-08 04:15 (mtime) | curriculum/versions/v3b/policy.zip |  | SAC on simulator experience (V1's training simulator) with each batch 50% on-rig policy ticks; no imitation, n… |  | 1 | 0.0 |
| curriculum/versions/v6b_runner | 2026-11-08 04:20 (mtime) | v6b |  |  |  | 1 | 0.0 |
| curriculum/versions/v7 | 2026-11-08 04:24 (mtime) | curriculum/versions/v3b/policy.zip |  | SAC on simulator experience (V1's training simulator) with each batch 50% on-rig policy ticks; no imitation, n… |  | 1 | 0.0 |
| curriculum/versions/v7b | 2026-11-08 04:26 (mtime) | curriculum/versions/v3b/policy.zip |  | SAC on simulator experience (V1's training simulator) with each batch 50% on-rig policy ticks; no imitation, n… |  | 1 | 0.0 |
| curriculum/versions/v8 | 2026-11-08 17:06 (mtime) | curriculum/versions/v3b/policy.zip |  | SAC on simulator experience (V1's training simulator) with each batch 50% on-rig policy ticks; no imitation, n… |  | 1 | 0.0 |
| curriculum/versions/v9 | 2026-11-08 20:53 (mtime) | curriculum/versions/v7/policy.zip |  | SAC on simulator experience (V1's training simulator) with each batch 50% on-rig policy ticks; no imitation, n… |  | 1 | 0.0 |
| curriculum/versions/s01e49 | 2026-11-08 22:39 (mtime) | curriculum/versions/v6b_runner/policy.zip |  | on-rig SAC session s01_v6b_online (scripts/rig_sac_online.py): checkpoint after episode 49, 105,308 updates; t… |  | 1 | 0.0 |
| curriculum/versions/s01e15 | 2026-11-08 22:49 (mtime) | curriculum/versions/v6b_runner/policy.zip |  | on-rig SAC session s01_v6b_online (scripts/rig_sac_online.py); no imitation, no other controllers' data |  | 1 | 0.0 |
| curriculum/versions/s01e17 | 2026-11-08 22:49 (mtime) | curriculum/versions/v6b_runner/policy.zip |  | on-rig SAC session s01_v6b_online (scripts/rig_sac_online.py); no imitation, no other controllers' data |  | 1 | 0.0 |
| curriculum/versions/sm15 | 2026-11-08 23:25 (mtime) | curriculum/versions/v6b_runner/policy.zip |  | SAC fine-tuned in V1's training simulator, reward only, with a near-upright penalty on the command change per … | 150000 | 1 | 0.0 |
| curriculum/versions/sm2 | 2026-11-08 23:25 (mtime) | curriculum/versions/v6b_runner/policy.zip |  | SAC fine-tuned in V1's training simulator, reward only, with a near-upright penalty on the command change per … | 150000 | 1 | 0.0 |
| curriculum/versions/sm5 | 2026-11-08 23:25 (mtime) | curriculum/versions/v6b_runner/policy.zip |  | SAC fine-tuned in V1's training simulator, reward only, with a near-upright penalty on the command change per … | 150000 | 1 | 0.0 |
| curriculum/versions/rnA | 2026-11-08 23:53 (mtime) | curriculum/versions/v6b_runner/policy.zip |  | SAC fine-tuned in V1's training simulator, reward only; optional near-upright penalty on the command change pe… | 200000 | 1 | 0.0 |
| curriculum/versions/rnB | 2026-11-08 23:54 (mtime) | curriculum/versions/v6b_runner/policy.zip |  | SAC fine-tuned in V1's training simulator, reward only; optional near-upright penalty on the command change pe… | 200000 | 1 | 0.0 |
| curriculum/versions/rnC | 2026-11-08 23:54 (mtime) | curriculum/versions/v6b_runner/policy.zip |  | SAC fine-tuned in V1's training simulator, reward only; optional near-upright penalty on the command change pe… | 200000 | 1 | 0.0 |
| curriculum/versions/ppo_rn | 2026-11-09 00:54 (mtime) |  | results/rig_rl_disturbance/ppo_long/policy.zip |  |  | 1 | 12.27 |
| curriculum/versions/dqn_rn | 2026-11-09 00:55 (mtime) |  | results/rig_rl_disturbance/dqn_long/policy.zip |  |  | 1 | 8.5 |
| curriculum/versions/dqn_rn05 | 2026-11-09 00:58 (mtime) |  | results/rig_rl_disturbance/dqn_long/policy.zip |  |  | 1 | 5.67 |
| curriculum/versions/ppo_rn05 | 2026-11-09 01:08 (mtime) |  | results/rig_rl_disturbance/ppo_long/policy.zip |  |  | 1 | 8.18 |
| curriculum/versions/ppo_ecA | 2026-11-09 01:15 (mtime) |  | results/rig_rl_disturbance/ppo_long/policy.zip |  |  | 1 | 8.18 |
| curriculum/versions/ppo_ecB | 2026-11-09 01:15 (mtime) |  | results/rig_rl_disturbance/ppo_long/policy.zip |  |  | 1 | 8.18 |
| curriculum/versions/ppo_ecC | 2026-11-09 01:15 (mtime) |  | results/rig_rl_disturbance/ppo_long/policy.zip |  |  | 1 | 8.18 |
| curriculum/versions/ppo_ecD | 2026-11-09 01:24 (mtime) |  | results/rig_rl_disturbance/ppo_long/policy.zip |  |  | 1 | 20.45 |
| curriculum/versions/ppo_ecE | 2026-11-09 01:26 (mtime) |  | curriculum/versions/ppo_ecB/policy.zip |  |  | 1 | 16.36 |
| curriculum/versions/ppo_ecF | 2026-11-09 01:29 (mtime) |  | curriculum/versions/ppo_ecB/policy.zip |  |  | 1 | 20.45 |
| curriculum/versions/ppo_ecG | 2026-11-09 01:33 (mtime) |  | curriculum/versions/ppo_ecE/policy.zip |  |  | 1 | 20.45 |
| curriculum/versions/ppo_ecH | 2026-11-09 01:35 (mtime) |  | curriculum/versions/ppo_ecF/policy.zip |  |  | 1 | 16.36 |
| curriculum/versions/ppo_ecH2 | 2026-11-09 01:39 (mtime) |  | curriculum/versions/ppo_ecF/policy.zip |  |  | 1 | 16.36 |

## curriculum_sim (44)

| run | when | checkpoint | parent | method | stage | episodes | successes | mean_balanced_frac | best_longest_balance_s | has_policy |
|---|---|---|---|---|---|---|---|---|---|---|
| curriculum_sim/b0_balance_det | 2026-11-07 22:26 (mtime) | sac_finetune/V1/policy.zip |  |  | balance | 4 | 0 | 0.363 | 1.06 | 0 |
| curriculum_sim/pilot_a/eval_v0 | 2026-11-07 22:26 (mtime) | sac_finetune/V1/policy.zip |  |  | balance | 8 | 0 | 0.394 | 1.08 | 0 |
| curriculum_sim/pilot_a/eval_v0_hang | 2026-11-07 22:26 (mtime) | sac_finetune/V1/policy.zip |  |  | hanging | 4 | 0 | 0.267 | 0.88 | 0 |
| curriculum_sim/pilot_a/train_1 | 2026-11-07 22:26 (mtime) | sac_finetune/V1/policy.zip |  |  | balance | 10 | 0 | 0.445 | 2.28 | 0 |
| curriculum_sim/pilot_a/eval_v1 | 2026-11-07 22:27 (mtime) | curriculum_sim/pilot_a/v1/policy.zip |  |  | balance | 8 | 0 | 0.922 | 4.94 | 0 |
| curriculum_sim/pilot_a/eval_v1_hang | 2026-11-07 22:27 (mtime) | curriculum_sim/pilot_a/v1/policy.zip |  |  | hanging | 4 | 0 | 0.695 | 4.4 | 0 |
| curriculum_sim/pilot_a/eval_v2 | 2026-11-07 22:27 (mtime) | curriculum_sim/pilot_a/v2/policy.zip |  |  | balance | 8 | 0 | 1.0 | 6.0 | 0 |
| curriculum_sim/pilot_a/eval_v2_hang | 2026-11-07 22:27 (mtime) | curriculum_sim/pilot_a/v2/policy.zip |  |  | hanging | 4 | 0 | 0.752 | 4.52 | 0 |
| curriculum_sim/pilot_a/train_2 | 2026-11-07 22:27 (mtime) | curriculum_sim/pilot_a/v1/policy.zip |  |  | balance | 10 | 0 | 0.905 | 6.0 | 0 |
| curriculum_sim/pilot_a/train_3 | 2026-11-07 22:27 (mtime) | curriculum_sim/pilot_a/v2/policy.zip |  |  | balance | 10 | 0 | 0.978 | 6.0 | 0 |
| curriculum_sim/pilot_a/v1 | 2026-11-07 22:27 (mtime) |  | sac_finetune/V1/policy.zip | offline SAC updates (ordinary SAC losses) on on-rig policy ticks only; no imitation, no other controllers' dat… |  |  |  |  |  | 1 |
| curriculum_sim/pilot_a/v2 | 2026-11-07 22:27 (mtime) |  | curriculum_sim/pilot_a/v1/policy.zip | offline SAC updates (ordinary SAC losses) on on-rig policy ticks only; no imitation, no other controllers' dat… |  |  |  |  |  | 1 |
| curriculum_sim/pilot_a/eval_v3 | 2026-11-07 22:28 (mtime) | curriculum_sim/pilot_a/v3/policy.zip |  |  | balance | 8 | 0 | 0.99 | 6.0 | 0 |
| curriculum_sim/pilot_a/eval_v3_hang | 2026-11-07 22:28 (mtime) | curriculum_sim/pilot_a/v3/policy.zip |  |  | hanging | 4 | 0 | 0.677 | 4.06 | 0 |
| curriculum_sim/pilot_a/eval_v4 | 2026-11-07 22:28 (mtime) | curriculum_sim/pilot_a/v4/policy.zip |  |  | balance | 8 | 0 | 1.0 | 6.0 | 0 |
| curriculum_sim/pilot_a/eval_v4_hang | 2026-11-07 22:28 (mtime) | curriculum_sim/pilot_a/v4/policy.zip |  |  | hanging | 4 | 0 | 0.675 | 4.06 | 0 |
| curriculum_sim/pilot_a/train_4 | 2026-11-07 22:28 (mtime) | curriculum_sim/pilot_a/v3/policy.zip |  |  | balance | 10 | 0 | 0.992 | 6.0 | 0 |
| curriculum_sim/pilot_a/v3 | 2026-11-07 22:28 (mtime) |  | curriculum_sim/pilot_a/v2/policy.zip | offline SAC updates (ordinary SAC losses) on on-rig policy ticks only; no imitation, no other controllers' dat… |  |  |  |  |  | 1 |
| curriculum_sim/pilot_a/v4 | 2026-11-07 22:28 (mtime) |  | curriculum_sim/pilot_a/v3/policy.zip | offline SAC updates (ordinary SAC losses) on on-rig policy ticks only; no imitation, no other controllers' dat… |  |  |  |  |  | 1 |
| curriculum_sim/pilot_a/eval20_v0_hang | 2026-11-07 22:29 (mtime) | sac_finetune/V1/policy.zip |  |  | hanging | 4 | 0 | 0.359 | 1.94 | 0 |
| curriculum_sim/pilot_a/eval20_v2_hang | 2026-11-07 22:29 (mtime) | curriculum_sim/pilot_a/v2/policy.zip |  |  | hanging | 4 | 4 | 0.925 | 18.52 | 0 |
| curriculum_sim/pilot_a/eval20_v4_hang | 2026-11-07 22:29 (mtime) | curriculum_sim/pilot_a/v4/policy.zip |  |  | hanging | 4 | 4 | 0.903 | 18.06 | 0 |
| curriculum_sim/lift_capture | 2026-11-07 22:30 (mtime) | sac_finetune/V1/policy.zip |  |  | capture | 8 | 0 | 0.415 | 2.24 | 0 |
| curriculum_sim/lift_mixed | 2026-11-07 22:30 (mtime) | sac_finetune/V1/policy.zip |  |  | mixed | 8 | 0 | 0.353 | 1.38 | 0 |
| curriculum_sim/lift_recover | 2026-11-07 22:30 (mtime) | sac_finetune/V1/policy.zip |  |  | recover | 8 | 0 | 0.368 | 1.8 | 0 |
| curriculum_sim/pilot_b/eval_v0 | 2026-11-07 22:38 (mtime) | sac_finetune/V1/policy.zip |  |  | balance | 8 | 0 | 0.456 | 1.28 | 0 |
| curriculum_sim/pilot_b/eval_v0_hang | 2026-11-07 22:39 (mtime) | sac_finetune/V1/policy.zip |  |  | hanging | 4 | 0 | 0.267 | 0.88 | 0 |
| curriculum_sim/pilot_b/eval_v1 | 2026-11-07 22:39 (mtime) | curriculum_sim/pilot_b/v1/policy.zip |  |  | balance | 8 | 0 | 0.991 | 6.0 | 0 |
| curriculum_sim/pilot_b/eval_v1_hang | 2026-11-07 22:39 (mtime) | curriculum_sim/pilot_b/v1/policy.zip |  |  | hanging | 4 | 0 | 0.589 | 4.5 | 0 |
| curriculum_sim/pilot_b/eval_v2 | 2026-11-07 22:39 (mtime) | curriculum_sim/pilot_b/v2/policy.zip |  |  | balance | 8 | 0 | 0.991 | 6.0 | 0 |
| curriculum_sim/pilot_b/eval_v2_hang | 2026-11-07 22:39 (mtime) | curriculum_sim/pilot_b/v2/policy.zip |  |  | hanging | 4 | 0 | 0.627 | 4.52 | 0 |
| curriculum_sim/pilot_b/train_1 | 2026-11-07 22:39 (mtime) | sac_finetune/V1/policy.zip |  |  | balance | 10 | 0 | 0.4 | 2.06 | 0 |
| curriculum_sim/pilot_b/train_2 | 2026-11-07 22:39 (mtime) | curriculum_sim/pilot_b/v1/policy.zip |  |  | balance | 1 | 0 | 0.927 | 5.42 | 0 |
| curriculum_sim/pilot_b/v1 | 2026-11-07 22:39 (mtime) |  | sac_finetune/V1/policy.zip | offline SAC updates (ordinary SAC losses) on on-rig policy ticks only; no imitation, no other controllers' dat… |  |  |  |  |  | 1 |
| curriculum_sim/pilot_b/v2 | 2026-11-07 22:39 (mtime) |  | curriculum_sim/pilot_b/v1/policy.zip | offline SAC updates (ordinary SAC losses) on on-rig policy ticks only; no imitation, no other controllers' dat… |  |  |  |  |  | 1 |
| curriculum_sim/lqr_balance_det | 2026-11-07 22:41 (mtime) | sac_finetune/V1/policy.zip |  |  | lqr_balance | 6 | 0 | 0.477 | 1.68 | 0 |
| curriculum_sim/lqr_capture_det | 2026-11-07 22:41 (mtime) | sac_finetune/V1/policy.zip |  |  | lqr_capture | 6 | 0 | 0.451 | 1.24 | 0 |
| curriculum_sim/lqr_mixed_det | 2026-11-07 22:41 (mtime) | sac_finetune/V1/policy.zip |  |  | lqr_mixed | 6 | 0 | 0.486 | 3.12 | 0 |
| curriculum_sim/lqr_balance_det2 | 2026-11-07 22:43 (mtime) | sac_finetune/V1/policy.zip |  |  | lqr_balance | 3 | 0 | 0.423 | 0.96 | 0 |
| curriculum_sim/gate_V1_hang | 2026-11-07 22:59 (mtime) | sac_finetune/V1/policy.zip |  |  | hanging | 4 | 0 | 0.359 | 1.94 | 0 |
| curriculum_sim/gate_V1_lqr | 2026-11-07 22:59 (mtime) | sac_finetune/V1/policy.zip |  |  | lqr_balance | 4 | 0 | 0.451 | 1.34 | 0 |
| curriculum_sim/gate_v1_hang | 2026-11-07 22:59 (mtime) | curriculum/versions/v1/policy.zip |  |  | hanging | 4 | 2 | 0.462 | 17.56 | 0 |
| curriculum_sim/gate_v1_lqr | 2026-11-07 22:59 (mtime) | curriculum/versions/v1/policy.zip |  |  | lqr_balance | 4 | 0 | 1.0 | 8.0 | 0 |
| curriculum_sim/fall_check | 2026-11-07 23:05 (mtime) | sac_finetune/V1/policy.zip |  |  | lqr_balance | 3 | 0 | 0.667 | 1.16 | 0 |

## custom_lqrdither (6)

| run | when | algorithm | config | checkpoint | episodes | successes | mean_balanced_frac | best_longest_balance_s |
|---|---|---|---|---|---|---|---|---|
| custom_lqrdither_20261107_204044 | 2026-11-07 20:40 | custom | configs/custom_lqr_dither_10.json | results/sac_focused_policy.zip | 1 | 1 | 0.692 | 10.28 |
| custom_lqrdither_20261107_204120 | 2026-11-07 20:41 | custom | configs/custom_lqr_dither_10.json | results/sac_focused_policy.zip | 1 | 0 | 0.299 | 1.58 |
| custom_lqrdither_20261107_204153 | 2026-11-07 20:41 | custom | configs/custom_lqr_dither_10.json | results/sac_focused_policy.zip | 1 | 0 | 0.719 | 9.5 |
| custom_lqrdither_20261107_204221 | 2026-11-07 20:42 | custom | configs/custom_lqr_dither_10.json | results/sac_focused_policy.zip | 1 | 0 | 0.289 | 1.56 |
| custom_lqrdither_20261107_204251 | 2026-11-07 20:42 | custom | configs/custom_lqr_dither_10.json | results/sac_focused_policy.zip | 1 | 0 | 0.185 | 1.36 |
| custom_lqrdither_20261107_204321 | 2026-11-07 20:43 | custom | configs/custom_lqr_dither_10.json | results/sac_focused_policy.zip | 1 | 0 | 0.595 | 6.98 |

## custom_robustness (2)

| run | when | episodes |
|---|---|---|
| custom_robustness_01 | 2026-11-07 00:42 (mtime) | 1 |
| custom_robustness_02 | 2026-11-07 00:43 (mtime) | 1 |

## custom_sacraw (3)

| run | when | algorithm | config | checkpoint | episodes | mean_balanced_frac | best_longest_balance_s |
|---|---|---|---|---|---|---|---|
| custom_sacraw_20261107_203208 | 2026-11-07 20:32 | custom | configs/custom_sacbal_sac_raw.json | results/sac_focused_policy.zip | 1 | 0.156 | 1.04 |
| custom_sacraw_20261107_203236 | 2026-11-07 20:32 | custom | configs/custom_sacbal_sac_raw.json | results/sac_focused_policy.zip | 1 | 0.113 | 0.52 |
| custom_sacraw_20261107_203305 | 2026-11-07 20:33 | custom | configs/custom_sacbal_sac_raw.json | results/sac_focused_policy.zip | 1 | 0.152 | 0.56 |

## custom_sim (2)

| run | when | algorithm | config | checkpoint | episodes | successes | mean_balanced_frac | best_longest_balance_s |
|---|---|---|---|---|---|---|---|---|
| custom_sim_01 | 2026-11-07 00:40 (mtime) | custom | configs/custom_my_rig.json | results/sac_focused_policy.zip | 1 | 0 | 0.007 | 0.04 |
| custom_sim_02 | 2026-11-07 00:43 (mtime) | custom | configs/custom_my_rig.json | results/sac_focused_policy.zip | 1 | 1 | 0.86 | 12.9 |

## custom_v1matched (3)

| run | when | algorithm | config | checkpoint | episodes | mean_balanced_frac | best_longest_balance_s |
|---|---|---|---|---|---|---|---|
| custom_v1matched_20261107_203024 | 2026-11-07 20:30 | custom | configs/custom_sacbal_v1_matched.json | results/sac_focused_policy.zip | 1 | 0.124 | 0.72 |
| custom_v1matched_20261107_203100 | 2026-11-07 20:31 | custom | configs/custom_sacbal_v1_matched.json | results/sac_focused_policy.zip | 1 | 0.091 | 0.38 |
| custom_v1matched_20261107_203132 | 2026-11-07 20:31 | custom | configs/custom_sacbal_v1_matched.json | results/sac_focused_policy.zip | 1 | 0.092 | 0.56 |

## custom_v1raw (3)

| run | when | algorithm | config | checkpoint | episodes | mean_balanced_frac | best_longest_balance_s |
|---|---|---|---|---|---|---|---|
| custom_v1raw_20261107_202826 | 2026-11-07 20:28 | custom | configs/custom_sacbal_v1_raw.json | results/sac_focused_policy.zip | 1 | 0.172 | 1.1 |
| custom_v1raw_20261107_202856 | 2026-11-07 20:28 | custom | configs/custom_sacbal_v1_raw.json | results/sac_focused_policy.zip | 1 | 0.096 | 0.44 |
| custom_v1raw_20261107_202927 | 2026-11-07 20:29 | custom | configs/custom_sacbal_v1_raw.json | results/sac_focused_policy.zip | 1 | 0.192 | 1.02 |

## dqn (1)

| run | when | algorithm | config | checkpoint | episodes |
|---|---|---|---|---|---|
| dqn_20261108_212009 | 2026-11-08 21:20 | dqn | configs/sac_my_rig.json | results/rig_rl_disturbance/dqn_long/policy.zip | 1 |

## dqn_rig (1)

| run | when | algorithm | config | checkpoint | episodes | mean_balanced_frac | best_longest_balance_s |
|---|---|---|---|---|---|---|---|
| dqn_rig_20261107_175326 | 2026-11-07 17:53 | dqn | configs/sac_my_rig.json | results/rig_rl_disturbance/dqn_long/policy.zip | 1 | 0.004 | 0.06 |

## dqn_rn05 (3)

| run | when | algorithm | config | checkpoint | episodes | successes | mean_balanced_frac | best_longest_balance_s |
|---|---|---|---|---|---|---|---|---|
| dqn_rn05_20261109_010258 | 2026-11-09 01:02 | dqn | configs/sac_my_rig.json | curriculum/versions/dqn_rn05/policy.zip | 1 | 1 | 0.871 | 13.06 |
| dqn_rn05_20261109_010341 | 2026-11-09 01:03 | dqn | configs/sac_my_rig.json | curriculum/versions/dqn_rn05/policy.zip | 1 | 1 | 0.904 | 13.56 |
| dqn_rn05_20261109_141209 | 2026-11-09 14:12 | dqn | configs/sac_my_rig.json | results/rig_rl_disturbance/dqn_rn05/policy.zip | 1 | 0 | 0.751 | 5.18 |

## envelope (2)

| run | when | episodes |
|---|---|---|
| envelope_01 | 2026-11-06 21:22 (mtime) | 1 |
| envelope_02 | 2026-11-07 01:28 (mtime) | 1 |

## envelope_lqr (1)

| run | when | episodes |
|---|---|---|
| envelope_lqr_01 | 2026-11-06 21:28 (mtime) | 1 |

## gpu_rl (3)

| run | when | has_policy |
|---|---|---|
| gpu_rl_20261016/dqn_train | 2026-10-16 | 1 |
| gpu_rl_20261016/ppo_hybrid_train | 2026-10-16 | 1 |
| gpu_rl_20261016/sac_train | 2026-10-16 | 1 |

## ilqr (2)

| run | when | algorithm | config | checkpoint | episodes | mean_balanced_frac | best_longest_balance_s |
|---|---|---|---|---|---|---|---|
| ilqr_20261109_001333 | 2026-11-09 00:13 | ilqr | configs/ilqr_my_rig_lqr_match.json | results/sac_focused_policy.zip | 1 | 0.069 | 0.18 |
| ilqr_20261109_001358 | 2026-11-09 00:13 | ilqr | configs/ilqr_my_rig_lqr_match.json | results/sac_focused_policy.zip | 1 | 0.076 | 0.52 |

## ilqr_lqr_match (5)

| run | when | algorithm | config | checkpoint | episodes | successes | mean_balanced_frac | best_longest_balance_s |
|---|---|---|---|---|---|---|---|---|
| ilqr_lqr_match_20261107_160807 | 2026-11-07 16:08 | ilqr | configs/ilqr_my_rig_lqr_match.json | results/sac_focused_policy.zip | 1 | 0 | 0.192 | 1.34 |
| ilqr_lqr_match_20261107_160844 | 2026-11-07 16:08 | ilqr | configs/ilqr_my_rig_lqr_match.json | results/sac_focused_policy.zip | 1 | 0 | 0.503 | 6.54 |
| ilqr_lqr_match_20261107_160921 | 2026-11-07 16:09 | ilqr | configs/ilqr_my_rig_lqr_match.json | results/sac_focused_policy.zip | 1 | 0 | 0.215 | 0.94 |
| ilqr_lqr_match_20261107_160955 | 2026-11-07 16:09 | ilqr | configs/ilqr_my_rig_lqr_match.json | results/sac_focused_policy.zip | 1 | 0 | 0.54 | 6.46 |
| ilqr_lqr_match_20261107_161026 | 2026-11-07 16:10 | ilqr | configs/ilqr_my_rig_lqr_match.json | results/sac_focused_policy.zip | 1 | 1 | 0.884 | 13.26 |

## ilqr_transfer (5)

| run | when | algorithm | config | checkpoint | episodes | mean_balanced_frac | best_longest_balance_s |
|---|---|---|---|---|---|---|---|
| ilqr_transfer_20261107_151300 | 2026-11-07 15:13 | ilqr | configs/ilqr_my_rig_transfer.json | results/sac_focused_policy.zip | 1 | 0.343 | 4.3 |
| ilqr_transfer_20261107_151344 | 2026-11-07 15:13 | ilqr | configs/ilqr_my_rig_transfer.json | results/sac_focused_policy.zip | 1 | 0.164 | 1.18 |
| ilqr_transfer_20261107_151433 | 2026-11-07 15:14 | ilqr | configs/ilqr_my_rig_transfer.json | results/sac_focused_policy.zip | 1 | 0.179 | 1.32 |
| ilqr_transfer_20261107_151547 | 2026-11-07 15:15 | ilqr | configs/ilqr_my_rig_transfer.json | results/sac_focused_policy.zip | 1 | 0.197 | 1.28 |
| ilqr_transfer_20261107_152428 | 2026-11-07 15:24 | ilqr | configs/ilqr_my_rig_transfer.json | results/sac_focused_policy.zip | 1 | 0.141 | 0.82 |

## lqr_braking (1)

| run | when | episodes |
|---|---|---|
| lqr_braking_01 | 2026-11-07 01:02 (mtime) | 1 |

## lqr_calibrated (5)

| run | when | algorithm | config | checkpoint | episodes | mean_balanced_frac | best_longest_balance_s |
|---|---|---|---|---|---|---|---|
| lqr_calibrated_20261107_024351 | 2026-11-07 02:43 | lqr | configs/lqr_my_rig_calibrated.json | results/sac_focused_policy.zip | 1 | 0.439 | 6.26 |
| lqr_calibrated_20261107_024427 | 2026-11-07 02:44 | lqr | configs/lqr_my_rig_calibrated.json | results/sac_focused_policy.zip | 1 | 0.584 | 2.62 |
| lqr_calibrated_20261107_024501 | 2026-11-07 02:45 | lqr | configs/lqr_my_rig_calibrated.json | results/sac_focused_policy.zip | 1 | 0.397 | 2.92 |
| lqr_calibrated_20261107_024740 | 2026-11-07 02:47 | lqr | configs/lqr_my_rig_calibrated.json | results/sac_focused_policy.zip | 1 | 0.231 | 1.52 |
| lqr_calibrated_20261107_025053 | 2026-11-07 02:50 | lqr | configs/lqr_my_rig_calibrated.json | results/sac_focused_policy.zip | 1 | 0.244 | 1.5 |

## lqr_calibration (1)

| run | when | episodes |
|---|---|---|
| lqr_calibration_01 | 2026-11-06 23:52 (mtime) | 1 |

## lqr_coupling_delay (50)

| run | when | algorithm | config | checkpoint | episodes | successes | mean_balanced_frac | best_longest_balance_s |
|---|---|---|---|---|---|---|---|---|
| lqr_coupling_delay_20261107_022139 | 2026-11-07 02:21 | lqr | configs/lqr_my_rig_coupling_delay.json | results/sac_focused_policy.zip | 1 | 0 | 0.077 | 0.54 |
| lqr_coupling_delay_20261107_022206 | 2026-11-07 02:22 | lqr | configs/lqr_my_rig_coupling_delay.json | results/sac_focused_policy.zip | 1 | 0 | 0.155 | 1.1 |
| lqr_coupling_delay_20261107_022230 | 2026-11-07 02:22 | lqr | configs/lqr_my_rig_coupling_delay.json | results/sac_focused_policy.zip | 1 | 0 | 0.781 | 6.94 |
| lqr_coupling_delay_20261107_022340 | 2026-11-07 02:23 | lqr | configs/lqr_my_rig_coupling_delay.json | results/sac_focused_policy.zip | 1 | 0 | 0.187 | 1.12 |
| lqr_coupling_delay_20261107_022408 | 2026-11-07 02:24 | lqr | configs/lqr_my_rig_coupling_delay.json | results/sac_focused_policy.zip | 1 | 0 | 0.627 | 4.78 |
| lqr_coupling_delay_20261107_022520 | 2026-11-07 02:25 | lqr | configs/lqr_my_rig_coupling_delay.json | results/sac_focused_policy.zip | 1 | 0 | 0.239 | 0.82 |
| lqr_coupling_delay_20261107_022637 | 2026-11-07 02:26 | lqr | configs/lqr_my_rig_coupling_delay.json | results/sac_focused_policy.zip | 1 | 0 | 0.408 | 3.36 |
| lqr_coupling_delay_20261107_023430 | 2026-11-07 02:34 | lqr | configs/lqr_my_rig_coupling_delay.json | results/sac_focused_policy.zip | 1 | 0 | 0.0 | 0.0 |
| lqr_coupling_delay_20261107_025142 | 2026-11-07 02:51 | lqr | configs/lqr_my_rig_coupling_delay.json | results/sac_focused_policy.zip | 1 | 0 | 0.273 | 1.46 |
| lqr_coupling_delay_20261107_025340 | 2026-11-07 02:53 | lqr | configs/lqr_my_rig_coupling_delay.json | results/sac_focused_policy.zip | 1 | 0 | 0.38 | 4.6 |
| lqr_coupling_delay_20261107_025449 | 2026-11-07 02:54 | lqr | configs/lqr_my_rig_coupling_delay.json | results/sac_focused_policy.zip | 1 | 0 |  |  |
| lqr_coupling_delay_20261107_025738 | 2026-11-07 02:57 | lqr | configs/lqr_my_rig_coupling_delay.json | results/sac_focused_policy.zip | 1 | 1 | 0.805 | 11.92 |
| lqr_coupling_delay_20261107_025826 | 2026-11-07 02:58 | lqr | configs/lqr_my_rig_coupling_delay.json | results/sac_focused_policy.zip | 1 | 0 | 0.641 | 4.58 |
| lqr_coupling_delay_20261107_025856 | 2026-11-07 02:58 | lqr | configs/lqr_my_rig_coupling_delay.json | results/sac_focused_policy.zip | 1 | 1 | 0.748 | 11.1 |
| lqr_coupling_delay_20261107_030130 | 2026-11-07 03:01 | lqr | configs/lqr_my_rig_coupling_delay.json | results/sac_focused_policy.zip | 1 | 0 | 0.667 | 9.98 |
| lqr_coupling_delay_20261107_030202 | 2026-11-07 03:02 | lqr | configs/lqr_my_rig_coupling_delay.json | results/sac_focused_policy.zip | 1 | 1 | 0.856 | 12.84 |
| lqr_coupling_delay_20261107_145456 | 2026-11-07 14:54 | lqr | configs/lqr_my_rig_coupling_delay.json | results/sac_focused_policy.zip | 1 | 0 | 0.469 | 4.02 |
| lqr_coupling_delay_20261107_145555 | 2026-11-07 14:55 | lqr | configs/lqr_my_rig_coupling_delay.json | results/sac_focused_policy.zip | 1 | 1 | 0.675 | 10.08 |
| lqr_coupling_delay_20261108_025746 | 2026-11-08 02:57 | lqr | configs/lqr_my_rig_coupling_delay.json | results/sac_focused_policy.zip | 1 | 0 | 0.148 | 1.16 |
| lqr_coupling_delay_20261108_030010 | 2026-11-08 03:00 | lqr | configs/lqr_my_rig_coupling_delay.json | results/sac_focused_policy.zip | 1 | 0 | 0.557 | 8.1 |
| lqr_coupling_delay_20261108_203853 | 2026-11-08 20:38 | lqr | configs/lqr_my_rig_coupling_delay.json | results/sac_focused_policy.zip | 1 | 0 | 0.0 | 0.0 |
| lqr_coupling_delay_20261109_000909 | 2026-11-09 00:09 | lqr | configs/lqr_my_rig_coupling_delay.json | results/sac_focused_policy.zip | 1 | 0 |  |  |
| lqr_coupling_delay_20261109_000945 | 2026-11-09 00:09 | lqr | configs/lqr_my_rig_coupling_delay.json | results/sac_focused_policy.zip | 1 | 0 | 0.716 | 9.48 |
| lqr_coupling_delay_20261109_001013 | 2026-11-09 00:10 | lqr | configs/lqr_my_rig_coupling_delay.json | results/sac_focused_policy.zip | 1 | 0 | 0.168 | 0.64 |
| lqr_coupling_delay_20261109_001037 | 2026-11-09 00:10 | lqr | configs/lqr_my_rig_coupling_delay.json | results/sac_focused_policy.zip | 1 | 0 | 0.184 | 1.14 |
| lqr_coupling_delay_20261109_001102 | 2026-11-09 00:11 | lqr | configs/lqr_my_rig_coupling_delay.json | results/sac_focused_policy.zip | 1 | 0 | 0.072 | 0.26 |
| lqr_coupling_delay_20261109_001134 | 2026-11-09 00:11 | lqr | configs/lqr_my_rig_coupling_delay.json | results/sac_focused_policy.zip | 1 | 0 | 0.021 | 0.08 |
| lqr_coupling_delay_20261109_001151 | 2026-11-09 00:11 | lqr | configs/lqr_my_rig_coupling_delay.json | results/sac_focused_policy.zip | 1 | 0 | 0.131 | 0.48 |
| lqr_coupling_delay_20261109_001212 | 2026-11-09 00:12 | lqr | configs/lqr_my_rig_coupling_delay.json | results/sac_focused_policy.zip | 1 | 0 | 0.052 | 0.32 |
| lqr_coupling_delay_20261109_001425 | 2026-11-09 00:14 | lqr | configs/lqr_my_rig_coupling_delay.json | results/sac_focused_policy.zip | 1 | 0 | 0.277 | 2.56 |
| lqr_coupling_delay_20261109_001451 | 2026-11-09 00:14 | lqr | configs/lqr_my_rig_coupling_delay.json | results/sac_focused_policy.zip | 1 | 0 |  |  |
| lqr_coupling_delay_20261109_001459 | 2026-11-09 00:14 | lqr | configs/lqr_my_rig_coupling_delay.json | results/sac_focused_policy.zip | 1 | 0 | 0.121 | 0.64 |
| lqr_coupling_delay_20261109_001523 | 2026-11-09 00:15 | lqr | configs/lqr_my_rig_coupling_delay.json | results/sac_focused_policy.zip | 1 | 0 | 0.052 | 0.22 |
| lqr_coupling_delay_20261109_001607 | 2026-11-09 00:16 | lqr | configs/lqr_my_rig_coupling_delay.json | results/sac_focused_policy.zip | 1 | 0 | 0.072 | 0.24 |
| lqr_coupling_delay_20261109_001710 | 2026-11-09 00:17 | lqr | configs/lqr_my_rig_coupling_delay.json | results/sac_focused_policy.zip | 1 | 0 | 0.381 | 4.5 |
| lqr_coupling_delay_20261109_001738 | 2026-11-09 00:17 | lqr | configs/lqr_my_rig_coupling_delay.json | results/sac_focused_policy.zip | 1 | 0 | 0.161 | 0.52 |
| lqr_coupling_delay_20261109_001852 | 2026-11-09 00:18 | lqr | configs/lqr_my_rig_coupling_delay.json | results/sac_focused_policy.zip | 1 | 0 | 0.171 | 1.68 |
| lqr_coupling_delay_20261109_002009 | 2026-11-09 00:20 | lqr | configs/lqr_my_rig_coupling_delay.json | results/sac_focused_policy.zip | 1 | 0 | 0.208 | 2.44 |
| lqr_coupling_delay_20261109_002150 | 2026-11-09 00:21 | lqr | configs/lqr_my_rig_coupling_delay.json | results/sac_focused_policy.zip | 1 | 0 |  |  |
| lqr_coupling_delay_20261109_002157 | 2026-11-09 00:21 | lqr | configs/lqr_my_rig_coupling_delay.json | results/sac_focused_policy.zip | 1 | 0 | 0.173 | 1.44 |
| lqr_coupling_delay_20261109_002228 | 2026-11-09 00:22 | lqr | configs/lqr_my_rig_coupling_delay.json | results/sac_focused_policy.zip | 1 | 0 | 0.069 | 0.18 |
| lqr_coupling_delay_20261109_002243 | 2026-11-09 00:22 | lqr | configs/lqr_my_rig_coupling_delay.json | results/sac_focused_policy.zip | 1 | 0 | 0.003 | 0.02 |
| lqr_coupling_delay_20261109_002442 | 2026-11-09 00:24 | lqr | configs/lqr_my_rig_coupling_delay.json | results/sac_focused_policy.zip | 1 | 0 | 0.103 | 0.18 |
| lqr_coupling_delay_20261109_002455 | 2026-11-09 00:24 | lqr | configs/lqr_my_rig_coupling_delay.json | results/sac_focused_policy.zip | 1 | 0 | 0.087 | 0.22 |
| lqr_coupling_delay_20261109_003726 | 2026-11-09 00:37 | lqr | configs/lqr_my_rig_coupling_delay.json | results/sac_focused_policy.zip | 1 | 0 | 0.075 | 0.24 |
| lqr_coupling_delay_20261109_003740 | 2026-11-09 00:37 | lqr | configs/lqr_my_rig_coupling_delay.json | results/sac_focused_policy.zip | 1 | 0 | 0.051 | 0.1 |
| lqr_coupling_delay_20261109_003756 | 2026-11-09 00:37 | lqr | configs/lqr_my_rig_coupling_delay.json | results/sac_focused_policy.zip | 1 | 0 | 0.109 | 0.62 |
| lqr_coupling_delay_20261109_004232 | 2026-11-09 00:42 | lqr | configs/lqr_my_rig_coupling_delay.json | results/sac_focused_policy.zip | 1 | 0 | 0.74 | 7.7 |
| lqr_coupling_delay_20261109_011506 | 2026-11-09 01:15 | lqr | configs/lqr_my_rig_coupling_delay.json | results/sac_focused_policy.zip | 1 | 1 | 0.771 | 10.46 |
| lqr_coupling_delay_20261109_152405 | 2026-11-09 15:24 | lqr | configs/lqr_my_rig_coupling_delay.json | results/sac_focused_policy.zip | 1 | 0 | 0.677 | 11.26 |

## lqr_diagnosis (1)

| run | when | episodes |
|---|---|---|
| lqr_diagnosis_01 | 2026-11-07 01:44 (mtime) | 1 |

## lqr_feedback (1)

| run | when | episodes |
|---|---|---|
| lqr_feedback_01 | 2026-11-07 00:28 (mtime) | 1 |

## lqr_hw (16)

| run | when | algorithm | config | checkpoint | episodes | mean_balanced_frac | best_longest_balance_s |
|---|---|---|---|---|---|---|---|
| lqr_hw_01 | 2026-11-06 21:29 (mtime) | lqr | configs/lqr_my_rig.json | None | 1 | 0.0 | 0.0 |
| lqr_hw_02 | 2026-11-06 21:32 (mtime) | lqr | configs/lqr_my_rig.json | None | 1 | 0.0 | 0.0 |
| lqr_hw_03 | 2026-11-06 21:34 (mtime) | lqr | configs/lqr_my_rig_capture.json | None | 1 | 0.448 | 2.24 |
| lqr_hw_04 | 2026-11-06 21:50 (mtime) | lqr | configs/lqr_my_rig_capture.json | None | 1 | 0.097 | 0.64 |
| lqr_hw_05 | 2026-11-06 21:55 (mtime) | lqr | configs/lqr_my_rig_guarded.json | None | 1 | 0.032 | 0.16 |
| lqr_hw_06 | 2026-11-06 23:46 (mtime) | lqr | configs/lqr_my_rig_guarded.json | None | 1 | 0.004 | 0.02 |
| lqr_hw_07 | 2026-11-06 23:57 (mtime) | lqr | configs/lqr_my_rig_robust.json | None | 1 | 0.0 | 0.0 |
| lqr_hw_08 | 2026-11-06 23:58 (mtime) | lqr | configs/lqr_my_rig_robust.json | None | 1 | 0.0 | 0.0 |
| lqr_hw_09 | 2026-11-07 00:15 (mtime) | lqr | configs/lqr_my_rig_adaptive.json | None | 1 | 0.147 | 1.18 |
| lqr_hw_10 | 2026-11-07 00:33 (mtime) | lqr | configs/lqr_my_rig_filtered.json | None | 1 | 0.015 | 0.08 |
| lqr_hw_11 | 2026-11-07 00:55 (mtime) | lqr | configs/lqr_my_rig_learned_swing.json | results/sac_focused_policy.zip | 1 | 0.0 | 0.0 |
| lqr_hw_12 | 2026-11-07 01:24 (mtime) | lqr | configs/lqr_my_rig_braked_swing.json | results/sac_focused_policy.zip | 1 | 0.327 | 0.98 |
| lqr_hw_13 | 2026-11-07 01:26 (mtime) | lqr | configs/lqr_my_rig_braked_swing.json | results/sac_focused_policy.zip | 1 | 0.243 | 1.18 |
| lqr_hw_14 | 2026-11-07 01:26 (mtime) | lqr | configs/lqr_my_rig_braked_swing.json | results/sac_focused_policy.zip | 1 | 0.163 | 1.1 |
| lqr_hw_15 | 2026-11-07 02:10 (mtime) | lqr | configs/lqr_my_rig_observed.json | results/sac_focused_policy.zip | 1 | 0.428 | 2.36 |
| lqr_hw_18 | 2026-11-07 02:10 (mtime) | lqr | configs/lqr_my_rig_observed.json | results/sac_focused_policy.zip | 1 | 0.073 | 0.24 |

## lqr_learned_robustness (1)

| run | when | episodes |
|---|---|---|
| lqr_learned_robustness_01 | 2026-11-07 00:48 (mtime) | 1 |

## lqr_observer (2)

| run | when | episodes |
|---|---|---|
| lqr_observer_01 | 2026-11-07 01:54 (mtime) | 1 |
| lqr_observer_02 | 2026-11-07 01:57 (mtime) | 1 |

## lqr_recenter (1)

| run | when | episodes |
|---|---|---|
| lqr_recenter_01 | 2026-11-07 01:35 (mtime) | 1 |

## lqr_robustness (6)

| run | when | episodes |
|---|---|---|
| lqr_robustness_01 | 2026-11-06 23:56 (mtime) | 1 |
| lqr_robustness_02 | 2026-11-06 23:56 (mtime) | 1 |
| lqr_robustness_03 | 2026-11-07 00:07 (mtime) | 1 |
| lqr_robustness_04 | 2026-11-07 00:07 (mtime) | 1 |
| lqr_robustness_05 | 2026-11-07 00:17 (mtime) | 1 |
| lqr_robustness_06 | 2026-11-07 00:27 (mtime) | 1 |

## lqr_sim_adaptive (2)

| run | when | algorithm | config | checkpoint | episodes | successes | mean_balanced_frac | best_longest_balance_s |
|---|---|---|---|---|---|---|---|---|
| lqr_sim_adaptive_01 | 2026-11-07 00:07 (mtime) | lqr | configs/lqr_my_rig_adaptive.json | None | 1 | 1 | 0.793 | 11.9 |
| lqr_sim_adaptive_02 | 2026-11-07 00:17 (mtime) | lqr | configs/lqr_my_rig_adaptive_15ms.json | None | 1 | 1 | 0.793 | 11.9 |

## lqr_sim_braked (1)

| run | when | algorithm | config | checkpoint | episodes | successes | mean_balanced_frac | best_longest_balance_s |
|---|---|---|---|---|---|---|---|---|
| lqr_sim_braked_01 | 2026-11-07 01:01 (mtime) | lqr | configs/lqr_my_rig_braked_swing.json | results/sac_focused_policy.zip | 1 | 1 | 0.859 | 12.88 |

## lqr_sim_capture (1)

| run | when | algorithm | config | checkpoint | episodes | successes | mean_balanced_frac | best_longest_balance_s |
|---|---|---|---|---|---|---|---|---|
| lqr_sim_capture_01 | 2026-11-06 21:33 (mtime) | lqr | configs/lqr_my_rig_capture.json | None | 1 | 1 | 0.897 | 13.46 |

## lqr_sim_filtered (1)

| run | when | algorithm | config | checkpoint | episodes | successes | mean_balanced_frac | best_longest_balance_s |
|---|---|---|---|---|---|---|---|---|
| lqr_sim_filtered_01 | 2026-11-07 00:27 (mtime) | lqr | configs/lqr_my_rig_filtered.json | None | 1 | 1 | 0.793 | 11.9 |

## lqr_sim_guarded (3)

| run | when | algorithm | config | checkpoint | episodes | successes | mean_balanced_frac | best_longest_balance_s |
|---|---|---|---|---|---|---|---|---|
| lqr_sim_guarded_01 | 2026-11-06 21:53 (mtime) | lqr | configs/lqr_my_rig_guarded.json | None | 1 | 1 | 0.897 | 13.46 |
| lqr_sim_guarded_02 | 2026-11-06 23:44 (mtime) | lqr | configs/lqr_my_rig_guarded.json | None | 1 | 0 | 0.045 | 0.32 |
| lqr_sim_guarded_03 | 2026-11-06 23:46 (mtime) | lqr | configs/lqr_my_rig_guarded.json | None | 1 | 1 | 0.897 | 13.46 |

## lqr_sim_learned (1)

| run | when | algorithm | config | checkpoint | episodes | successes | mean_balanced_frac | best_longest_balance_s |
|---|---|---|---|---|---|---|---|---|
| lqr_sim_learned_01 | 2026-11-07 00:46 (mtime) | lqr | configs/lqr_my_rig_learned_swing.json | results/sac_focused_policy.zip | 1 | 1 | 0.86 | 12.9 |

## lqr_sim_my_rig (3)

| run | when | algorithm | config | checkpoint | episodes | successes | mean_balanced_frac | best_longest_balance_s |
|---|---|---|---|---|---|---|---|---|
| lqr_sim_my_rig_01 | 2026-11-06 21:23 (mtime) | lqr | None | None | 1 | 0 | 0.0 | 0.0 |
| lqr_sim_my_rig_03 | 2026-11-06 21:26 (mtime) | lqr | configs/lqr_my_rig.json | None | 1 | 1 | 0.897 | 13.46 |
| lqr_sim_my_rig_04 | 2026-11-06 21:26 (mtime) | lqr | configs/lqr_my_rig.json | None | 1 | 1 | 0.897 | 13.46 |

## lqr_sim_observed (2)

| run | when | algorithm | config | checkpoint | episodes | successes | mean_balanced_frac | best_longest_balance_s |
|---|---|---|---|---|---|---|---|---|
| lqr_sim_observed_01 | 2026-11-07 01:54 (mtime) | lqr | configs/lqr_my_rig_observed.json | results/sac_focused_policy.zip | 1 | 1 | 0.859 | 12.88 |
| lqr_sim_observed_02 | 2026-11-07 01:56 (mtime) | lqr | configs/lqr_my_rig_observed.json | results/sac_focused_policy.zip | 1 | 1 | 0.859 | 12.88 |

## lqr_sim_recenter (1)

| run | when | algorithm | config | checkpoint | episodes | successes | mean_balanced_frac | best_longest_balance_s |
|---|---|---|---|---|---|---|---|---|
| lqr_sim_recenter_01 | 2026-11-07 01:34 (mtime) | lqr | configs/lqr_my_rig_recenter.json | results/sac_focused_policy.zip | 1 | 1 | 0.859 | 12.88 |

## lqr_sim_robust (1)

| run | when | algorithm | config | checkpoint | episodes | successes | mean_balanced_frac | best_longest_balance_s |
|---|---|---|---|---|---|---|---|---|
| lqr_sim_robust_01 | 2026-11-06 23:56 (mtime) | lqr | configs/lqr_my_rig_robust.json | None | 1 | 1 | 0.824 | 12.36 |

## lqr_swing (3)

| run | when | algorithm | config | checkpoint | episodes | mean_balanced_frac | best_longest_balance_s |
|---|---|---|---|---|---|---|---|
| lqr_swing_20261107_024813 | 2026-11-07 02:48 | lqr | configs/lqr_my_rig_swing.json | results/sac_focused_policy.zip | 1 | 0.176 | 0.96 |
| lqr_swing_20261107_024848 | 2026-11-07 02:48 | lqr | configs/lqr_my_rig_swing.json | results/sac_focused_policy.zip | 1 | 0.312 | 2.18 |
| lqr_swing_20261107_024917 | 2026-11-07 02:49 | lqr | configs/lqr_my_rig_swing.json | results/sac_focused_policy.zip | 1 | 0.131 | 1.28 |

## lqr_upright_learned (1)

| run | when | algorithm | config | checkpoint | episodes | successes | mean_balanced_frac | best_longest_balance_s |
|---|---|---|---|---|---|---|---|---|
| lqr_upright_learned_01 | 2026-11-07 00:46 (mtime) | lqr | configs/lqr_my_rig_learned_swing.json | results/sac_focused_policy.zip | 10 | 9 | 0.898 | 15.0 |

## mpc (2)

| run | when | algorithm | config | checkpoint | episodes | mean_balanced_frac | best_longest_balance_s |
|---|---|---|---|---|---|---|---|
| mpc_20261109_001243 | 2026-11-09 00:12 | mpc | configs/mpc_my_rig_transfer.json | results/sac_focused_policy.zip | 1 | 0.132 | 0.52 |
| mpc_20261109_001308 | 2026-11-09 00:13 | mpc | configs/mpc_my_rig_transfer.json | results/sac_focused_policy.zip | 1 | 0.351 | 2.5 |

## mpc_coupling_delay (2)

| run | when | algorithm | config | checkpoint | episodes | mean_balanced_frac | best_longest_balance_s |
|---|---|---|---|---|---|---|---|
| mpc_coupling_delay_20261107_031705 | 2026-11-07 03:17 | mpc | configs/mpc_my_rig_coupling_delay.json | results/sac_focused_policy.zip | 1 | 0.268 | 2.54 |
| mpc_coupling_delay_20261107_031732 | 2026-11-07 03:17 | mpc | configs/mpc_my_rig_coupling_delay.json | results/sac_focused_policy.zip | 1 | 0.337 | 1.96 |

## mpc_hw (3)

| run | when | algorithm | config | checkpoint | episodes | mean_balanced_frac | best_longest_balance_s |
|---|---|---|---|---|---|---|---|
| mpc_hw_20261107_031251 | 2026-11-07 03:12 | mpc | configs/mpc_my_rig.json | results/sac_focused_policy.zip | 1 | 0.013 | 0.04 |
| mpc_hw_20261107_031325 | 2026-11-07 03:13 | mpc | configs/mpc_my_rig.json | results/sac_focused_policy.zip | 1 | 0.181 | 1.14 |
| mpc_hw_20261107_031411 | 2026-11-07 03:14 | mpc | configs/mpc_my_rig.json | results/sac_focused_policy.zip | 1 | 0.16 | 1.0 |

## mpc_low_r (6)

| run | when | algorithm | config | checkpoint | episodes | mean_balanced_frac | best_longest_balance_s |
|---|---|---|---|---|---|---|---|
| mpc_low_r_20261107_153810 | 2026-11-07 15:38 | mpc | configs/mpc_my_rig_low_r.json | results/sac_focused_policy.zip | 1 | 0.055 | 0.44 |
| mpc_low_r_20261107_153838 | 2026-11-07 15:38 | mpc | configs/mpc_my_rig_low_r.json | results/sac_focused_policy.zip | 1 | 0.107 | 0.4 |
| mpc_low_r_20261107_153932 | 2026-11-07 15:39 | mpc | configs/mpc_my_rig_low_r.json | results/sac_focused_policy.zip | 1 | 0.04 | 0.2 |
| mpc_low_r_20261107_154431 | 2026-11-07 15:44 | mpc | configs/mpc_my_rig_low_r.json | results/sac_focused_policy.zip | 1 | 0.092 | 0.9 |
| mpc_low_r_20261107_154510 | 2026-11-07 15:45 | mpc | configs/mpc_my_rig_low_r.json | results/sac_focused_policy.zip | 1 | 0.213 | 1.4 |
| mpc_low_r_20261107_154540 | 2026-11-07 15:45 | mpc | configs/mpc_my_rig_low_r.json | results/sac_focused_policy.zip | 1 | 0.124 | 1.12 |

## mpc_strict_catch (10)

| run | when | algorithm | config | checkpoint | episodes | mean_balanced_frac | best_longest_balance_s |
|---|---|---|---|---|---|---|---|
| mpc_strict_catch_20261107_151727 | 2026-11-07 15:17 | mpc | configs/mpc_my_rig_strict_catch.json | results/sac_focused_policy.zip | 1 | 0.204 | 2.02 |
| mpc_strict_catch_20261107_151807 | 2026-11-07 15:18 | mpc | configs/mpc_my_rig_strict_catch.json | results/sac_focused_policy.zip | 1 |  |  |
| mpc_strict_catch_20261107_151820 | 2026-11-07 15:18 | mpc | configs/mpc_my_rig_strict_catch.json | results/sac_focused_policy.zip | 1 | 0.536 | 2.32 |
| mpc_strict_catch_20261107_151856 | 2026-11-07 15:18 | mpc | configs/mpc_my_rig_strict_catch.json | results/sac_focused_policy.zip | 1 | 0.12 | 1.08 |
| mpc_strict_catch_20261107_151926 | 2026-11-07 15:19 | mpc | configs/mpc_my_rig_strict_catch.json | results/sac_focused_policy.zip | 1 | 0.48 | 5.9 |
| mpc_strict_catch_20261107_152007 | 2026-11-07 15:20 | mpc | configs/mpc_my_rig_strict_catch.json | results/sac_focused_policy.zip | 1 | 0.0 | 0.0 |
| mpc_strict_catch_20261107_152024 | 2026-11-07 15:20 | mpc | configs/mpc_my_rig_strict_catch.json | results/sac_focused_policy.zip | 1 | 0.219 | 1.68 |
| mpc_strict_catch_20261107_152120 | 2026-11-07 15:21 | mpc | configs/mpc_my_rig_strict_catch.json | results/sac_focused_policy.zip | 1 | 0.285 | 1.52 |
| mpc_strict_catch_20261107_152222 | 2026-11-07 15:22 | mpc | configs/mpc_my_rig_strict_catch.json | results/sac_focused_policy.zip | 1 | 0.208 | 0.78 |
| mpc_strict_catch_20261107_152353 | 2026-11-07 15:23 | mpc | configs/mpc_my_rig_strict_catch.json | results/sac_focused_policy.zip | 1 |  |  |

## mpc_transfer (12)

| run | when | algorithm | config | checkpoint | episodes | successes | mean_balanced_frac | best_longest_balance_s |
|---|---|---|---|---|---|---|---|---|
| mpc_transfer_20261107_150201 | 2026-11-07 15:02 | mpc | configs/mpc_my_rig_transfer.json | results/sac_focused_policy.zip | 1 | 0 | 0.315 | 2.8 |
| mpc_transfer_20261107_150408 | 2026-11-07 15:04 | mpc | configs/mpc_my_rig_transfer.json | results/sac_focused_policy.zip | 1 | 0 | 0.216 | 0.98 |
| mpc_transfer_20261107_150624 | 2026-11-07 15:06 | mpc | configs/mpc_my_rig_transfer.json | results/sac_focused_policy.zip | 1 | 0 | 0.0 | 0.0 |
| mpc_transfer_20261107_150642 | 2026-11-07 15:06 | mpc | configs/mpc_my_rig_transfer.json | results/sac_focused_policy.zip | 1 | 0 |  |  |
| mpc_transfer_20261107_150748 | 2026-11-07 15:07 | mpc | configs/mpc_my_rig_transfer.json | results/sac_focused_policy.zip | 1 | 0 | 0.232 | 1.14 |
| mpc_transfer_20261107_150833 | 2026-11-07 15:08 | mpc | configs/mpc_my_rig_transfer.json | results/sac_focused_policy.zip | 1 | 0 | 0.125 | 0.56 |
| mpc_transfer_20261107_151046 | 2026-11-07 15:10 | mpc | configs/mpc_my_rig_transfer.json | results/sac_focused_policy.zip | 1 | 0 | 0.321 | 3.1 |
| mpc_transfer_20261107_155316 | 2026-11-07 15:53 | mpc | configs/mpc_my_rig_transfer.json | results/sac_focused_policy.zip | 1 | 0 |  |  |
| mpc_transfer_20261107_155325 | 2026-11-07 15:53 | mpc | configs/mpc_my_rig_transfer.json | results/sac_focused_policy.zip | 1 | 0 | 0.247 | 1.42 |
| mpc_transfer_20261107_155419 | 2026-11-07 15:54 | mpc | configs/mpc_my_rig_transfer.json | results/sac_focused_policy.zip | 1 | 0 | 0.384 | 2.6 |
| mpc_transfer_20261107_155533 | 2026-11-07 15:55 | mpc | configs/mpc_my_rig_transfer.json | results/sac_focused_policy.zip | 1 | 0 | 0.148 | 1.38 |
| mpc_transfer_20261107_155613 | 2026-11-07 15:56 | mpc | configs/mpc_my_rig_transfer.json | results/sac_focused_policy.zip | 1 | 1 | 0.716 | 10.66 |

## pid_lqr_match (7)

| run | when | algorithm | config | checkpoint | episodes | successes | mean_balanced_frac | best_longest_balance_s |
|---|---|---|---|---|---|---|---|---|
| pid_lqr_match_20261107_160634 | 2026-11-07 16:06 | pid | configs/pid_my_rig_lqr_match.json | results/sac_focused_policy.zip | 1 | 0 | 0.083 | 0.5 |
| pid_lqr_match_20261107_160701 | 2026-11-07 16:07 | pid | configs/pid_my_rig_lqr_match.json | results/sac_focused_policy.zip | 1 | 0 | 0.281 | 2.76 |
| pid_lqr_match_20261107_160734 | 2026-11-07 16:07 | pid | configs/pid_my_rig_lqr_match.json | results/sac_focused_policy.zip | 1 | 0 | 0.165 | 0.5 |
| pid_lqr_match_20261107_161502 | 2026-11-07 16:15 | pid | configs/pid_my_rig_lqr_match.json | results/sac_focused_policy.zip | 1 | 0 | 0.433 | 6.2 |
| pid_lqr_match_20261107_161536 | 2026-11-07 16:15 | pid | configs/pid_my_rig_lqr_match.json | results/sac_focused_policy.zip | 1 | 0 | 0.623 | 8.26 |
| pid_lqr_match_20261107_161611 | 2026-11-07 16:16 | pid | configs/pid_my_rig_lqr_match.json | results/sac_focused_policy.zip | 1 | 0 | 0.092 | 0.56 |
| pid_lqr_match_20261107_161650 | 2026-11-07 16:16 | pid | configs/pid_my_rig_lqr_match.json | results/sac_focused_policy.zip | 1 | 1 | 0.717 | 10.42 |

## pid_transfer (1)

| run | when | algorithm | config | checkpoint | episodes | mean_balanced_frac | best_longest_balance_s |
|---|---|---|---|---|---|---|---|
| pid_transfer_20261107_152516 | 2026-11-07 15:25 | pid | configs/pid_my_rig_transfer.json | results/sac_focused_policy.zip | 1 | 0.135 | 1.24 |

## ppo (1)

| run | when | algorithm | config | checkpoint | episodes | mean_balanced_frac | best_longest_balance_s |
|---|---|---|---|---|---|---|---|
| ppo_20261108_211833 | 2026-11-08 21:18 | ppo | configs/sac_my_rig.json | results/rig_rl_disturbance/ppo_long/policy.zip | 1 | 0.195 | 0.44 |

## ppo_ecB (4)

| run | when | algorithm | config | checkpoint | episodes | successes | mean_balanced_frac | best_longest_balance_s |
|---|---|---|---|---|---|---|---|---|
| ppo_ecB_20261109_012254 | 2026-11-09 01:22 | ppo | configs/sac_my_rig.json | curriculum/versions/ppo_ecB/policy.zip | 1 | 0 | 0.523 | 7.84 |
| ppo_ecB_20261109_012337 | 2026-11-09 01:23 | ppo | configs/sac_my_rig.json | curriculum/versions/ppo_ecB/policy.zip | 1 | 1 | 0.901 | 13.52 |
| ppo_ecB_20261109_012428 | 2026-11-09 01:24 | ppo | configs/sac_my_rig.json | curriculum/versions/ppo_ecB/policy.zip | 1 | 0 | 0.0 | 0.0 |
| ppo_ecB_20261109_012444 | 2026-11-09 01:24 | ppo | configs/sac_my_rig.json | curriculum/versions/ppo_ecB/policy.zip | 1 | 0 | 0.008 | 0.04 |

## ppo_ecC (2)

| run | when | algorithm | config | checkpoint | episodes |
|---|---|---|---|---|---|
| ppo_ecC_20261109_012103 | 2026-11-09 01:21 | ppo | configs/sac_my_rig.json | curriculum/versions/ppo_ecC/policy.zip | 1 |
| ppo_ecC_20261109_012112 | 2026-11-09 01:21 | ppo | configs/sac_my_rig.json | curriculum/versions/ppo_ecC/policy.zip | 1 |

## ppo_ecF (2)

| run | when | algorithm | config | checkpoint | episodes | mean_balanced_frac | best_longest_balance_s |
|---|---|---|---|---|---|---|---|
| ppo_ecF_20261109_013006 | 2026-11-09 01:30 | ppo | configs/sac_my_rig.json | curriculum/versions/ppo_ecF/policy.zip | 1 | 0.436 | 4.3 |
| ppo_ecF_20261109_013045 | 2026-11-09 01:30 | ppo | configs/sac_my_rig.json | curriculum/versions/ppo_ecF/policy.zip | 1 | 0.409 | 3.84 |

## ppo_ecG (2)

| run | when | algorithm | config | checkpoint | episodes | successes | mean_balanced_frac | best_longest_balance_s |
|---|---|---|---|---|---|---|---|---|
| ppo_ecG_20261109_013444 | 2026-11-09 01:34 | ppo | configs/sac_my_rig.json | curriculum/versions/ppo_ecG/policy.zip | 1 | 0 | 0.335 | 2.82 |
| ppo_ecG_20261109_013508 | 2026-11-09 01:35 | ppo | configs/sac_my_rig.json | curriculum/versions/ppo_ecG/policy.zip | 1 | 1 | 0.876 | 13.14 |

## ppo_long (3)

| run | when | algorithm | config | checkpoint | episodes | successes | mean_balanced_frac | best_longest_balance_s |
|---|---|---|---|---|---|---|---|---|
| ppo_long_20261109_011005 | 2026-11-09 01:10 | ppo | configs/sac_my_rig.json | results/rig_rl_disturbance/ppo_long/policy.zip | 1 | 1 | 0.9 | 13.5 |
| ppo_long_20261109_011116 | 2026-11-09 01:11 | ppo | configs/sac_my_rig.json | results/rig_rl_disturbance/ppo_long/policy.zip | 1 | 0 | 0.015 | 0.22 |
| ppo_long_20261109_011145 | 2026-11-09 01:11 | ppo | configs/sac_my_rig.json | results/rig_rl_disturbance/ppo_long/policy.zip | 1 | 0 | 0.05 | 0.24 |

## ppo_rig (1)

| run | when | algorithm | config | checkpoint | episodes | mean_balanced_frac | best_longest_balance_s |
|---|---|---|---|---|---|---|---|
| ppo_rig_20261107_175250 | 2026-11-07 17:52 | ppo | configs/sac_my_rig.json | results/rig_rl_disturbance/ppo_long/policy.zip | 1 | 0.156 | 1.04 |

## ppo_rn (1)

| run | when | algorithm | config | checkpoint | episodes | mean_balanced_frac | best_longest_balance_s |
|---|---|---|---|---|---|---|---|
| ppo_rn_20261109_010227 | 2026-11-09 01:02 | ppo | configs/sac_my_rig.json | curriculum/versions/ppo_rn/policy.zip | 1 | 0.067 | 0.18 |

## ppo_rn05 (5)

| run | when | algorithm | config | checkpoint | episodes | mean_balanced_frac | best_longest_balance_s |
|---|---|---|---|---|---|---|---|
| ppo_rn05_20261109_010852 | 2026-11-09 01:08 | ppo | configs/sac_my_rig.json | curriculum/versions/ppo_rn05/policy.zip | 1 | 0.0 | 0.0 |
| ppo_rn05_20261109_152704 | 2026-11-09 15:27 | ppo | configs/sac_my_rig.json | curriculum/versions/ppo_rn05/policy.zip | 1 | 0.777 | 8.24 |
| ppo_rn05_20261109_152854 | 2026-11-09 15:28 | ppo | configs/sac_my_rig.json | curriculum/versions/ppo_rn05/policy.zip | 1 | 0.527 | 2.4 |
| ppo_rn05_20261109_153025 | 2026-11-09 15:30 | ppo | configs/sac_my_rig.json | curriculum/versions/ppo_rn05/policy.zip | 1 |  |  |
| ppo_rn05_20261109_153032 | 2026-11-09 15:30 | ppo | configs/sac_my_rig.json | curriculum/versions/ppo_rn05/policy.zip | 1 | 0.316 | 2.1 |

## report_sim_eval (11)

| run | when | algorithm | config | checkpoint | episodes | successes | mean_balanced_frac | best_longest_balance_s |
|---|---|---|---|---|---|---|---|---|
| report_sim_eval/seed0/dqn | 2026-11-09 10:41 (mtime) | dqn | configs/sac_my_rig.json | results/rig_rl_disturbance/dqn_rn05/policy.zip | 1 | 1 | 0.845 | 12.68 |
| report_sim_eval/seed0/ilqr | 2026-11-09 10:41 (mtime) | ilqr | configs/ilqr_my_rig_lqr_match.json | results/sac_focused_policy.zip | 1 | 1 | 0.859 | 12.88 |
| report_sim_eval/seed0/lqr | 2026-11-09 10:41 (mtime) | lqr | configs/lqr_my_rig_coupling_delay.json | results/sac_focused_policy.zip | 1 | 1 | 0.859 | 12.88 |
| report_sim_eval/seed0/mpc | 2026-11-09 10:41 (mtime) | mpc | configs/mpc_my_rig_transfer.json | results/sac_focused_policy.zip | 1 | 1 | 0.859 | 12.88 |
| report_sim_eval/seed0/pid | 2026-11-09 10:41 (mtime) | pid | configs/pid_my_rig_lqr_match.json | results/sac_focused_policy.zip | 1 | 1 | 0.859 | 12.88 |
| report_sim_eval/seed0/ppo | 2026-11-09 10:41 (mtime) | ppo | configs/sac_my_rig.json | results/rig_rl_disturbance/ppo_ecG/policy.zip | 1 | 1 | 0.88 | 13.2 |
| report_sim_eval/seed0/sac | 2026-11-09 10:41 (mtime) | sac | configs/sac_my_rig.json | results/rig_rl_disturbance/sac_rnA_reward_only/policy.zip | 1 | 1 | 0.856 | 12.84 |
| report_sim_eval/upright/pid | 2026-11-09 10:42 (mtime) | pid | configs/pid_my_rig_lqr_match.json | results/sac_focused_policy.zip | 20 | 15 | 0.744 | 15.0 |
| report_sim_eval/upright/ilqr | 2026-11-09 10:43 (mtime) | ilqr | configs/ilqr_my_rig_lqr_match.json | results/sac_focused_policy.zip | 20 | 15 | 0.744 | 15.0 |
| report_sim_eval/upright/lqr | 2026-11-09 10:43 (mtime) | lqr | configs/lqr_my_rig_coupling_delay.json | results/sac_focused_policy.zip | 20 | 15 | 0.744 | 15.0 |
| report_sim_eval/upright/mpc | 2026-11-09 10:43 (mtime) | mpc | configs/mpc_my_rig_transfer.json | results/sac_focused_policy.zip | 20 | 15 | 0.744 | 15.0 |

## rig_sac_P1alt (1)

| run | when | checkpoint | episodes | successes | mean_balanced_frac | best_longest_balance_s |
|---|---|---|---|---|---|---|
| rig_sac_P1alt_20261107_215321 | 2026-11-07 21:53 | sac_finetune/P1/policy.zip | 12 | 2 | 0.207 | 13.2 |

## rig_sac_eval (1)

| run | when | checkpoint | episodes | mean_balanced_frac | best_longest_balance_s |
|---|---|---|---|---|---|
| rig_sac_eval_20261107_212337 | 2026-11-07 21:23 | sac_finetune/V1/policy.zip | 3 | 0.114 | 0.9 |

## rig_sac_evalP1 (1)

| run | when | checkpoint | episodes | mean_balanced_frac | best_longest_balance_s |
|---|---|---|---|---|---|
| rig_sac_evalP1_20261107_212700 | 2026-11-07 21:27 | sac_finetune/P1/policy.zip | 3 | 0.186 | 2.44 |

## rig_sac_pilot (1)

| run | when | checkpoint | episodes | successes | mean_balanced_frac | best_longest_balance_s | has_policy | mb_pruned |
|---|---|---|---|---|---|---|---|---|
| rig_sac_pilot_20261107_214524 | 2026-11-07 21:45 | sac_finetune/P1/policy.zip | 20 | 1 | 0.315 | 12.38 | 1 | 2162.06 |

## sac_A (3)

| run | when | algorithm | config | checkpoint | episodes | mean_balanced_frac | best_longest_balance_s |
|---|---|---|---|---|---|---|---|
| sac_A_20261107_171816 | 2026-11-07 17:18 | sac | configs/sac_my_rig.json | sac_real_starts/A/policy.zip | 1 | 0.165 | 0.4 |
| sac_A_20261107_171906 | 2026-11-07 17:19 | sac | configs/sac_my_rig.json | sac_real_starts/A/policy.zip | 1 | 0.165 | 0.8 |
| sac_A_20261107_171940 | 2026-11-07 17:19 | sac | configs/sac_my_rig.json | sac_real_starts/A/policy.zip | 1 | 0.359 | 1.8 |

## sac_D (3)

| run | when | algorithm | config | checkpoint | episodes | mean_balanced_frac | best_longest_balance_s |
|---|---|---|---|---|---|---|---|
| sac_D_20261107_172455 | 2026-11-07 17:24 | sac | configs/sac_my_rig.json | sac_real_starts/D/policy.zip | 1 | 0.053 | 0.52 |
| sac_D_20261107_172520 | 2026-11-07 17:25 | sac | configs/sac_my_rig.json | sac_real_starts/D/policy.zip | 1 | 0.087 | 0.24 |
| sac_D_20261107_172552 | 2026-11-07 17:25 | sac | configs/sac_my_rig.json | sac_real_starts/D/policy.zip | 1 | 0.064 | 0.5 |

## sac_F (3)

| run | when | algorithm | config | checkpoint | episodes | mean_balanced_frac | best_longest_balance_s |
|---|---|---|---|---|---|---|---|
| sac_F_20261107_174757 | 2026-11-07 17:47 | sac | configs/sac_my_rig.json | sac_real_starts/F/policy.zip | 1 | 0.115 | 0.84 |
| sac_F_20261107_174832 | 2026-11-07 17:48 | sac | configs/sac_my_rig.json | sac_real_starts/F/policy.zip | 1 | 0.065 | 0.22 |
| sac_F_20261107_174915 | 2026-11-07 17:49 | sac | configs/sac_my_rig.json | sac_real_starts/F/policy.zip | 1 | 0.163 | 1.2 |

## sac_J (1)

| run | when | algorithm | config | checkpoint | episodes |
|---|---|---|---|---|---|
| sac_J_20261107_181415 | 2026-11-07 18:14 | sac | configs/sac_my_rig.json | sac_residual/J/policy.zip | 1 |

## sac_P1 (1)

| run | when | algorithm | config | checkpoint | episodes | successes | mean_balanced_frac | best_longest_balance_s |
|---|---|---|---|---|---|---|---|---|
| sac_P1_20261107_215833 | 2026-11-07 21:58 | sac | configs/sac_my_rig.json | sac_finetune/P1/policy.zip | 1 | 1 | 0.793 | 11.68 |

## sac_R50 (3)

| run | when | algorithm | config | checkpoint | episodes | mean_balanced_frac | best_longest_balance_s |
|---|---|---|---|---|---|---|---|
| sac_R50_20261107_193102 | 2026-11-07 19:31 | sac | configs/sac_my_rig.json | sac_finetune/R50/policy.zip | 1 | 0.181 | 1.22 |
| sac_R50_20261107_193130 | 2026-11-07 19:31 | sac | configs/sac_my_rig.json | sac_finetune/R50/policy.zip | 1 | 0.155 | 0.7 |
| sac_R50_20261107_193234 | 2026-11-07 19:32 | sac | configs/sac_my_rig.json | sac_finetune/R50/policy.zip | 1 | 0.071 | 0.28 |

## sac_V1 (4)

| run | when | algorithm | config | checkpoint | episodes | mean_balanced_frac | best_longest_balance_s |
|---|---|---|---|---|---|---|---|
| sac_V1_20261107_195208 | 2026-11-07 19:52 | sac | configs/sac_my_rig.json | sac_finetune/V1/policy.zip | 1 | 0.164 | 0.92 |
| sac_V1_20261107_195234 | 2026-11-07 19:52 | sac | configs/sac_my_rig.json | sac_finetune/V1/policy.zip | 1 | 0.345 | 2.14 |
| sac_V1_20261107_195307 | 2026-11-07 19:53 | sac | configs/sac_my_rig.json | sac_finetune/V1/policy.zip | 1 | 0.193 | 1.78 |
| sac_V1_20261107_195523 | 2026-11-07 19:55 | sac | configs/sac_my_rig.json | sac_finetune/V1/policy.zip | 1 | 0.071 | 0.58 |

## sac_W1 (3)

| run | when | algorithm | config | checkpoint | episodes | mean_balanced_frac | best_longest_balance_s |
|---|---|---|---|---|---|---|---|
| sac_W1_20261107_205620 | 2026-11-07 20:56 | sac | configs/sac_my_rig.json | sac_finetune/W_rig/W1_100k.zip | 1 | 0.125 | 0.36 |
| sac_W1_20261107_205756 | 2026-11-07 20:57 | sac | configs/sac_my_rig.json | sac_finetune/W_rig/W1_100k.zip | 1 | 0.135 | 0.7 |
| sac_W1_20261107_205831 | 2026-11-07 20:58 | sac | configs/sac_my_rig.json | sac_finetune/W_rig/W1_100k.zip | 1 | 0.124 | 0.38 |

## sac_W2 (4)

| run | when | algorithm | config | checkpoint | episodes | mean_balanced_frac | best_longest_balance_s |
|---|---|---|---|---|---|---|---|
| sac_W2_20261107_205257 | 2026-11-07 20:52 | sac | configs/sac_my_rig.json | sac_finetune/W_rig/W2_100k.zip | 1 | 0.171 | 1.22 |
| sac_W2_20261107_205333 | 2026-11-07 20:53 | sac | configs/sac_my_rig.json | sac_finetune/W_rig/W2_100k.zip | 1 | 0.211 | 1.9 |
| sac_W2_20261107_205437 | 2026-11-07 20:54 | sac | configs/sac_my_rig.json | sac_finetune/W_rig/W2_100k.zip | 1 | 0.019 | 0.16 |
| sac_W2_20261107_205545 | 2026-11-07 20:55 | sac | configs/sac_my_rig.json | sac_finetune/W_rig/W2_100k.zip | 1 | 0.015 | 0.1 |

## sac_finetune (7)

| run | when | source | method | steps | has_policy | mb_pruned |
|---|---|---|---|---|---|---|
| sac_finetune/R25 | 2026-11-07 18:40 (mtime) | results/rig_rl_disturbance/sac_long/policy.zip | RLPD-style mixed replay: SAC updates on half hardware, half simulator transitions | 300000 | 1 | 11.16 |
| sac_finetune/R50 | 2026-11-07 18:40 (mtime) | results/rig_rl_disturbance/sac_long/policy.zip | RLPD-style mixed replay: SAC updates on half hardware, half simulator transitions | 300000 | 1 | 11.16 |
| sac_finetune/V1 | 2026-11-07 19:50 (mtime) | results/rig_rl_disturbance/sac_long/policy.zip | RLPD-style mixed replay: SAC updates on half hardware, half simulator transitions | 600000 | 1 | 11.16 |
| sac_finetune/V2 | 2026-11-07 19:50 (mtime) | sac_finetune/R50/policy.zip | RLPD-style mixed replay: SAC updates on half hardware, half simulator transitions | 600000 | 1 | 11.16 |
| sac_finetune/W1 | 2026-11-07 20:58 (mtime) | sac_finetune/V1/policy.zip | RLPD-style mixed replay: SAC updates on half hardware, half simulator transitions | 600000 | 1 | 5.58 |
| sac_finetune/W2 | 2026-11-07 20:58 (mtime) | results/rig_rl_disturbance/sac_long/policy.zip | RLPD-style mixed replay: SAC updates on half hardware, half simulator transitions | 600000 | 1 | 5.58 |
| sac_finetune/P1 | 2026-11-07 21:26 (mtime) | sac_finetune/V1/policy.zip |  | 4000 | 1 | 0.0 |

## sac_real_starts (9)

| run | when | source | has_policy | mb_pruned |
|---|---|---|---|---|
| sac_real_starts/A | 2026-11-07 17:11 (mtime) | results/rig_rl_disturbance/sac_long/policy.zip | 1 | 14.87 |
| sac_real_starts/B | 2026-11-07 17:11 (mtime) | results/rig_rl_disturbance/sac_long/policy.zip | 1 | 14.87 |
| sac_real_starts/C | 2026-11-07 17:12 (mtime) | results/rig_rl_disturbance/sac_long/policy.zip | 1 | 14.87 |
| sac_real_starts/D | 2026-11-07 17:23 (mtime) | sac_real_starts/A/policy.zip | 1 | 11.15 |
| sac_real_starts/E | 2026-11-07 17:23 (mtime) | sac_real_starts/C/policy.zip | 1 | 11.15 |
| sac_real_starts/F | 2026-11-07 17:29 (mtime) | sac_real_starts/D/policy.zip | 1 | 11.15 |
| sac_real_starts/G | 2026-11-07 17:29 (mtime) | sac_real_starts/D/policy.zip | 1 | 11.15 |
| sac_real_starts/H | 2026-11-07 17:40 (mtime) | sac_real_starts/A/policy.zip | 1 | 14.87 |
| sac_real_starts/I | 2026-11-07 17:40 (mtime) | sac_real_starts/D/policy.zip | 1 | 14.87 |

## sac_residual (5)

| run | when | source | has_policy | mb_pruned |
|---|---|---|---|---|
| sac_residual/J | 2026-11-07 18:11 (mtime) | results/rig_rl_disturbance/sac_long/policy.zip | 1 | 18.58 |
| sac_residual/K | 2026-11-07 18:11 (mtime) | sac_real_starts/A/policy.zip | 1 | 18.58 |
| sac_residual/L | 2026-11-07 18:13 (mtime) | sac_real_starts/F/policy.zip | 1 | 18.58 |
| sac_residual/M | 2026-11-07 18:28 (mtime) | results/rig_rl_disturbance/sac_long/policy.zip | 1 | 22.3 |
| sac_residual/N | 2026-11-07 18:29 (mtime) | sac_real_starts/F/policy.zip | 1 | 22.3 |

## sac_rig (3)

| run | when | algorithm | config | checkpoint | episodes | mean_balanced_frac | best_longest_balance_s |
|---|---|---|---|---|---|---|---|
| sac_rig_20261107_165548 | 2026-11-07 16:55 | sac | configs/sac_my_rig.json | results/rig_rl_disturbance/sac_long/policy.zip | 1 | 0.22 | 0.82 |
| sac_rig_20261107_165619 | 2026-11-07 16:56 | sac | configs/sac_my_rig.json | results/rig_rl_disturbance/sac_long/policy.zip | 1 | 0.167 | 0.78 |
| sac_rig_20261107_165745 | 2026-11-07 16:57 | sac | configs/sac_my_rig.json | results/rig_rl_disturbance/sac_long/policy.zip | 1 | 0.119 | 0.88 |

## sac_rig_disturbance (4)

| run | when | algorithm | config | checkpoint | episodes | mean_balanced_frac | best_longest_balance_s |
|---|---|---|---|---|---|---|---|
| sac_rig_disturbance_20261107_163311 | 2026-11-07 16:33 | sac | configs/sac_my_rig.json | results/rig_rl_disturbance/sac_long/policy.zip | 1 | 0.207 | 1.5 |
| sac_rig_disturbance_20261107_163340 | 2026-11-07 16:33 | sac | configs/sac_my_rig.json | results/rig_rl_disturbance/sac_long/policy.zip | 1 | 0.133 | 0.96 |
| sac_rig_disturbance_20261107_163412 | 2026-11-07 16:34 | sac | configs/sac_my_rig.json | results/rig_rl_disturbance/sac_long/policy.zip | 1 | 0.0 | 0.0 |
| sac_rig_disturbance_20261107_163427 | 2026-11-07 16:34 | sac | configs/sac_my_rig.json | results/rig_rl_disturbance/sac_long/policy.zip | 1 | 0.085 | 0.84 |

## sac_rnA (15)

| run | when | algorithm | config | checkpoint | episodes | successes | mean_balanced_frac | best_longest_balance_s |
|---|---|---|---|---|---|---|---|---|
| sac_rnA_20261109_000758 | 2026-11-09 00:07 | sac | configs/sac_my_rig.json | curriculum/versions/rnA/policy.zip | 1 | 0 | 0.204 | 1.2 |
| sac_rnA_20261109_004522 | 2026-11-09 00:45 | sac | configs/sac_my_rig.json | curriculum/versions/rnA/policy.zip | 1 | 0 |  |  |
| sac_rnA_20261109_004614 | 2026-11-09 00:46 | sac | configs/sac_my_rig.json | curriculum/versions/rnA/policy.zip | 1 | 0 | 0.852 | 12.78 |
| sac_rnA_20261109_004642 | 2026-11-09 00:46 | sac | configs/sac_my_rig.json | curriculum/versions/rnA/policy.zip | 1 | 1 | 0.879 | 13.18 |
| sac_rnA_20261109_004713 | 2026-11-09 00:47 | sac | configs/sac_my_rig.json | curriculum/versions/rnA/policy.zip | 1 | 1 | 0.875 | 13.12 |
| sac_rnA_20261109_011649 | 2026-11-09 01:16 | sac | configs/sac_my_rig.json | curriculum/versions/rnA/policy.zip | 1 | 0 | 0.793 | 7.36 |
| sac_rnA_20261109_141042 | 2026-11-09 14:10 | sac | configs/sac_my_rig.json | results/rig_rl_disturbance/sac_rnA_reward_only/policy.zip | 1 | 0 | 0.752 | 5.88 |
| sac_rnA_20261109_141112 | 2026-11-09 14:11 | sac | configs/sac_my_rig.json | results/rig_rl_disturbance/sac_rnA_reward_only/policy.zip | 1 | 0 | 0.811 | 9.14 |
| sac_rnA_20261109_152209 | 2026-11-09 15:22 | sac | configs/sac_my_rig.json | results/rig_rl_disturbance/sac_rnA_reward_only/policy.zip | 1 | 0 | 0.589 | 2.04 |
| sac_rnA_20261109_152246 | 2026-11-09 15:22 | sac | configs/sac_my_rig.json | results/rig_rl_disturbance/sac_rnA_reward_only/policy.zip | 1 | 0 | 0.835 | 11.04 |
| sac_rnA_20261109_152508 | 2026-11-09 15:25 | sac | configs/sac_my_rig.json | results/rig_rl_disturbance/sac_rnA_reward_only/policy.zip | 1 | 0 | 0.794 | 7.44 |
| sac_rnA_20261109_152757 | 2026-11-09 15:27 | sac | configs/sac_my_rig.json | results/rig_rl_disturbance/sac_rnA_reward_only/policy.zip | 1 | 0 | 0.907 | 22.12 |
| sac_rnA_20261109_152938 | 2026-11-09 15:29 | sac | configs/sac_my_rig.json | results/rig_rl_disturbance/sac_rnA_reward_only/policy.zip | 1 | 0 | 0.833 | 8.32 |
| sac_rnA_20261109_160034 | 2026-11-09 16:00 | sac | configs/sac_my_rig.json | results/rig_rl_disturbance/sac_rnA_reward_only/policy.zip | 1 | 1 | 0.938 | 28.14 |
| sac_rnA_20261109_160131 | 2026-11-09 16:01 | sac | configs/sac_my_rig.json | results/rig_rl_disturbance/sac_rnA_reward_only/policy.zip | 1 | 0 | 0.701 | 4.3 |

## sac_robustness (1)

| run | when | has_policy |
|---|---|---|
| sac_robustness_20261016/train | 2026-10-16 | 1 |

## sac_s01e15 (1)

| run | when | algorithm | config | checkpoint | episodes | mean_balanced_frac | best_longest_balance_s |
|---|---|---|---|---|---|---|---|
| sac_s01e15_20261108_225049 | 2026-11-08 22:50 | sac | configs/sac_my_rig.json | curriculum/versions/s01e15/policy.zip | 1 | 0.048 | 0.32 |

## sac_s01e17 (1)

| run | when | algorithm | config | checkpoint | episodes | mean_balanced_frac | best_longest_balance_s |
|---|---|---|---|---|---|---|---|
| sac_s01e17_20261108_225115 | 2026-11-08 22:51 | sac | configs/sac_my_rig.json | curriculum/versions/s01e17/policy.zip | 1 | 0.005 | 0.06 |

## sac_s01e49 (11)

| run | when | algorithm | config | checkpoint | episodes | mean_balanced_frac | best_longest_balance_s |
|---|---|---|---|---|---|---|---|
| sac_s01e49_20261108_224208 | 2026-11-08 22:42 | sac | configs/sac_my_rig.json | curriculum/versions/s01e49/policy.zip | 1 | 0.252 | 2.64 |
| sac_s01e49_20261108_224243 | 2026-11-08 22:42 | sac | configs/sac_my_rig.json | curriculum/versions/s01e49/policy.zip | 1 | 0.353 | 3.92 |
| sac_s01e49_20261108_224312 | 2026-11-08 22:43 | sac | configs/sac_my_rig.json | curriculum/versions/s01e49/policy.zip | 1 | 0.027 | 0.16 |
| sac_s01e49_20261108_224419 | 2026-11-08 22:44 | sac | configs/sac_my_rig.json | curriculum/versions/s01e49/policy.zip | 1 | 0.68 | 9.72 |
| sac_s01e49_20261108_224446 | 2026-11-08 22:44 | sac | configs/sac_my_rig.json | curriculum/versions/s01e49/policy.zip | 1 | 0.351 | 4.16 |
| sac_s01e49_20261108_224532 | 2026-11-08 22:45 | sac | configs/sac_my_rig.json | curriculum/versions/s01e49/policy.zip | 1 | 0.147 | 0.28 |
| sac_s01e49_20261108_224558 | 2026-11-08 22:45 | sac | configs/sac_my_rig.json | curriculum/versions/s01e49/policy.zip | 1 |  |  |
| sac_s01e49_20261108_224609 | 2026-11-08 22:46 | sac | configs/sac_my_rig.json | curriculum/versions/s01e49/policy.zip | 1 | 0.423 | 5.7 |
| sac_s01e49_20261108_224635 | 2026-11-08 22:46 | sac | configs/sac_my_rig.json | curriculum/versions/s01e49/policy.zip | 1 | 0.107 | 0.28 |
| sac_s01e49_20261108_224712 | 2026-11-08 22:47 | sac | configs/sac_my_rig.json | curriculum/versions/s01e49/policy.zip | 1 | 0.187 | 1.12 |
| sac_s01e49_20261108_224747 | 2026-11-08 22:47 | sac | configs/sac_my_rig.json | curriculum/versions/s01e49/policy.zip | 1 | 0.076 | 0.34 |

## sac_v2m2 (10)

| run | when | algorithm | config | checkpoint | episodes | mean_balanced_frac | best_longest_balance_s |
|---|---|---|---|---|---|---|---|
| sac_v2m2_20261108_031813 | 2026-11-08 03:18 | sac | configs/sac_my_rig.json | curriculum/versions/v2m2_runner/policy.zip | 1 | 0.484 | 6.36 |
| sac_v2m2_20261108_031843 | 2026-11-08 03:18 | sac | configs/sac_my_rig.json | curriculum/versions/v2m2_runner/policy.zip | 1 | 0.063 | 0.46 |
| sac_v2m2_20261108_031940 | 2026-11-08 03:19 | sac | configs/sac_my_rig.json | curriculum/versions/v2m2_runner/policy.zip | 1 | 0.035 | 0.14 |
| sac_v2m2_20261108_032011 | 2026-11-08 03:20 | sac | configs/sac_my_rig.json | curriculum/versions/v2m2_runner/policy.zip | 1 | 0.56 | 7.8 |
| sac_v2m2_20261108_032046 | 2026-11-08 03:20 | sac | configs/sac_my_rig.json | curriculum/versions/v2m2_runner/policy.zip | 1 | 0.063 | 0.48 |
| sac_v2m2_20261108_032124 | 2026-11-08 03:21 | sac | configs/sac_my_rig.json | curriculum/versions/v2m2_runner/policy.zip | 1 | 0.121 | 1.06 |
| sac_v2m2_20261108_032220 | 2026-11-08 03:22 | sac | configs/sac_my_rig.json | curriculum/versions/v2m2_runner/policy.zip | 1 | 0.139 | 1.9 |
| sac_v2m2_20261108_032304 | 2026-11-08 03:23 | sac | configs/sac_my_rig.json | curriculum/versions/v2m2_runner/policy.zip | 1 | 0.304 | 3.24 |
| sac_v2m2_20261108_032334 | 2026-11-08 03:23 | sac | configs/sac_my_rig.json | curriculum/versions/v2m2_runner/policy.zip | 1 | 0.195 | 1.12 |
| sac_v2m2_20261108_032404 | 2026-11-08 03:24 | sac | configs/sac_my_rig.json | curriculum/versions/v2m2_runner/policy.zip | 1 | 0.093 | 0.4 |

## sac_v3b (7)

| run | when | algorithm | config | checkpoint | episodes | mean_balanced_frac | best_longest_balance_s |
|---|---|---|---|---|---|---|---|
| sac_v3b_20261108_034118 | 2026-11-08 03:41 | sac | configs/sac_my_rig.json | curriculum/versions/v3b_runner/policy.zip | 1 | 0.12 | 0.58 |
| sac_v3b_20261108_034146 | 2026-11-08 03:41 | sac | configs/sac_my_rig.json | curriculum/versions/v3b_runner/policy.zip | 1 | 0.221 | 1.34 |
| sac_v3b_20261108_034214 | 2026-11-08 03:42 | sac | configs/sac_my_rig.json | curriculum/versions/v3b_runner/policy.zip | 1 | 0.317 | 2.9 |
| sac_v3b_20261108_035529 | 2026-11-08 03:55 | sac | configs/sac_my_rig.json | curriculum/versions/v3b_runner/policy.zip | 1 | 0.483 | 6.58 |
| sac_v3b_20261108_035609 | 2026-11-08 03:56 | sac | configs/sac_my_rig.json | curriculum/versions/v3b_runner/policy.zip | 1 | 0.253 | 1.1 |
| sac_v3b_20261108_035635 | 2026-11-08 03:56 | sac | configs/sac_my_rig.json | curriculum/versions/v3b_runner/policy.zip | 1 | 0.211 | 1.5 |
| sac_v3b_20261108_035701 | 2026-11-08 03:57 | sac | configs/sac_my_rig.json | curriculum/versions/v3b_runner/policy.zip | 1 | 0.095 | 0.52 |

## sac_v3c (1)

| run | when | algorithm | config | checkpoint | episodes | mean_balanced_frac | best_longest_balance_s |
|---|---|---|---|---|---|---|---|
| sac_v3c_20261108_035738 | 2026-11-08 03:57 | sac | configs/sac_my_rig.json | curriculum/versions/v3c_runner/policy.zip | 1 | 0.073 | 0.4 |

## sac_v6b (14)

| run | when | algorithm | config | checkpoint | episodes | mean_balanced_frac | best_longest_balance_s |
|---|---|---|---|---|---|---|---|
| sac_v6b_20261108_042032 | 2026-11-08 04:20 | sac | configs/sac_my_rig.json | curriculum/versions/v6b_runner/policy.zip | 1 | 0.356 | 4.7 |
| sac_v6b_20261108_042058 | 2026-11-08 04:20 | sac | configs/sac_my_rig.json | curriculum/versions/v6b_runner/policy.zip | 1 | 0.141 | 0.72 |
| sac_v6b_20261108_042124 | 2026-11-08 04:21 | sac | configs/sac_my_rig.json | curriculum/versions/v6b_runner/policy.zip | 1 | 0.159 | 0.58 |
| sac_v6b_20261108_211221 | 2026-11-08 21:12 | sac | configs/sac_my_rig.json | curriculum/versions/v6b_runner/policy.zip | 1 |  |  |
| sac_v6b_20261108_211227 | 2026-11-08 21:12 | sac | configs/sac_my_rig.json | curriculum/versions/v6b_runner/policy.zip | 1 | 0.333 | 1.4 |
| sac_v6b_20261108_211302 | 2026-11-08 21:13 | sac | configs/sac_my_rig.json | curriculum/versions/v6b_runner/policy.zip | 1 | 0.22 | 1.48 |
| sac_v6b_20261108_211745 | 2026-11-08 21:17 | sac | configs/sac_my_rig.json | curriculum/versions/v6b_runner/policy.zip | 1 | 0.201 | 2.06 |
| sac_v6b_20261108_211936 | 2026-11-08 21:19 | sac | configs/sac_my_rig.json | curriculum/versions/v6b_runner/policy.zip | 1 | 0.177 | 1.06 |
| sac_v6b_20261108_224816 | 2026-11-08 22:48 | sac | configs/sac_my_rig.json | curriculum/versions/v6b_runner/policy.zip | 1 | 0.067 | 0.34 |
| sac_v6b_20261108_224841 | 2026-11-08 22:48 | sac | configs/sac_my_rig.json | curriculum/versions/v6b_runner/policy.zip | 1 | 0.087 | 0.38 |
| sac_v6b_20261108_224912 | 2026-11-08 22:49 | sac | configs/sac_my_rig.json | curriculum/versions/v6b_runner/policy.zip | 1 | 0.2 | 1.16 |
| sac_v6b_20261108_224947 | 2026-11-08 22:49 | sac | configs/sac_my_rig.json | curriculum/versions/v6b_runner/policy.zip | 1 | 0.261 | 1.62 |
| sac_v6b_20261108_225013 | 2026-11-08 22:50 | sac | configs/sac_my_rig.json | curriculum/versions/v6b_runner/policy.zip | 1 | 0.0 | 0.0 |
| sac_v6b_20261108_225036 | 2026-11-08 22:50 | sac | configs/sac_my_rig.json | curriculum/versions/v6b_runner/policy.zip | 1 |  |  |

## seed0_local (4)

| run | when | algorithm | config | checkpoint | episodes | successes | mean_balanced_frac | best_longest_balance_s |
|---|---|---|---|---|---|---|---|---|
| seed0_local/ilqr | 2026-11-09 10:52 (mtime) | ilqr | configs/ilqr_my_rig_lqr_match.json | results/sac_focused_policy.zip | 1 | 1 | 0.859 | 12.88 |
| seed0_local/lqr | 2026-11-09 10:52 (mtime) | lqr | configs/lqr_my_rig_coupling_delay.json | results/sac_focused_policy.zip | 1 | 1 | 0.859 | 12.88 |
| seed0_local/pid | 2026-11-09 10:52 (mtime) | pid | configs/pid_my_rig_lqr_match.json | results/sac_focused_policy.zip | 1 | 1 | 0.859 | 12.88 |
| seed0_local/mpc | 2026-11-09 10:53 (mtime) | mpc | configs/mpc_my_rig_transfer.json | results/sac_focused_policy.zip | 1 | 1 | 0.859 | 12.88 |

## sysid_holdout (1)

| run | when |
|---|---|
| sysid_holdout_01 | 2026-11-06 21:15 (mtime) |

## sysid_motor_envelope (1)

| run | when | episodes |
|---|---|---|
| sysid_motor_envelope_20261107_025411 | 2026-11-07 02:54 | 1 |

## sysid_train (1)

| run | when |
|---|---|
| sysid_train_01 | 2026-11-06 21:12 (mtime) |

## transfer_check (4)

| run | when | algorithm | config | checkpoint | episodes | successes | mean_balanced_frac | best_longest_balance_s |
|---|---|---|---|---|---|---|---|---|
| transfer_check_20261107_142954/ilqr | 2026-11-07 14:29 | ilqr | configs/ilqr_my_rig_transfer.json | results/sac_focused_policy.zip | 5 | 5 | 0.859 | 12.88 |
| transfer_check_20261107_142954/lqr | 2026-11-07 14:29 | lqr | configs/lqr_my_rig_coupling_delay.json | results/sac_focused_policy.zip | 5 | 5 | 0.859 | 12.88 |
| transfer_check_20261107_142954/mpc | 2026-11-07 14:29 | mpc | configs/mpc_my_rig_transfer.json | results/sac_focused_policy.zip | 5 | 5 | 0.859 | 12.88 |
| transfer_check_20261107_142954/pid | 2026-11-07 14:29 | pid | configs/pid_my_rig_transfer.json | results/sac_focused_policy.zip | 5 | 5 | 0.859 | 12.88 |
