crasni/rotary-inverted-pendulum/docs/run-history/file_manifest.csv

path | bytes | mtime | prunable | sha256
accel_chirp_real_003/capture.npz | 33606 | 2026-11-06T21:21:13 | 0
accel_chirp_real_003/comparison.npz | 43011 | 2026-11-06T21:21:13 | 0
accel_chirp_real_003/comparison.png | 130236 | 2026-11-06T21:21:14 | 0
accel_chirp_real_003/metadata.json | 344 | 2026-11-06T21:21:14 | 0
accel_chirp_sim_003/comparison.npz | 34738 | 2026-11-06T21:18:29 | 0
accel_chirp_sim_003/comparison.png | 128968 | 2026-11-06T21:18:29 | 0
accel_chirp_sim_003/metadata.json | 248 | 2026-11-06T21:18:29 | 0
accel_reversal_1/capture.npz | 18912 | 2026-11-07T20:17:07 | 0
accel_reversal_1/metadata.json | 266 | 2026-11-07T20:16:56 | 0
accel_reversal_2/capture.npz | 20405 | 2026-11-07T20:17:27 | 0
accel_reversal_2/comparison.npz | 20458 | 2026-11-07T20:17:27 | 0
accel_reversal_2/comparison.png | 134576 | 2026-11-07T20:17:27 | 0
accel_reversal_2/metadata.json | 358 | 2026-11-07T20:17:27 | 0
accel_reversal_sim/comparison.npz | 14407 | 2026-11-07T20:15:20 | 0
accel_reversal_sim/comparison.png | 106481 | 2026-11-07T20:15:20 | 0
accel_reversal_sim/metadata.json | 264 | 2026-11-07T20:15:20 | 0
accel_step_full_1/capture.npz | 11263 | 2026-11-07T20:12:23 | 0
accel_step_full_1/metadata.json | 250 | 2026-11-07T20:12:14 | 0
accel_step_real_008/capture.npz | 17262 | 2026-11-06T21:18:05 | 0
accel_step_real_008/comparison.npz | 17672 | 2026-11-06T21:18:05 | 0
accel_step_real_008/comparison.png | 123278 | 2026-11-06T21:18:06 | 0
accel_step_real_008/metadata.json | 341 | 2026-11-06T21:18:06 | 0
accel_step_sim_008/comparison.npz | 12262 | 2026-11-06T21:17:39 | 0
accel_step_sim_008/comparison.png | 94777 | 2026-11-06T21:17:39 | 0
accel_step_sim_008/metadata.json | 246 | 2026-11-06T21:17:39 | 0
archive/README.md | 3620 | 2026-11-08T04:20:18 | 0
archive/curriculum/e03_v2_lqrbalance_det/batch.json | 704 | 2026-11-07T23:32:16 | 0
archive/curriculum/e03b_v2_lqrbalance_det/batch.json | 737 | 2026-11-07T23:34:54 | 0
archive/curriculum/e03c_v2_lqrbalance_det/batch.json | 737 | 2026-11-07T23:57:22 | 0
archive/custom_lqrdither_20261107_204719/episode_000.npz | 1106 | 2026-11-07T20:47:24 | 0
archive/custom_lqrdither_20261107_204719/run.json | 680 | 2026-11-07T20:47:20 | 0
archive/custom_lqrdither_20261107_204719/summary.json | 152 | 2026-11-07T20:47:24 | 0
archive/custom_lqrdither_20261107_205245/episode_000.npz | 1106 | 2026-11-07T20:52:48 | 0
archive/custom_lqrdither_20261107_205245/run.json | 680 | 2026-11-07T20:52:46 | 0
archive/custom_lqrdither_20261107_205245/summary.json | 186 | 2026-11-07T20:52:48 | 0
archive/lqr_coupling_delay_20261108_000207/episode_000.npz | 12854 | 2026-11-08T00:02:17 | 0
archive/lqr_coupling_delay_20261108_000207/run.json | 681 | 2026-11-08T00:02:07 | 0
archive/lqr_coupling_delay_20261108_000207/summary.json | 302 | 2026-11-08T00:02:17 | 0
archive/lqr_coupling_delay_20261108_000854/episode_000.npz | 1106 | 2026-11-08T00:08:56 | 0
archive/lqr_coupling_delay_20261108_000854/run.json | 681 | 2026-11-08T00:08:55 | 0
archive/lqr_coupling_delay_20261108_000854/summary.json | 186 | 2026-11-08T00:08:56 | 0
archive/lqr_coupling_delay_20261108_000913/episode_000.npz | 11458 | 2026-11-08T00:09:23 | 0
archive/lqr_coupling_delay_20261108_000913/run.json | 681 | 2026-11-08T00:09:13 | 0
archive/lqr_coupling_delay_20261108_000913/summary.json | 299 | 2026-11-08T00:09:23 | 0
archive/lqr_coupling_delay_20261108_000928/episode_000.npz | 10199 | 2026-11-08T00:09:38 | 0
archive/lqr_coupling_delay_20261108_000928/run.json | 681 | 2026-11-08T00:09:29 | 0
archive/lqr_coupling_delay_20261108_000928/summary.json | 299 | 2026-11-08T00:09:38 | 0
archive/lqr_coupling_delay_20261108_000953/episode_000.npz | 12765 | 2026-11-08T00:10:06 | 0
archive/lqr_coupling_delay_20261108_000953/run.json | 681 | 2026-11-08T00:09:54 | 0
archive/lqr_coupling_delay_20261108_000953/summary.json | 300 | 2026-11-08T00:10:06 | 0
archive/lqr_coupling_delay_20261108_001013/episode_000.npz | 13919 | 2026-11-08T00:10:26 | 0
archive/lqr_coupling_delay_20261108_001013/run.json | 681 | 2026-11-08T00:10:13 | 0
archive/lqr_coupling_delay_20261108_001013/summary.json | 300 | 2026-11-08T00:10:26 | 0
archive/lqr_coupling_delay_20261108_001032/episode_000.npz | 9564 | 2026-11-08T00:10:41 | 0
archive/lqr_coupling_delay_20261108_001032/run.json | 681 | 2026-11-08T00:10:32 | 0
archive/lqr_coupling_delay_20261108_001032/summary.json | 286 | 2026-11-08T00:10:41 | 0
archive/lqr_coupling_delay_20261108_001527/episode_000.npz | 8454 | 2026-11-08T00:15:35 | 0
archive/lqr_coupling_delay_20261108_001527/run.json | 681 | 2026-11-08T00:15:28 | 0
archive/lqr_coupling_delay_20261108_001527/summary.json | 283 | 2026-11-08T00:15:35 | 0
archive/lqr_coupling_delay_20261108_001543./episode_000.npz | 9490 | 2026-11-08T00:15:53 | 0
archive/lqr_coupling_delay_20261108_001543./run.json | 682 | 2026-11-08T00:15:44 | 0
archive/lqr_coupling_delay_20261108_001543./summary.json | 301 | 2026-11-08T00:15:53 | 0
archive/lqr_coupling_delay_20261108_001600/episode_000.npz | 1106 | 2026-11-08T00:16:05 | 0
archive/lqr_coupling_delay_20261108_001600/run.json | 681 | 2026-11-08T00:16:00 | 0
archive/lqr_coupling_delay_20261108_001600/summary.json | 109 | 2026-11-08T00:16:05 | 0
archive/lqr_coupling_delay_20261108_001608/episode_000.npz | 12573 | 2026-11-08T00:16:18 | 0
archive/lqr_coupling_delay_20261108_001608/run.json | 681 | 2026-11-08T00:16:09 | 0
archive/lqr_coupling_delay_20261108_001608/summary.json | 282 | 2026-11-08T00:16:18 | 0
archive/lqr_coupling_delay_20261108_025531/episode_000.npz | 1106 | 2026-11-08T02:55:35 | 0
archive/lqr_coupling_delay_20261108_025531/run.json | 681 | 2026-11-08T02:55:32 | 0
archive/lqr_coupling_delay_20261108_025531/summary.json | 152 | 2026-11-08T02:55:35 | 0
archive/lqr_coupling_delay_20261108_025545/episode_000.npz | 1106 | 2026-11-08T02:55:48 | 0
archive/lqr_coupling_delay_20261108_025545/run.json | 681 | 2026-11-08T02:55:45 | 0
archive/lqr_coupling_delay_20261108_025545/summary.json | 152 | 2026-11-08T02:55:48 | 0
archive/lqr_coupling_delay_20261108_025813/episode_000.npz | 15741 | 2026-11-08T02:58:24 | 0
archive/lqr_coupling_delay_20261108_025813/run.json | 681 | 2026-11-08T02:58:14 | 0
archive/lqr_coupling_delay_20261108_025813/summary.json | 299 | 2026-11-08T02:58:24 | 0
archive/lqr_coupling_delay_20261108_025945/episode_000.npz | 1106 | 2026-11-08T02:59:52 | 0
archive/lqr_coupling_delay_20261108_025945/run.json | 681 | 2026-11-08T02:59:46 | 0
archive/lqr_coupling_delay_20261108_025945/summary.json | 119 | 2026-11-08T02:59:52 | 0
archive/lqr_hw_17/episode_000.npz | 20391 | 2026-11-07T02:04:09 | 0
archive/lqr_hw_17/run.json | 650 | 2026-11-07T02:03:56 | 0
archive/lqr_hw_17/summary.json | 268 | 2026-11-07T02:04:09 | 0
archive/lqr_swing_20261107_025003/episode_000.npz | 87864 | 2026-11-07T02:50:31 | 0
archive/lqr_swing_20261107_025003/run.json | 663 | 2026-11-07T02:50:03 | 0
archive/lqr_swing_20261107_025003/summary.json | 252 | 2026-11-07T02:50:31 | 0
archive/sac_W2_20261107_205411/episode_000.npz | 1106 | 2026-11-07T20:54:16 | 0
archive/sac_W2_20261107_205411/run.json | 654 | 2026-11-07T20:54:12 | 0
archive/sac_W2_20261107_205411/summary.json | 155 | 2026-11-07T20:54:16 | 0
archive/sac_v2m2_20261108_031006/run.json | 661 | 2026-11-08T03:10:06 | 0
archive/sac_v2m2_20261108_031340/episode_000.npz | 1106 | 2026-11-08T03:13:44 | 0
archive/sac_v2m2_20261108_031340/run.json | 668 | 2026-11-08T03:13:40 | 0
archive/sac_v2m2_20261108_031340/summary.json | 152 | 2026-11-08T03:13:44 | 0
archive/sac_v2m2_20261108_031741/run.json | 661 | 2026-11-08T03:17:42 | 0
archive/sac_v2m2_20261108_031758/episode_000.npz | 1106 | 2026-11-08T03:18:11 | 0
archive/sac_v2m2_20261108_031758/run.json | 668 | 2026-11-08T03:17:59 | 0
archive/sac_v2m2_20261108_031758/summary.json | 93 | 2026-11-08T03:18:11 | 0
archive/sac_v2m2_20261108_031911/episode_000.npz | 24269 | 2026-11-08T03:19:28 | 0
archive/sac_v2m2_20261108_031911/run.json | 668 | 2026-11-08T03:19:11 | 0
archive/sac_v2m2_20261108_031911/summary.json | 236 | 2026-11-08T03:19:28 | 0
archive/sac_v2m2_20261108_031931/episode_000.npz | 1106 | 2026-11-08T03:19:35 | 0
archive/sac_v2m2_20261108_031931/run.json | 668 | 2026-11-08T03:19:31 | 0
archive/sac_v2m2_20261108_031931/summary.json | 109 | 2026-11-08T03:19:35 | 0
archive/sac_v2m2_20261108_032213/run.json | 661 | 2026-11-08T03:22:13 | 0
archive/sac_v6b_20261108_041929/run.json | 666 | 2026-11-08T04:19:29 | 0
archive/sac_v6b_20261108_041936/run.json | 666 | 2026-11-08T04:19:37 | 0
before_changes_20261106_211040/accel_chirp_real_002/capture.npz | 35007 | 2026-11-06T21:06:27 | 0
before_changes_20261106_211040/accel_chirp_real_002/comparison.npz | 44323 | 2026-11-06T21:06:27 | 0
before_changes_20261106_211040/accel_chirp_real_002/comparison.png | 127192 | 2026-11-06T21:06:27 | 0
before_changes_20261106_211040/accel_chirp_real_002/metadata.json | 343 | 2026-11-06T21:06:27 | 0
before_changes_20261106_211040/accel_chirp_sim_002/comparison.npz | 34668 | 2026-11-06T21:05:26 | 0
before_changes_20261106_211040/accel_chirp_sim_002/comparison.png | 130617 | 2026-11-06T21:05:27 | 0
before_changes_20261106_211040/accel_chirp_sim_002/metadata.json | 248 | 2026-11-06T21:05:27 | 0
before_changes_20261106_211040/accel_step_real/capture.npz | 10897 | 2026-11-06T20:27:21 | 0
before_changes_20261106_211040/accel_step_real/metadata.json | 262 | 2026-11-06T20:27:05 | 0
before_changes_20261106_211040/accel_step_real_008/capture.npz | 18380 | 2026-11-06T21:03:55 | 0
before_changes_20261106_211040/accel_step_real_008/comparison.npz | 18253 | 2026-11-06T21:03:55 | 0
before_changes_20261106_211040/accel_step_real_008/comparison.png | 119414 | 2026-11-06T21:03:56 | 0
before_changes_20261106_211040/accel_step_real_008/metadata.json | 341 | 2026-11-06T21:03:56 | 0
before_changes_20261106_211040/accel_step_sim/comparison.npz | 12309 | 2026-11-06T20:26:21 | 0
before_changes_20261106_211040/accel_step_sim/comparison.png | 95500 | 2026-11-06T20:26:22 | 0
before_changes_20261106_211040/accel_step_sim/metadata.json | 260 | 2026-11-06T20:26:22 | 0
before_changes_20261106_211040/accel_step_sim_008/comparison.npz | 12247 | 2026-11-06T20:28:35 | 0
before_changes_20261106_211040/accel_step_sim_008/comparison.png | 93906 | 2026-11-06T20:28:35 | 0
before_changes_20261106_211040/accel_step_sim_008/metadata.json | 246 | 2026-11-06T20:28:35 | 0
before_changes_20261106_211040/my_rig.json | 3658 | 2026-11-06T20:21:13 | 0
before_changes_20261106_211040/sysid_holdout_01/free_run_1.npz | 41216 | 2026-11-06T20:23:57 | 0
before_changes_20261106_211040/sysid_holdout_01/free_run_2.npz | 41216 | 2026-11-06T20:24:14 | 0
before_changes_20261106_211040/sysid_holdout_01/free_run_3.npz | 41216 | 2026-11-06T20:24:31 | 0
before_changes_20261106_211040/sysid_holdout_01/metadata.json | 481 | 2026-11-06T20:24:31 | 0
before_changes_20261106_211040/sysid_holdout_01/tare.npz | 13480 | 2026-11-06T20:23:38 | 0
before_changes_20261106_211040/sysid_train_01/free_run_1.npz | 41216 | 2026-11-06T20:20:38 | 0
before_changes_20261106_211040/sysid_train_01/free_run_2.npz | 41216 | 2026-11-06T20:20:56 | 0
before_changes_20261106_211040/sysid_train_01/free_run_3.npz | 41216 | 2026-11-06T20:21:13 | 0
before_changes_20261106_211040/sysid_train_01/freeswing_compare.csv | 72466 | 2026-11-06T20:21:13 | 0
before_changes_20261106_211040/sysid_train_01/freeswing_compare.json | 223 | 2026-11-06T20:21:13 | 0
before_changes_20261106_211040/sysid_train_01/freeswing_compare.png | 155456 | 2026-11-06T20:21:13 | 0
before_changes_20261106_211040/sysid_train_01/metadata.json | 481 | 2026-11-06T20:21:13 | 0
before_changes_20261106_211040/sysid_train_01/tare.npz | 13480 | 2026-11-06T20:20:18 | 0
before_changes_20261106_211040/sysid_validation_01/free_run_1/freeswing_compare.csv | 72323 | 2026-11-06T20:24:40 | 0
before_changes_20261106_211040/sysid_validation_01/free_run_1/freeswing_compare.json | 223 | 2026-11-06T20:24:40 | 0
before_changes_20261106_211040/sysid_validation_01/free_run_1/freeswing_compare.png | 149664 | 2026-11-06T20:24:40 | 0
before_changes_20261106_211040/sysid_validation_01/free_run_2/freeswing_compare.csv | 71485 | 2026-11-06T20:24:41 | 0
before_changes_20261106_211040/sysid_validation_01/free_run_2/freeswing_compare.json | 222 | 2026-11-06T20:24:41 | 0
before_changes_20261106_211040/sysid_validation_01/free_run_2/freeswing_compare.png | 148561 | 2026-11-06T20:24:41 | 0
before_changes_20261106_211040/sysid_validation_01/free_run_3/freeswing_compare.csv | 73987 | 2026-11-06T20:24:41 | 0
before_changes_20261106_211040/sysid_validation_01/free_run_3/freeswing_compare.json | 223 | 2026-11-06T20:24:41 | 0
before_changes_20261106_211040/sysid_validation_01/free_run_3/freeswing_compare.png | 158096 | 2026-11-06T20:24:41 | 0
before_changes_20261106_211040/sysid_validation_01/validation.json | 716 | 2026-11-06T20:24:41 | 0
coupling_01.json | 6480 | 2026-11-06T21:22:13 | 0
curriculum/b00_v1_balance_det/batch.json | 682 | 2026-11-07T22:33:53 | 0
curriculum/b00_v1_balance_det/episode_000.npz | 32677 | 2026-11-07T22:33:07 | 0
curriculum/b00_v1_balance_det/episode_001.npz | 32775 | 2026-11-07T22:33:30 | 0
curriculum/b00_v1_balance_det/episode_002.npz | 32682 | 2026-11-07T22:33:53 | 0
curriculum/b00_v1_balance_det/summary.json | 847 | 2026-11-07T22:33:53 | 0
curriculum/b02_v1_lqrbalance_det/batch.json | 639 | 2026-11-07T22:47:00 | 0
curriculum/b02_v1_lqrbalance_det/episode_000.npz | 79129 | 2026-11-07T22:45:45 | 0
curriculum/b02_v1_lqrbalance_det/episode_001.npz | 50268 | 2026-11-07T22:46:04 | 0
curriculum/b02_v1_lqrbalance_det/episode_002.npz | 60070 | 2026-11-07T22:46:29 | 0
curriculum/b02_v1_lqrbalance_det/episode_003.npz | 39900 | 2026-11-07T22:46:57 | 0
curriculum/b02_v1_lqrbalance_det/summary.json | 2457 | 2026-11-07T22:47:00 | 0
curriculum/b02_v1_lqrbalance_det/transitions_000.npz | 23243 | 2026-11-07T22:45:45 | 0
curriculum/b02_v1_lqrbalance_det/transitions_001.npz | 23247 | 2026-11-07T22:46:04 | 0
curriculum/b02_v1_lqrbalance_det/transitions_002.npz | 22847 | 2026-11-07T22:46:29 | 0
curriculum/b03_v1_lqrbalance_train/batch.json | 673 | 2026-11-07T22:52:41 | 0
curriculum/b03_v1_lqrbalance_train/episode_000.npz | 47995 | 2026-11-07T22:50:12 | 0
curriculum/b03_v1_lqrbalance_train/episode_001.npz | 50890 | 2026-11-07T22:50:30 | 0
curriculum/b03_v1_lqrbalance_train/episode_002.npz | 62393 | 2026-11-07T22:51:15 | 0
curriculum/b03_v1_lqrbalance_train/episode_003.npz | 62041 | 2026-11-07T22:51:58 | 0
curriculum/b03_v1_lqrbalance_train/episode_004.npz | 62096 | 2026-11-07T22:52:41 | 0
curriculum/b03_v1_lqrbalance_train/summary.json | 2393 | 2026-11-07T22:52:41 | 0
curriculum/b03_v1_lqrbalance_train/transitions_000.npz | 22866 | 2026-11-07T22:50:12 | 0
curriculum/b03_v1_lqrbalance_train/transitions_001.npz | 23035 | 2026-11-07T22:50:30 | 0
curriculum/b04_v1_lqrbalance_train/batch.json | 652 | 2026-11-07T22:58:37 | 0
curriculum/b04_v1_lqrbalance_train/episode_000.npz | 47184 | 2026-11-07T22:53:49 | 0
curriculum/b04_v1_lqrbalance_train/episode_001.npz | 61016 | 2026-11-07T22:54:13 | 0
curriculum/b04_v1_lqrbalance_train/episode_002.npz | 44721 | 2026-11-07T22:54:28 | 0
curriculum/b04_v1_lqrbalance_train/episode_003.npz | 46766 | 2026-11-07T22:54:43 | 0
curriculum/b04_v1_lqrbalance_train/episode_004.npz | 86819 | 2026-11-07T22:55:25 | 0
curriculum/b04_v1_lqrbalance_train/episode_005.npz | 69750 | 2026-11-07T22:55:56 | 0
curriculum/b04_v1_lqrbalance_train/episode_006.npz | 76430 | 2026-11-07T22:56:33 | 0
curriculum/b04_v1_lqrbalance_train/episode_007.npz | 64867 | 2026-11-07T22:57:01 | 0
curriculum/b04_v1_lqrbalance_train/episode_008.npz | 73916 | 2026-11-07T22:57:36 | 0
curriculum/b04_v1_lqrbalance_train/episode_009.npz | 61167 | 2026-11-07T22:58:19 | 0
curriculum/b04_v1_lqrbalance_train/summary.json | 6722 | 2026-11-07T22:58:19 | 0
curriculum/b04_v1_lqrbalance_train/transitions_000.npz | 23201 | 2026-11-07T22:53:49 | 0
curriculum/b04_v1_lqrbalance_train/transitions_001.npz | 23147 | 2026-11-07T22:54:13 | 0
curriculum/b04_v1_lqrbalance_train/transitions_002.npz | 22873 | 2026-11-07T22:54:28 | 0
curriculum/b04_v1_lqrbalance_train/transitions_003.npz | 23288 | 2026-11-07T22:54:43 | 0
curriculum/b04_v1_lqrbalance_train/transitions_004.npz | 23241 | 2026-11-07T22:55:25 | 0
curriculum/b04_v1_lqrbalance_train/transitions_005.npz | 23201 | 2026-11-07T22:55:56 | 0
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
curriculum/catch_rows.json | 9132 | 2026-11-08T04:08:58 | 0
curriculum/e01_v1_lqrbalance_det/batch.json | 646 | 2026-11-07T23:02:27 | 0
curriculum/e01_v1_lqrbalance_det/episode_000.npz | 64280 | 2026-11-07T23:01:30 | 0
curriculum/e01_v1_lqrbalance_det/episode_001.npz | 56272 | 2026-11-07T23:01:52 | 0
curriculum/e01_v1_lqrbalance_det/episode_002.npz | 47453 | 2026-11-07T23:02:08 | 0
curriculum/e01_v1_lqrbalance_det/episode_003.npz | 44260 | 2026-11-07T23:02:22 | 0
curriculum/e01_v1_lqrbalance_det/summary.json | 2862 | 2026-11-07T23:02:27 | 0
curriculum/e01_v1_lqrbalance_det/transitions_000.npz | 23047 | 2026-11-07T23:01:30 | 0
curriculum/e01_v1_lqrbalance_det/transitions_001.npz | 23093 | 2026-11-07T23:01:52 | 0
curriculum/e01_v1_lqrbalance_det/transitions_002.npz | 23159 | 2026-11-07T23:02:08 | 0
curriculum/e01_v1_lqrbalance_det/transitions_003.npz | 23194 | 2026-11-07T23:02:22 | 0
curriculum/e02_v1_hanging_det/batch.json | 496 | 2026-11-07T23:04:33 | 0
curriculum/e02_v1_hanging_det/episode_000.npz | 98047 | 2026-11-07T23:03:19 | 0
curriculum/e02_v1_hanging_det/episode_001.npz | 98039 | 2026-11-07T23:03:42 | 0
curriculum/e02_v1_hanging_det/episode_002.npz | 98303 | 2026-11-07T23:04:07 | 0
curriculum/e02_v1_hanging_det/episode_003.npz | 97460 | 2026-11-07T23:04:30 | 0
curriculum/e02_v1_hanging_det/summary.json | 2351 | 2026-11-07T23:04:33 | 0
curriculum/e02_v1_hanging_det/transitions_000.npz | 55631 | 2026-11-07T23:03:19 | 0
curriculum/e02_v1_hanging_det/transitions_001.npz | 55890 | 2026-11-07T23:03:42 | 0
curriculum/e02_v1_hanging_det/transitions_002.npz | 55898 | 2026-11-07T23:04:07 | 0
curriculum/e02_v1_hanging_det/transitions_003.npz | 55271 | 2026-11-07T23:04:30 | 0
curriculum/e04_v2_lqrbalance_det/batch.json | 675 | 2026-11-08T03:02:51 | 0
curriculum/e04_v2_lqrbalance_det/episode_000.npz | 12547 | 2026-11-08T03:02:17 | 0
curriculum/e04_v2_lqrbalance_det/episode_001.npz | 15705 | 2026-11-08T03:02:27 | 0
curriculum/e04_v2_lqrbalance_det/episode_002.npz | 14845 | 2026-11-08T03:02:37 | 0
curriculum/e04_v2_lqrbalance_det/episode_003.npz | 14044 | 2026-11-08T03:02:47 | 0
curriculum/e04_v2_lqrbalance_det/summary.json | 2957 | 2026-11-08T03:02:51 | 0
curriculum/e04_v2_lqrbalance_det/transitions_000.npz | 4818 | 2026-11-08T03:02:17 | 0
curriculum/e04_v2_lqrbalance_det/transitions_001.npz | 3612 | 2026-11-08T03:02:27 | 0
curriculum/e04_v2_lqrbalance_det/transitions_002.npz | 4124 | 2026-11-08T03:02:37 | 0
curriculum/e04_v2_lqrbalance_det/transitions_003.npz | 3440 | 2026-11-08T03:02:47 | 0
curriculum/e05_v2m2_lqrbalance_det/batch.json | 677 | 2026-11-08T03:06:26 | 0
curriculum/e05_v2m2_lqrbalance_det/episode_000.npz | 48700 | 2026-11-08T03:05:22 | 0
curriculum/e05_v2m2_lqrbalance_det/episode_001.npz | 32884 | 2026-11-08T03:05:36 | 0
curriculum/e05_v2m2_lqrbalance_det/episode_002.npz | 62726 | 2026-11-08T03:06:10 | 0
curriculum/e05_v2m2_lqrbalance_det/episode_003.npz | 31787 | 2026-11-08T03:06:22 | 0
curriculum/e05_v2m2_lqrbalance_det/summary.json | 2891 | 2026-11-08T03:06:26 | 0
curriculum/e05_v2m2_lqrbalance_det/transitions_000.npz | 14214 | 2026-11-08T03:05:22 | 0
curriculum/e05_v2m2_lqrbalance_det/transitions_001.npz | 13724 | 2026-11-08T03:05:36 | 0
curriculum/e05_v2m2_lqrbalance_det/transitions_002.npz | 13109 | 2026-11-08T03:06:10 | 0
curriculum/e05_v2m2_lqrbalance_det/transitions_003.npz | 14229 | 2026-11-08T03:06:22 | 0
curriculum/e06_v2m2_hanging_det/batch.json | 498 | 2026-11-08T03:09:51 | 0
curriculum/e06_v2m2_hanging_det/episode_000.npz | 91806 | 2026-11-08T03:08:37 | 0
curriculum/e06_v2m2_hanging_det/episode_001.npz | 96459 | 2026-11-08T03:09:01 | 0
curriculum/e06_v2m2_hanging_det/episode_002.npz | 89401 | 2026-11-08T03:09:25 | 0
curriculum/e06_v2m2_hanging_det/episode_003.npz | 95697 | 2026-11-08T03:09:47 | 0
curriculum/e06_v2m2_hanging_det/summary.json | 2379 | 2026-11-08T03:09:51 | 0
curriculum/e06_v2m2_hanging_det/transitions_000.npz | 51321 | 2026-11-08T03:08:37 | 0
curriculum/e06_v2m2_hanging_det/transitions_001.npz | 55709 | 2026-11-08T03:09:01 | 0
curriculum/e06_v2m2_hanging_det/transitions_002.npz | 48747 | 2026-11-08T03:09:25 | 0
curriculum/e06_v2m2_hanging_det/transitions_003.npz | 54850 | 2026-11-08T03:09:47 | 0
curriculum/e06_v2m2_hanging_det_2/batch.json | 498 | 2026-11-08T03:27:07 | 0
curriculum/e06_v2m2_hanging_det_2/episode_000.npz | 96917 | 2026-11-08T03:25:55 | 0
curriculum/e06_v2m2_hanging_det_2/episode_001.npz | 95504 | 2026-11-08T03:26:17 | 0
curriculum/e06_v2m2_hanging_det_2/episode_002.npz | 96311 | 2026-11-08T03:26:40 | 0
curriculum/e06_v2m2_hanging_det_2/episode_003.npz | 96952 | 2026-11-08T03:27:04 | 0
curriculum/e06_v2m2_hanging_det_2/summary.json | 2397 | 2026-11-08T03:27:07 | 0
curriculum/e06_v2m2_hanging_det_2/transitions_000.npz | 56190 | 2026-11-08T03:25:55 | 0
curriculum/e06_v2m2_hanging_det_2/transitions_001.npz | 54694 | 2026-11-08T03:26:17 | 0
curriculum/e06_v2m2_hanging_det_2/transitions_002.npz | 55443 | 2026-11-08T03:26:40 | 0
curriculum/e06_v2m2_hanging_det_2/transitions_003.npz | 55990 | 2026-11-08T03:27:04 | 0
curriculum/e07_v3_hanging_det/batch.json | 496 | 2026-11-08T03:35:05 | 0
curriculum/e07_v3_hanging_det/episode_000.npz | 73302 | 2026-11-08T03:34:06 | 0
curriculum/e07_v3_hanging_det/episode_001.npz | 70012 | 2026-11-08T03:34:25 | 0
curriculum/e07_v3_hanging_det/episode_002.npz | 73530 | 2026-11-08T03:34:43 | 0
curriculum/e07_v3_hanging_det/episode_003.npz | 72134 | 2026-11-08T03:35:02 | 0
curriculum/e07_v3_hanging_det/summary.json | 2462 | 2026-11-08T03:35:05 | 0
curriculum/e07_v3_hanging_det/transitions_000.npz | 42655 | 2026-11-08T03:34:06 | 0
curriculum/e07_v3_hanging_det/transitions_001.npz | 39580 | 2026-11-08T03:34:25 | 0
curriculum/e07_v3_hanging_det/transitions_002.npz | 42573 | 2026-11-08T03:34:43 | 0
curriculum/e07_v3_hanging_det/transitions_003.npz | 41865 | 2026-11-08T03:35:02 | 0
curriculum/e08_v3b_hanging_det/batch.json | 497 | 2026-11-08T03:39:43 | 0
curriculum/e08_v3b_hanging_det/episode_000.npz | 70378 | 2026-11-08T03:38:44 | 0
curriculum/e08_v3b_hanging_det/episode_001.npz | 66795 | 2026-11-08T03:39:02 | 0
curriculum/e08_v3b_hanging_det/episode_002.npz | 73394 | 2026-11-08T03:39:22 | 0
curriculum/e08_v3b_hanging_det/episode_003.npz | 67547 | 2026-11-08T03:39:39 | 0
curriculum/e08_v3b_hanging_det/summary.json | 2453 | 2026-11-08T03:39:43 | 0
curriculum/e08_v3b_hanging_det/transitions_000.npz | 39734 | 2026-11-08T03:38:44 | 0
curriculum/e08_v3b_hanging_det/transitions_001.npz | 36481 | 2026-11-08T03:39:02 | 0
curriculum/e08_v3b_hanging_det/transitions_002.npz | 42556 | 2026-11-08T03:39:22 | 0
curriculum/e08_v3b_hanging_det/transitions_003.npz | 36995 | 2026-11-08T03:39:39 | 0
curriculum/e08_v3b_hanging_det_2/batch.json | 497 | 2026-11-08T03:44:39 | 0
curriculum/e08_v3b_hanging_det_2/episode_000.npz | 73473 | 2026-11-08T03:43:41 | 0
curriculum/e08_v3b_hanging_det_2/episode_001.npz | 73364 | 2026-11-08T03:43:59 | 0
curriculum/e08_v3b_hanging_det_2/episode_002.npz | 72581 | 2026-11-08T03:44:17 | 0
curriculum/e08_v3b_hanging_det_2/episode_003.npz | 73460 | 2026-11-08T03:44:36 | 0
curriculum/e08_v3b_hanging_det_2/summary.json | 2473 | 2026-11-08T03:44:39 | 0
curriculum/e08_v3b_hanging_det_2/transitions_000.npz | 42659 | 2026-11-08T03:43:41 | 0
curriculum/e08_v3b_hanging_det_2/transitions_001.npz | 42564 | 2026-11-08T03:43:59 | 0
curriculum/e08_v3b_hanging_det_2/transitions_002.npz | 41777 | 2026-11-08T03:44:17 | 0
curriculum/e08_v3b_hanging_det_2/transitions_003.npz | 42533 | 2026-11-08T03:44:36 | 0
curriculum/e09_v5_hanging_det/batch.json | 496 | 2026-11-08T04:08:15 | 0
curriculum/e09_v5_hanging_det/episode_000.npz | 72919 | 2026-11-08T04:07:18 | 0
curriculum/e09_v5_hanging_det/episode_001.npz | 73141 | 2026-11-08T04:07:36 | 0
curriculum/e09_v5_hanging_det/episode_002.npz | 73301 | 2026-11-08T04:07:55 | 0
curriculum/e09_v5_hanging_det/episode_003.npz | 73234 | 2026-11-08T04:08:13 | 0
curriculum/e09_v5_hanging_det/summary.json | 2312 | 2026-11-08T04:08:15 | 0
curriculum/e09_v5_hanging_det/transitions_000.npz | 42530 | 2026-11-08T04:07:18 | 0
curriculum/e09_v5_hanging_det/transitions_001.npz | 42549 | 2026-11-08T04:07:36 | 0
curriculum/e09_v5_hanging_det/transitions_002.npz | 42682 | 2026-11-08T04:07:55 | 0
curriculum/e09_v5_hanging_det/transitions_003.npz | 42593 | 2026-11-08T04:08:13 | 0
curriculum/e10_v6b_hanging_det/batch.json | 497 | 2026-11-08T04:18:14 | 0
curriculum/e10_v6b_hanging_det/episode_000.npz | 64030 | 2026-11-08T04:17:14 | 0
curriculum/e10_v6b_hanging_det/episode_001.npz | 73497 | 2026-11-08T04:17:33 | 0
curriculum/e10_v6b_hanging_det/episode_002.npz | 73319 | 2026-11-08T04:17:52 | 0
curriculum/e10_v6b_hanging_det/episode_003.npz | 73068 | 2026-11-08T04:18:10 | 0
curriculum/e10_v6b_hanging_det/summary.json | 2466 | 2026-11-08T04:18:14 | 0
curriculum/e10_v6b_hanging_det/transitions_000.npz | 33811 | 2026-11-08T04:17:14 | 0
curriculum/e10_v6b_hanging_det/transitions_001.npz | 42589 | 2026-11-08T04:17:33 | 0
curriculum/e10_v6b_hanging_det/transitions_002.npz | 42498 | 2026-11-08T04:17:52 | 0
curriculum/e10_v6b_hanging_det/transitions_003.npz | 42561 | 2026-11-08T04:18:10 | 0
curriculum/e11_v7_hanging_det/batch.json | 496 | 2026-11-08T04:27:04 | 0
curriculum/e11_v7_hanging_det/episode_000.npz | 73039 | 2026-11-08T04:26:05 | 0
curriculum/e11_v7_hanging_det/episode_001.npz | 65973 | 2026-11-08T04:26:24 | 0
curriculum/e11_v7_hanging_det/episode_002.npz | 73728 | 2026-11-08T04:26:43 | 0
curriculum/e11_v7_hanging_det/episode_003.npz | 73185 | 2026-11-08T04:27:02 | 0
curriculum/e11_v7_hanging_det/summary.json | 2424 | 2026-11-08T04:27:04 | 0
curriculum/e11_v7_hanging_det/transitions_000.npz | 42322 | 2026-11-08T04:26:05 | 0
curriculum/e11_v7_hanging_det/transitions_001.npz | 35589 | 2026-11-08T04:26:24 | 0
curriculum/e11_v7_hanging_det/transitions_002.npz | 42732 | 2026-11-08T04:26:43 | 0
curriculum/e11_v7_hanging_det/transitions_003.npz | 42610 | 2026-11-08T04:27:02 | 0
curriculum/e12_v7_hanging_det_r1/batch.json | 439 | 2026-11-08T20:38:21 | 0
curriculum/e12_v7_hanging_det_r1b/batch.json | 496 | 2026-11-08T20:49:19 | 0
curriculum/e12_v7_hanging_det_r1b/episode_000.npz | 73257 | 2026-11-08T20:48:21 | 0
curriculum/e12_v7_hanging_det_r1b/episode_001.npz | 72004 | 2026-11-08T20:48:39 | 0
curriculum/e12_v7_hanging_det_r1b/episode_002.npz | 74266 | 2026-11-08T20:48:57 | 0
curriculum/e12_v7_hanging_det_r1b/episode_003.npz | 74051 | 2026-11-08T20:49:16 | 0
curriculum/e12_v7_hanging_det_r1b/summary.json | 2507 | 2026-11-08T20:49:19 | 0
curriculum/e12_v7_hanging_det_r1b/transitions_000.npz | 41248 | 2026-11-08T20:48:21 | 0
curriculum/e12_v7_hanging_det_r1b/transitions_001.npz | 40065 | 2026-11-08T20:48:39 | 0
curriculum/e12_v7_hanging_det_r1b/transitions_002.npz | 42293 | 2026-11-08T20:48:57 | 0
curriculum/e12_v7_hanging_det_r1b/transitions_003.npz | 41594 | 2026-11-08T20:49:16 | 0
curriculum/e12_v8_hanging_det_r1/batch.json | 496 | 2026-11-08T20:46:24 | 0
curriculum/e12_v8_hanging_det_r1/episode_000.npz | 74431 | 2026-11-08T20:45:26 | 0
curriculum/e12_v8_hanging_det_r1/episode_001.npz | 74859 | 2026-11-08T20:45:44 | 0
curriculum/e12_v8_hanging_det_r1/episode_002.npz | 74730 | 2026-11-08T20:46:02 | 0
curriculum/e12_v8_hanging_det_r1/episode_003.npz | 74579 | 2026-11-08T20:46:21 | 0
curriculum/e12_v8_hanging_det_r1/summary.json | 2516 | 2026-11-08T20:46:24 | 0
curriculum/e12_v8_hanging_det_r1/transitions_000.npz | 42476 | 2026-11-08T20:45:26 | 0
curriculum/e12_v8_hanging_det_r1/transitions_001.npz | 42569 | 2026-11-08T20:45:44 | 0
curriculum/e12_v8_hanging_det_r1/transitions_002.npz | 42309 | 2026-11-08T20:46:02 | 0
curriculum/e12_v8_hanging_det_r1/transitions_003.npz | 42137 | 2026-11-08T20:46:21 | 0
curriculum/e13_v7_hanging_det_r1/batch.json | 496 | 2026-11-08T20:58:40 | 0
curriculum/e13_v7_hanging_det_r1/episode_000.npz | 73425 | 2026-11-08T20:57:42 | 0
curriculum/e13_v7_hanging_det_r1/episode_001.npz | 74787 | 2026-11-08T20:57:59 | 0
curriculum/e13_v7_hanging_det_r1/episode_002.npz | 74783 | 2026-11-08T20:58:18 | 0
curriculum/e13_v7_hanging_det_r1/episode_003.npz | 72965 | 2026-11-08T20:58:37 | 0
curriculum/e13_v7_hanging_det_r1/summary.json | 2440 | 2026-11-08T20:58:40 | 0
curriculum/e13_v7_hanging_det_r1/transitions_000.npz | 41323 | 2026-11-08T20:57:42 | 0
curriculum/e13_v7_hanging_det_r1/transitions_001.npz | 42544 | 2026-11-08T20:57:59 | 0
curriculum/e13_v7_hanging_det_r1/transitions_002.npz | 42592 | 2026-11-08T20:58:18 | 0
curriculum/e13_v7_hanging_det_r1/transitions_003.npz | 40943 | 2026-11-08T20:58:37 | 0
curriculum/e13_v7_hanging_det_r2/batch.json | 496 | 2026-11-08T21:01:26 | 0
curriculum/e13_v7_hanging_det_r2/episode_000.npz | 73835 | 2026-11-08T21:00:27 | 0
curriculum/e13_v7_hanging_det_r2/episode_001.npz | 71194 | 2026-11-08T21:00:47 | 0
curriculum/e13_v7_hanging_det_r2/episode_002.npz | 73269 | 2026-11-08T21:01:05 | 0
curriculum/e13_v7_hanging_det_r2/episode_003.npz | 73768 | 2026-11-08T21:01:24 | 0
curriculum/e13_v7_hanging_det_r2/summary.json | 2454 | 2026-11-08T21:01:26 | 0
curriculum/e13_v7_hanging_det_r2/transitions_000.npz | 42354 | 2026-11-08T21:00:27 | 0
curriculum/e13_v7_hanging_det_r2/transitions_001.npz | 39904 | 2026-11-08T21:00:47 | 0
curriculum/e13_v7_hanging_det_r2/transitions_002.npz | 41684 | 2026-11-08T21:01:05 | 0
curriculum/e13_v7_hanging_det_r2/transitions_003.npz | 42068 | 2026-11-08T21:01:24 | 0
curriculum/e13_v7_hanging_det_r3/batch.json | 496 | 2026-11-08T21:04:08 | 0
curriculum/e13_v7_hanging_det_r3/episode_000.npz | 73868 | 2026-11-08T21:03:12 | 0
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
curriculum/e16_sm5_hanging_det_r3/summary.json | 2456 | 2026-11-08T23:39:06 | 0
curriculum/e16_sm5_hanging_det_r3/transitions_000.npz | 42636 | 2026-11-08T23:38:08 | 0
curriculum/e16_sm5_hanging_det_r3/transitions_001.npz | 42263 | 2026-11-08T23:38:27 | 0
curriculum/e16_sm5_hanging_det_r3/transitions_002.npz | 42632 | 2026-11-08T23:38:45 | 0
curriculum/e16_sm5_hanging_det_r3/transitions_003.npz | 42575 | 2026-11-08T23:39:03 | 0
curriculum/e17_rnA_quick/batch.json | 497 | 2026-11-09T00:07:08 | 0
curriculum/e17_rnA_quick/episode_000.npz | 74192 | 2026-11-09T00:06:09 | 0
curriculum/e17_rnA_quick/episode_001.npz | 74240 | 2026-11-09T00:06:27 | 0
curriculum/e17_rnA_quick/episode_002.npz | 74317 | 2026-11-09T00:06:46 | 0
curriculum/e17_rnA_quick/episode_003.npz | 70654 | 2026-11-09T00:07:04 | 0
curriculum/e17_rnA_quick/summary.json | 2469 | 2026-11-09T00:07:08 | 0
curriculum/e17_rnA_quick/transitions_000.npz | 42641 | 2026-11-09T00:06:09 | 0
curriculum/e17_rnA_quick/transitions_001.npz | 42670 | 2026-11-09T00:06:28 | 0
curriculum/e17_rnA_quick/transitions_002.npz | 42693 | 2026-11-09T00:06:46 | 0
curriculum/e17_rnA_quick/transitions_003.npz | 39231 | 2026-11-09T00:07:04 | 0
curriculum/e17_rnC_quick/batch.json | 507 | 2026-11-09T00:07:47 | 0
curriculum/e17_rnC_quick/episode_000.npz | 74392 | 2026-11-09T00:07:44 | 0
curriculum/e17_rnC_quick/summary.json | 603 | 2026-11-09T00:07:44 | 0
curriculum/e17_rnC_quick/transitions_000.npz | 42536 | 2026-11-09T00:07:44 | 0
curriculum/e18_rnA_fixed/batch.json | 507 | 2026-11-09T00:44:02 | 0
curriculum/e18_rnA_fixed/episode_000.npz | 72116 | 2026-11-09T00:43:41 | 0
curriculum/e18_rnA_fixed/episode_001.npz | 66449 | 2026-11-09T00:44:00 | 0
curriculum/e18_rnA_fixed/summary.json | 1223 | 2026-11-09T00:44:00 | 0
curriculum/e18_rnA_fixed/transitions_000.npz | 40145 | 2026-11-09T00:43:41 | 0
curriculum/e18_rnA_fixed/transitions_001.npz | 34611 | 2026-11-09T00:44:00 | 0
curriculum/e19_ppo_rn/batch.json | 443 | 2026-11-09T01:02:05 | 0
curriculum/s01_v6b_online/actor_weights.pt | 84003 | 2026-11-08T22:38:18 | 0 | 431ad9b5e656bea1e24b66b8c9cf079436e9bb18a10ed259a2808b4d2bf0be55
curriculum/s01_v6b_online/batch.json | 1629 | 2026-11-08T22:38:18 | 0
curriculum/s01_v6b_online/checkpoints/episode_000_updates_0.critic_ln.pt | 1193467 | 2026-11-08T22:17:16 | 1 | 422a4fac2718d2ffbfa916858c6914c3930f70c162d75a086e3c2d4f32bdbec6
curriculum/s01_v6b_online/checkpoints/episode_000_updates_0.zip | 111108622 | 2026-11-08T22:17:16 | 1 | 67edb9af4d132453e5ee84ef90c9c274441285cd9329c866cdacd502262c5a49
curriculum/s01_v6b_online/checkpoints/episode_001_updates_100.critic_ln.pt | 1193559 | 2026-11-08T22:17:17 | 1 | 7b359cd79a4cb09fda938fb702a127683f76c7d1aaec8994e3352abefb55d5fa
curriculum/s01_v6b_online/checkpoints/episode_001_updates_100.zip | 111106943 | 2026-11-08T22:17:17 | 1 | c106070e950d7ed8f0d1812679b26360155abd9c55654cdb38b0464f566228a8
curriculum/s01_v6b_online/checkpoints/episode_002_updates_200.critic_ln.pt | 1193559 | 2026-11-08T22:17:18 | 1 | 3381daa97c8efe489e511eb7fda4a03d610c1ba83a307ef2fdb2311bb958a5d1
curriculum/s01_v6b_online/checkpoints/episode_002_updates_200.zip | 111106943 | 2026-11-08T22:17:18 | 1 | 702499318220e61f2ae03df72bbce3d46b1253438f1f2082acda547b4a86fe74
curriculum/s01_v6b_online/checkpoints/episode_003_updates_300.critic_ln.pt | 1193559 | 2026-11-08T22:17:19 | 1 | c75b271dbb6001ca81b19729df68bd0e4cd1b449f6e583907689f2b6695a8888
curriculum/s01_v6b_online/checkpoints/episode_003_updates_300.zip | 111106943 | 2026-11-08T22:17:19 | 1 | a1a50fca6d255bb33a3b9312eb7dfb14faf8da765bba2d331e5e8569c23b3d89
curriculum/s01_v6b_online/checkpoints/episode_004_updates_400.critic_ln.pt | 1193559 | 2026-11-08T22:17:20 | 1 | 4a0aa65a2adad55e3cacdeddad4b4e74d9233de0c3aba605260da09aef3ea03a
curriculum/s01_v6b_online/checkpoints/episode_004_updates_400.zip | 111106943 | 2026-11-08T22:17:20 | 1 | 053ca5cfd29e596f0f33dcdd84125a60ae02dc8fe1e6c5cf6159f2399ca687fc
curriculum/s01_v6b_online/checkpoints/episode_005_updates_500.critic_ln.pt | 1193559 | 2026-11-08T22:17:21 | 1 | 62742eabc0b53277ba38e6a19784b41965ca1ad7bb7154da3b6f9e293197ad98
curriculum/s01_v6b_online/checkpoints/episode_005_updates_500.zip | 111106943 | 2026-11-08T22:17:21 | 1 | f1bfc2d44eca78de94f1afa115d9b17075e4854d3a1d78787271c71b56778e09
curriculum/s01_v6b_online/checkpoints/episode_006_updates_600.critic_ln.pt | 1193559 | 2026-11-08T22:17:22 | 1 | 43d3a4b2d18d174f0a6a640ca95baee3e4649c4f64c40025a26592cf0ec424d6
curriculum/s01_v6b_online/checkpoints/episode_006_updates_600.zip | 111106943 | 2026-11-08T22:17:22 | 1 | 1a5a7b553d27da27511df8165a55166d2bf19111b2a5d7e9c6a726891727910f
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
curriculum/s01_v6b_online/checkpoints/episode_047_updates_104612.zip | 111114971 | 2026-11-08T22:31:53 | 1 | 5ea6999b8500daadfc8a7fbc158c2c27f6fb236bab1f38f507ebfab4496d6709
curriculum/s01_v6b_online/checkpoints/episode_049_updates_105308.critic_ln.pt | 1193697 | 2026-11-08T22:32:54 | 1 | c8bd22f0752ce7135570590472a7e84161e3a631cb438a043d0f2ab602143a05
curriculum/s01_v6b_online/checkpoints/episode_049_updates_105308.zip | 111114971 | 2026-11-08T22:32:55 | 1 | 85edf6cc128e371f4e9f139beb37026f16e73056b69f9fc3cf1ba6a603960d58
curriculum/s01_v6b_online/checkpoints/episode_050_updates_109908.critic_ln.pt | 1193697 | 2026-11-08T22:33:27 | 1 | 2e29c346acee6828c52491ff1d6cc9be194d88aaf72cf3d8ac498fa65983b940
curriculum/s01_v6b_online/checkpoints/episode_050_updates_109908.zip | 111115271 | 2026-11-08T22:33:27 | 1 | 834470b6d181615c230dbbd85e5dc652b2ca9c8945bb28e8c27ab4fc14d0b58f
curriculum/s01_v6b_online/checkpoints/episode_052_updates_114476.critic_ln.pt | 1193697 | 2026-11-08T22:34:28 | 1 | a1429445925a00aef0e52ffed4986bbe08baa99b25b7d5734c4e65107aa7de0c
curriculum/s01_v6b_online/checkpoints/episode_052_updates_114476.zip | 111115723 | 2026-11-08T22:34:28 | 1 | c0a60de04fe88c8f5e7259e89e83497fc12b0cd7fa488fb980f942fadcd53f19
curriculum/s01_v6b_online/checkpoints/episode_053_updates_115036.critic_ln.pt | 1193697 | 2026-11-08T22:34:50 | 1 | 6137a77fa9a95d77a7f8b4c2e7a133a694a00cb3a14b3177ec7a131e6d2b81d6
curriculum/s01_v6b_online/checkpoints/episode_053_updates_115036.zip | 111115723 | 2026-11-08T22:34:51 | 1 | 31f060072000f88577b7b39da7383dfb79ece5302d0c53668cc3dc6b82f37c4e
curriculum/s01_v6b_online/checkpoints/episode_054_updates_116044.critic_ln.pt | 1193697 | 2026-11-08T22:35:09 | 1 | 486f3603b1cc7260c2efdb7adb5307b7dd8eb79a1381c6687f105397dcb4589d
curriculum/s01_v6b_online/checkpoints/episode_054_updates_116044.zip | 111115463 | 2026-11-08T22:35:09 | 1 | cc5dbae05030ec66b943845c32ced180339f94019f69e46d84c3a60ae6f81b79
curriculum/s01_v6b_online/checkpoints/episode_055_updates_120644.critic_ln.pt | 1193697 | 2026-11-08T22:35:42 | 1 | dcc82e8f4d5b7ab6707ec16b74abaf598757358be52733babc3775b7d9deaf72
curriculum/s01_v6b_online/checkpoints/episode_055_updates_120644.zip | 111116175 | 2026-11-08T22:35:42 | 1 | fccd62d5f2b66264005047b5877f85c450c7d4af122b9fcdbda9b024dd0c87a1
curriculum/s01_v6b_online/checkpoints/episode_056_updates_121844.critic_ln.pt | 1193697 | 2026-11-08T22:35:51 | 1 | 02a101e9c50db34c72c7894424483b3633937165cb7377a28f8b62ebd9cebc18
curriculum/s01_v6b_online/checkpoints/episode_056_updates_121844.zip | 111116175 | 2026-11-08T22:35:51 | 1 | fdf9611b88f08a62af999597bef16511e28ca15115791893f9b1810c8a2aa88c
curriculum/s01_v6b_online/checkpoints/episode_059_updates_124772.critic_ln.pt | 1193697 | 2026-11-08T22:37:35 | 1 | 9a2dcd9bee2bb62e5621a3fb7e1f735c33e72b105727594fd75e1d1d7726c266
curriculum/s01_v6b_online/checkpoints/episode_059_updates_124772.zip | 111116475 | 2026-11-08T22:37:35 | 1 | 5c923a0b30b2be2e3dffccb4eba498bb9505307b2d1fd5c47c5a979b14b885a3
curriculum/s01_v6b_online/episode_000.npz | 27989 | 2026-11-08T22:15:16 | 0
curriculum/s01_v6b_online/episode_001.npz | 40475 | 2026-11-08T22:15:30 | 0
curriculum/s01_v6b_online/episode_002.npz | 62785 | 2026-11-08T22:15:59 | 0
curriculum/s01_v6b_online/episode_003.npz | 52600 | 2026-11-08T22:16:22 | 0
curriculum/s01_v6b_online/episode_004.npz | 68852 | 2026-11-08T22:16:41 | 0
curriculum/s01_v6b_online/episode_005.npz | 14394 | 2026-11-08T22:16:50 | 0
curriculum/s01_v6b_online/episode_006.npz | 60277 | 2026-11-08T22:17:18 | 0
curriculum/s01_v6b_online/episode_007.npz | 19279 | 2026-11-08T22:17:30 | 0
curriculum/s01_v6b_online/episode_008.npz | 34358 | 2026-11-08T22:17:47 | 0
curriculum/s01_v6b_online/episode_009.npz | 73376 | 2026-11-08T22:18:05 | 0
curriculum/s01_v6b_online/episode_010.npz | 68460 | 2026-11-08T22:18:45 | 0
curriculum/s01_v6b_online/episode_011.npz | 75336 | 2026-11-08T22:19:24 | 0
curriculum/s01_v6b_online/episode_012.npz | 24624 | 2026-11-08T22:19:34 | 0
curriculum/s01_v6b_online/episode_013.npz | 22481 | 2026-11-08T22:19:48 | 0
curriculum/s01_v6b_online/episode_014.npz | 73893 | 2026-11-08T22:20:06 | 0
curriculum/s01_v6b_online/episode_015.npz | 63126 | 2026-11-08T22:20:39 | 0
curriculum/s01_v6b_online/episode_016.npz | 52970 | 2026-11-08T22:21:02 | 0
curriculum/s01_v6b_online/episode_017.npz | 31352 | 2026-11-08T22:21:15 | 0
curriculum/s01_v6b_online/episode_018.npz | 43122 | 2026-11-08T22:21:31 | 0
curriculum/s01_v6b_online/episode_019.npz | 74158 | 2026-11-08T22:21:50 | 0
curriculum/s01_v6b_online/episode_020.npz | 77343 | 2026-11-08T22:22:36 | 0
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
curriculum/versions/ppo_ecE/checkpoints/ppo_2829920_steps.zip | 511154 | 2026-11-09T01:25:54 | 1 | b7b4307ca281bb4367d0a5d64b30181417c437756425378fc00a03e970065658
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
