crasni/rotary-inverted-pendulum/docs/run-history/metadata/curriculum/s01_v6b_online/learner_log/progress.csv

train/critic_loss | train/ent_coef | train/n_updates | train/anchor_loss | train/ent_coef_loss | train/actor_loss | train/learning_rate
12.351721922556559 | 0.15466099108258882 | 616749 | 0.060635020257905126 | -0.18471738696098328 | -174.19268925984701 | 0.0001
13.330365657806396 | 0.1518042509754499 | 618749 | 0.09168137641002734 | -0.21457188669592142 | -185.38489278157553 | 0.0001
15.813470125198364 | 0.14971590538819632 | 620749 | 0.12614000930140415 | -0.06493786225716273 | -195.80715815226236 | 0.0001
16.798317909240723 | 0.1472217378516992 | 622749 | 0.15967933678378662 | -0.19437420244018236 | -197.83724085489908 | 0.0001
19.53586483001709 | 0.14459090183178583 | 624749 | 0.1468067051221927 | -0.17502258190264305 | -207.0665715535482 | 0.0001
20.22461732228597 | 0.14233903711040816 | 626749 | 0.148463927830259 | -0.10683039544771115 | -213.10002772013345 | 0.0001
20.88527774810791 | 0.14055471370617548 | 628749 | 0.1467715948820114 | -0.13828388151402274 | -219.3721466064453 | 0.0001
22.370508988698322 | 0.13934384162227312 | 630749 | 0.13512171804904938 | -0.08046689846863349 | -225.27671432495117 | 0.0001
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
