crasni/rotary-inverted-pendulum/docs/run-history/metadata/archive/README.md

# Archived runs (2026-11-08 03:53)

Moved here because they hold no usable result: the motor never ran, the run was cancelled or interrupted, or a sensor fault cut it short. Nothing was deleted; move a folder back to `runs/` to restore it.

| Run | Why |
|---|---|
| `custom_lqrdither_20261107_204719` | RuntimeError: Firmware safety fault latched (bits=2); inspect before r (samples 0) |
| `custom_lqrdither_20261107_205245` | SerialException: [Errno 2] could not open port /dev/ttyUSB0: [Errno 2] (samples 0) |
| `lqr_coupling_delay_20261108_000207` | RuntimeError: Non-finite feedback (firmware fault bits=2, encoder) (samples 159) |
| `lqr_coupling_delay_20261108_000854` | SerialException: [Errno 2] could not open port /dev/ttyUSB0: [Errno 2] (samples 0) |
| `lqr_coupling_delay_20261108_000913` | RuntimeError: Non-finite feedback (firmware fault bits=2, encoder) (samples 141) |
| `lqr_coupling_delay_20261108_000928` | RuntimeError: Non-finite feedback (firmware fault bits=2, encoder) (samples 127) |
| `lqr_coupling_delay_20261108_000953` | RuntimeError: Non-finite feedback (firmware fault bits=2, encoder) (samples 167) |
| `lqr_coupling_delay_20261108_001013` | RuntimeError: Non-finite feedback (firmware fault bits=2, encoder) (samples 181) |
| `lqr_coupling_delay_20261108_001032` | RuntimeError: Non-finite feedback (firmware fault bits=2, encoder) (samples 120) |
| `lqr_coupling_delay_20261108_001527` | RuntimeError: Non-finite feedback (firmware fault bits=2, encoder) (samples 106) |
| `lqr_coupling_delay_20261108_001543.` | RuntimeError: Non-finite feedback (firmware fault bits=2, encoder) (samples 119) |
| `lqr_coupling_delay_20261108_001600` | RuntimeError: Powered run cancelled (samples 0) |
| `lqr_coupling_delay_20261108_001608` | RuntimeError: Non-finite feedback (firmware fault bits=2, encoder) (samples 163) |
| `lqr_coupling_delay_20261108_025531` | RuntimeError: Firmware safety fault latched (bits=2); inspect before r (samples 0) |
| `lqr_coupling_delay_20261108_025545` | RuntimeError: Firmware safety fault latched (bits=2); inspect before r (samples 0) |
| `lqr_coupling_delay_20261108_025813` | RuntimeError: Non-finite feedback (firmware fault bits=2, encoder) (samples 207) |
| `lqr_coupling_delay_20261108_025945` | RuntimeError: Firmware READY handshake failed (samples 0) |
| `lqr_hw_17` | RuntimeError: Non-finite feedback (samples 265) |
| `lqr_swing_20261107_025003` | KeyboardInterrupt:  (samples 1128) |
| `sac_W2_20261107_205411` | RuntimeError: Start requires a physically centered arm and still hangi (samples 0) |
| `sac_v2m2_20261108_031006` | no summary (never started / load failed) |
| `sac_v2m2_20261108_031340` | RuntimeError: Firmware safety fault latched (bits=2); inspect before r (samples 0) |
| `sac_v2m2_20261108_031741` | no summary (never started / load failed) |
| `sac_v2m2_20261108_031758` | KeyboardInterrupt:  (samples 0) |
| `sac_v2m2_20261108_031911` | KeyboardInterrupt:  (samples 352) |
| `sac_v2m2_20261108_031931` | RuntimeError: Powered run cancelled (samples 0) |
| `sac_v2m2_20261108_032213` | no summary (never started / load failed) |
| `curriculum/e03_v2_lqrbalance_det` | 0 episodes: encoder fault before the first episode |
| `curriculum/e03b_v2_lqrbalance_det` | 0 episodes: encoder fault before the first episode |
| `curriculum/e03c_v2_lqrbalance_det` | 0 episodes: encoder fault before the first episode |
| `sac_v6b_20261108_041929` | runner could not load v6b_runner (anchor wrapper saved in checkpoint; fixed) |
| `sac_v6b_20261108_041936` | runner could not load v6b_runner (anchor wrapper saved in checkpoint; fixed) |
